Angelpele/Integrated_FOC_BLDC_Actuator/Hardware/Buck Converter.xlsx

Sheet: 16 to 5
Data | Value | Considerations | Operations |  | Real Values
Input Voltage (V) | 16 |  | R(RT/CLK) (KΩ) | 200.01 |  | #VALUE! |  |  | Pin RT_CLK pull down
Output Voltage (V) | 5 |  | Lo min Inductance (H) | 1.305792972e-05 | 1.2e-05 | #VALUE! |  |  |  | Max current rating 100% + Kind of max output
Switching freq (kHz) | 585 | 100 - 2500, the higher more heat | R1 (KΩ) | 52.50 | 52.3 | #VALUE! |  |  | Value for Vsense and obtain correct Vout
Kind | 0.3 | % over max current for ind, decrease for lower ripple | R2 (KΩ) | 10.00 |  | Modify R2 to obtain a proper value for R1
Vref (Slow start) (V) | 0.8 |  | Css (nF) | 15.62
Iss (Slow start current) (uA) | 2 |  | δ (Duty Cycle) | 0.37
tss (Slow start time) (ms) | 5 |  | Max ripple current (mA) | 489.67 |  | #VALUE!
Efficiency | 85% |  | Max voltage ripple (mV) | 50.00 |  | 50 mV for Vout 5V |  | 160mV for 16V
Max Output Current (mA) | 1500 |  | Peak current (mA) | 1744.84 |  | Isat > Ipeak
Resr (mΩ) | 58 |  | Cout (uF) | 20.92617 | 22 | #VALUE! |  |  | Choose largest between both
fc (khz) | 50 | loop BW | Cout (uF) | 23.31002 | 23 | #VALUE! |  |  |  |  | Using ripple current, variation of Iout to 50% of max range
gm(ps) (A/V) | 6 | For this chip
gm(EA) (uA/V) | 97 | For this chip | Reverse voltage max diode | 60 V | B360 | Must be greater than Vin |  |  | Current greater than max out currrent
 |  |  | Gmod(fc) | 0.74 |  | #VALUE!
Rds (on) (Ω) | 0.0024 | For 16V from mosfet | Ro (Ω) = Rload | 3.33
Ids max of mosfet | 40.00 | Limit to 40A | fp (Hz) | 2170.29 |  | #VALUE! |  |  | Power stage pole
Vds (on) | 0.096 | For OC_ADJ pin | fc | 58.50 |  | Second pole | Sw freq / 10
 |  |  | fLC (kHz) or fz1 | 9.80
 |  |  | R3 (kΩ) = Rc | 86.84 | 0402 | #VALUE!
 |  |  | C1 (pF) = Cf (Parallel) | 14.69 |  | #VALUE!
 |  |  | C2 (pF) = Cc (Series) | 844.47 | 1nF | #VALUE!
 |  |  | Cout (RMS current) (mA) | 141.36
 |  |  | Variation Vout | 0.0025

Sheet: 36 to 16
Data | Value | Considerations | Operations |  | Real Values
Input Voltage (V) | 36 |  | R(RT/CLK) (KΩ) | 200.01 |  | #VALUE! | Pin RT_CLK pull down
Output Voltage (V) | 16 |  | Lo min Inductance (H) | 1.857127783e-05 | 2e-05 | #VALUE! |  | Max current rating 100% + Kind of max output
Switching freq (kHz) | 585 | 100 - 2500, the higher more heat | R1 (KΩ) | 190.00 | 52.3
Kind | 0.3 | % over max current for ind | R2 (KΩ) | 10.00
Vref (Slow start) (V) | 0.8 |  | Css (nF) | 15.62
Iss (Slow start current) (uA) | 2 |  | δ (Duty Cycle) | 0.52
tss (Slow start time) (ms) | 5 |  | Max ripple current (mA) | 893.80 |  | (Vin – Vout) × D / (L × f_sw)
Efficiency | 85% |  | Max voltage ripple (mV) | 51.84
Max Output Current (mA) | 1500 |  | Peak current (mA) | 1946.90 |  | Isat > Ipeak
Resr (mΩ) | 58 |  | Cout (uF) | 1.58548 | 49 | 0.09892241379
fc (khz) | 50 | loop BW | Ro (Ω) | 10.67
 |  |  | fp (kHz) | 304.51 |  | Power stage pole
 |  |  | fp2 (kHz) | 292.50 |  | Second pole
 |  |  | fLC (kHz) or fz1 | 5.08
 |  |  | R3 (kΩ) | 15.00
Rds (on) (Ω) | 0.0024 | For 16V from mosfet | C1 (nF) | 2.09
Ids max of mosfet | 40.00 | Limit to 40A | C2 (pF) | 36.27
Vds (on) | 0.096 | For OC_ADJ pin | Cout (RMS current) (mA) | 258.02
 |  |  | Variation Vout | 0.0025

Sheet: Sheet1
Data | Value | Considerations | Operations |  | Real Values
Input Voltage (V) | 16 |  | R(RT/CLK) (KΩ) | 200.01
Output Voltage (V) | 5 |  | R1 (KΩ) | 52.50 | 52.3
Switching freq (kHz) | 585 | 100 - 2500 | R2 (KΩ) | 10.00
Vref (Slow start) (V) | 0.8 |  | Css (nF) | 15.62
Iss (Slow start current) (uA) | 2 |  | δ (Duty Cycle) | 0.37
tss (Slow start time) (ms) | 5 |  | Lo min Inductance (H) | 1.305792972e-05 | 1.2e-05
Efficiency | 85% |  | Max ripple current (mA) | 576.09 |  | (Vin – Vout) × D / (L × f_sw)
Output Current (mA) | 1500 |  | Max voltage ripple (mV) | 33.41
Resr (mΩ) | 58 |  | Peak current (mA) | 1788.04 |  | Isat > Ipeak
fc (khz) | 50 | loop BW | Cout (uF) | 0.49121 | 49 | 0.1534796238
 |  |  | Ro (Ω) | 3.33
 |  |  | fp (kHz) | 974.42 |  | Power stage pole
 |  |  | fp2 (kHz) | 292.50 |  | Second pole
 |  |  | fLC (kHz) or fz1 | 6.56
 |  |  | R3 (kΩ) | 15.00
Rds (on) (Ω) | 0.0024 | For 16V from mosfet | C1 (nF) | 1.62
Ids max of mosfet | 40.00 | Limit to 40A | C2 (pF) | 36.27
Vds (on) | 0.096 | For OC_ADJ pin | Cout (RMS current) (mA) | 166.30
 |  |  | Variation Vout | 0.0025
