Angelpele/Integrated_FOC_BLDC_Actuator/Mechanical/Cycloidal Drive Calculations.xlsx

Data | Value
Np (fixed pins / rollers) | 15 |  | Raducation Ratio | -0.07142857143 | :1
Nd (Lobes of disc) | 14 |  | Reduction Ratio | 14 | :1
No (Out pins) | 7
Input Volt Max V | 40 | Output RPM | 13600 | KV x V |  | Output RPM | 971.4285714
Input Volt V | 16.4 | Output RPM | 5576 |  |  | Output RPM | 398.2857143
Motor KV | 340 | Kt | 0.0281 |  |  | * No effect num discs
 | * 340KV
Input Current Max A | 40 | Torque Nm | 1.12 | Kt x i |  | Torque Nm | 28.31
Input Current A | 20 | Torque Nm | 0.56 |  |  | Torque Nm | 14.16
Efficiency | 0.9
Num discs (Phase Type) | 2
