Angelpele/Integrated_FOC_BLDC_Actuator/Hardware/ESP32_Motor_Controller/ESP32_Motor_Controller_V2.csv

Id | Footprint | Quantity | Designation | Total | Personal Stock | BUY / HIVE
2 | 0201 | 1 | PESDNC2 | 8 | 0 | 8
3 | 0402 | 1 | 3.3k | 8 | 0 | 8 | Number of boards | 8
4 | 0402 | 1 | 0.015uF | 8 | 0 | 8 | Number of hover boards | 2
5 | 0402 | 14 | 0.1 uF | 112 | 0 | 112
6 | 0402 | 1 | 200k | 8 | 0 | 8
7 | 0402 | 3 | 0R | 24 | 0 | 24
8 | 0402 | 2 | 1k | 16 | 0 | 16
9 | 0402 | 9 | 10k | 72 | 0 | 72
10 | 0402 | 2 | 2.2nF | 16 | 0 | 16
11 | 0402 | 4 | 100k | 32 | 0 | 32
12 | 0402 | 1 | 1.6nF | 8 | 0 | 8
13 | 0402 | 1 | 36pF | 8 | 0 | 8
14 | 0402 | 2 | 560pF | 16 | 0 | 16
15 | 0402 | 1 | 15k | 8 | 0 | 8
16 | 0402 | 2 | 56 | 16 | 0 | 16
17 | 0402 | 2 | 1nF | 16 | 0 | 16
18 | 0402 | 1 | 4k7 | 8 | 0 | 8
19 | 0402 | 1 | 0.022uF | 8 | 0 | 8
20 | 0603 | 4 | LED | 32 | 0 | 32
21 | 0603 | 2 | 10k | 16 | 0 | 16
22 | 0603 | 1 | NTC 10k | 8 | 0 | 8
23 | 0603 | 2 | 100R | 16 | 0 | 16
24 | 0603 | 4 | 1uF | 32 | 0 | 32
25 | 0603 | 6 | 22R | 12 | 0 | 12
26 | 0603 | 6 | 10R | 36 | 0 | 36
27 | 0603 | 1 | 2.2uF | 8 | 0 | 8
28 | 0603 | 2 | 56 | 16 | 0 | 16
29 | 0603 | 1 | 47uF | 8 | 0 | 8
30 | 0603 | 1 | 150 | 8 | 0 | 8
31 | 0603 | 4 | 0.1uF | 32 | 0 | 32
32 | 0603 | 1 | 120R | 8 | 0 | 8
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
