Angelpele/Integrated_FOC_BLDC_Actuator/Firmware/PID_tunning/Torque loop Iq and Id - LPF 0.05, Kp 0.7 Ki 20 Kd 0.png

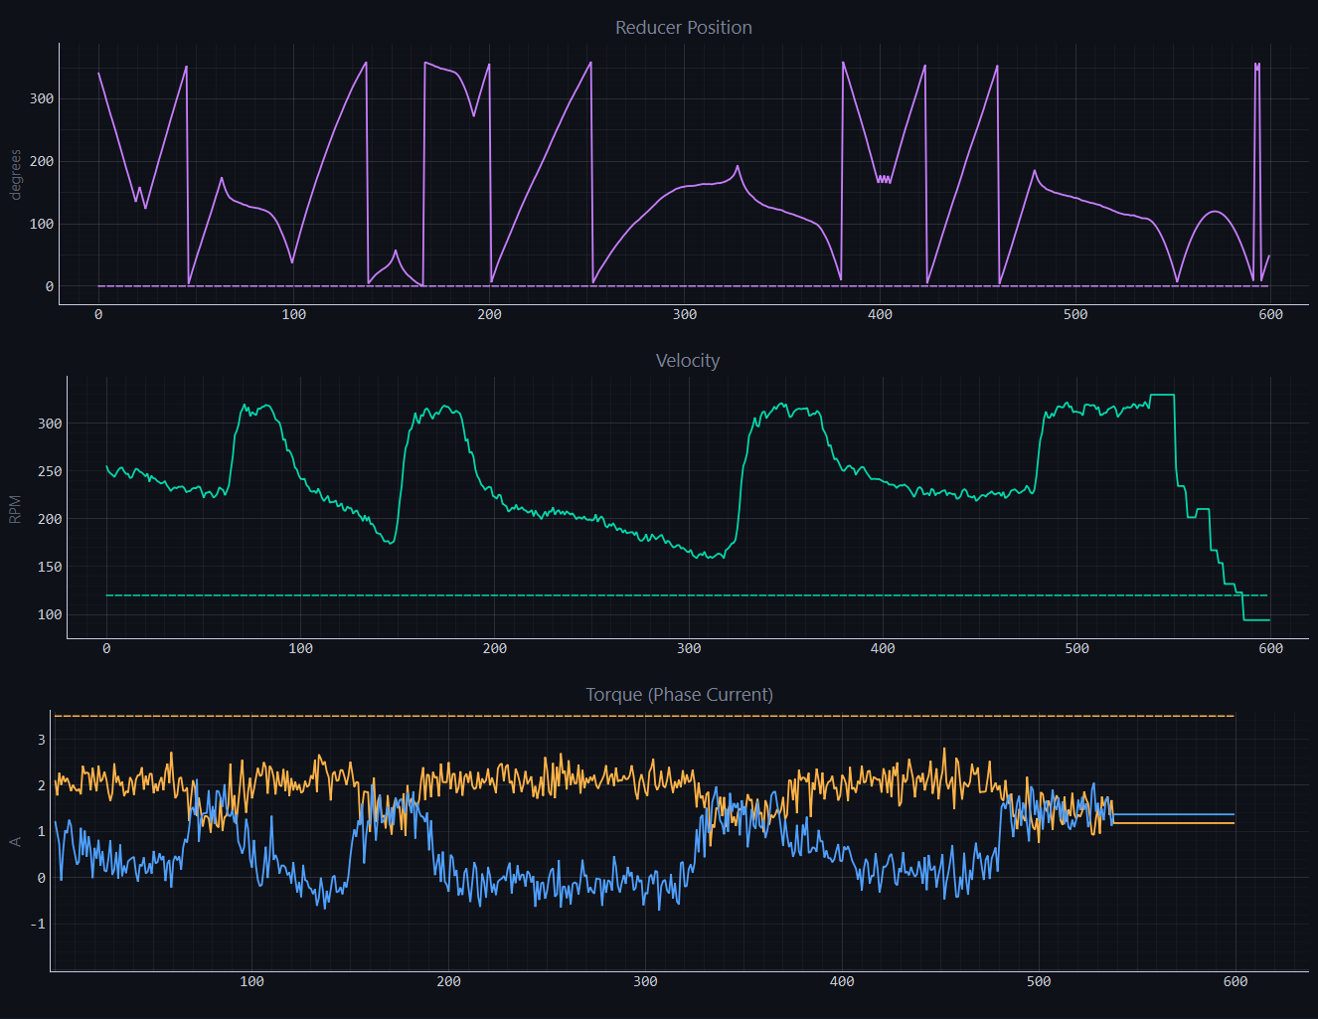
Firmware/PID_tunning/Torque loop Iq and Id - LPF 0.05, Kp 0.7 Ki 20 Kd 0.png
