Angelpele/Integrated_FOC_BLDC_Actuator/Hardware/Typical Application DRV8302 Sch.png

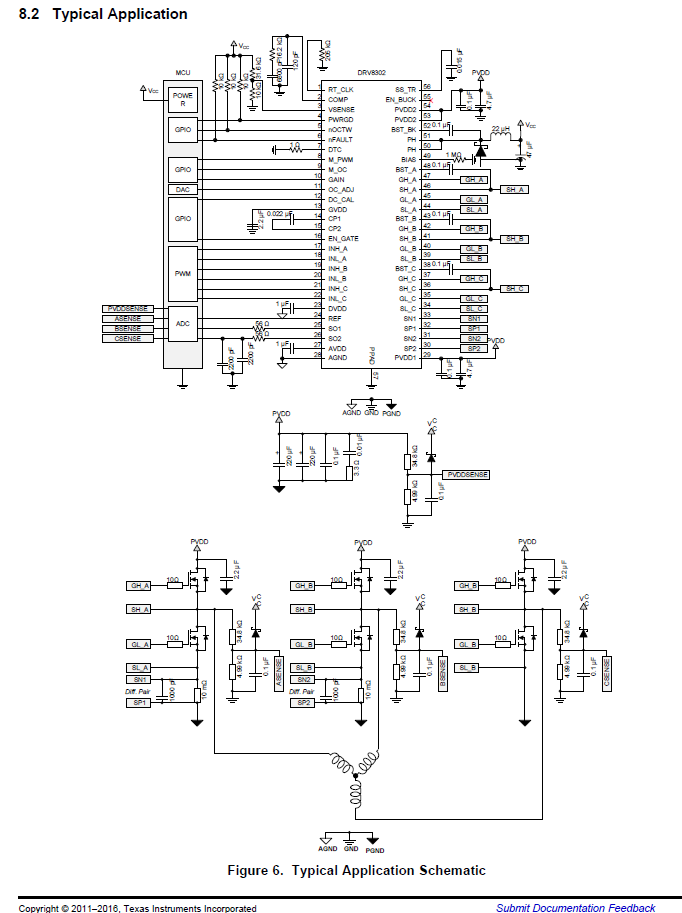
Hardware/Typical Application DRV8302 Sch.png
