Angelpele/Integrated_FOC_BLDC_Actuator/Mechanical/Render_V1.jpg

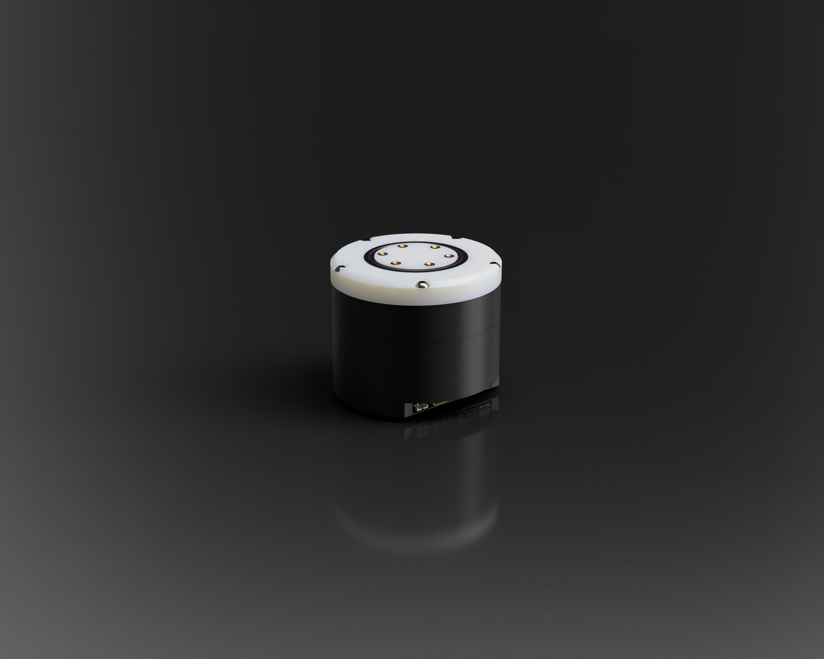
Mechanical/Render_V1.jpg
