Angelpele/Integrated_FOC_BLDC_Actuator/Media/5V_osc_init.jpg

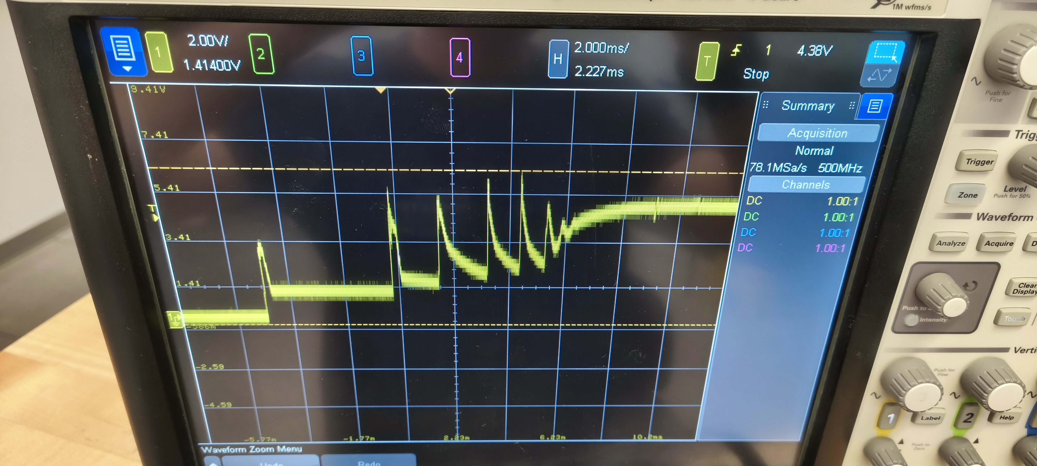
Media/5V_osc_init.jpg
