Angelpele/Integrated_FOC_BLDC_Actuator/Media/1000045218.jpg

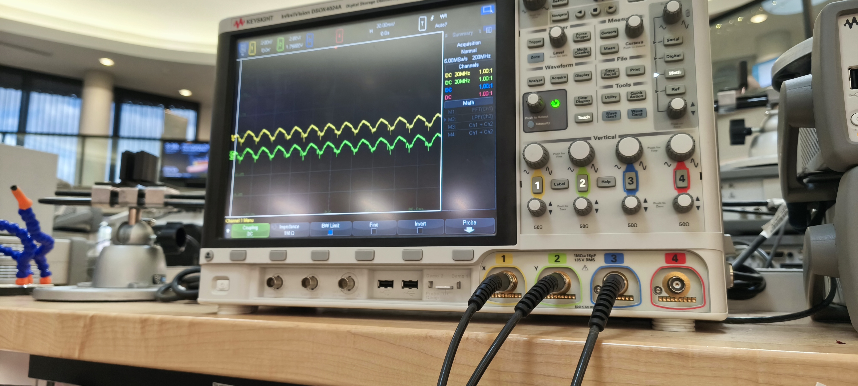
Media/1000045218.jpg
