Angelpele/Integrated_FOC_BLDC_Actuator/Media/1789563761964.jpg

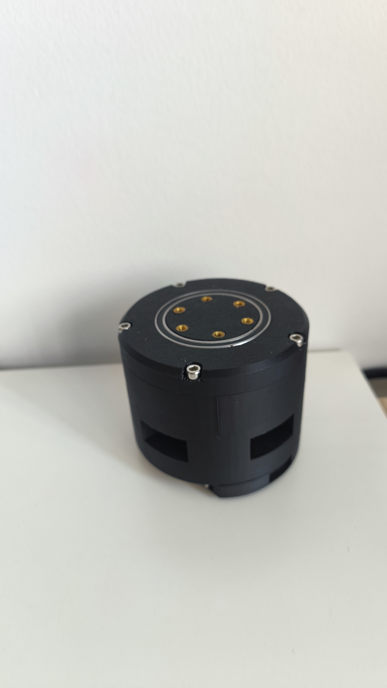
Media/1789563761964.jpg
