Angelpele/Integrated_FOC_BLDC_Actuator/Media/1789563762804.jpg

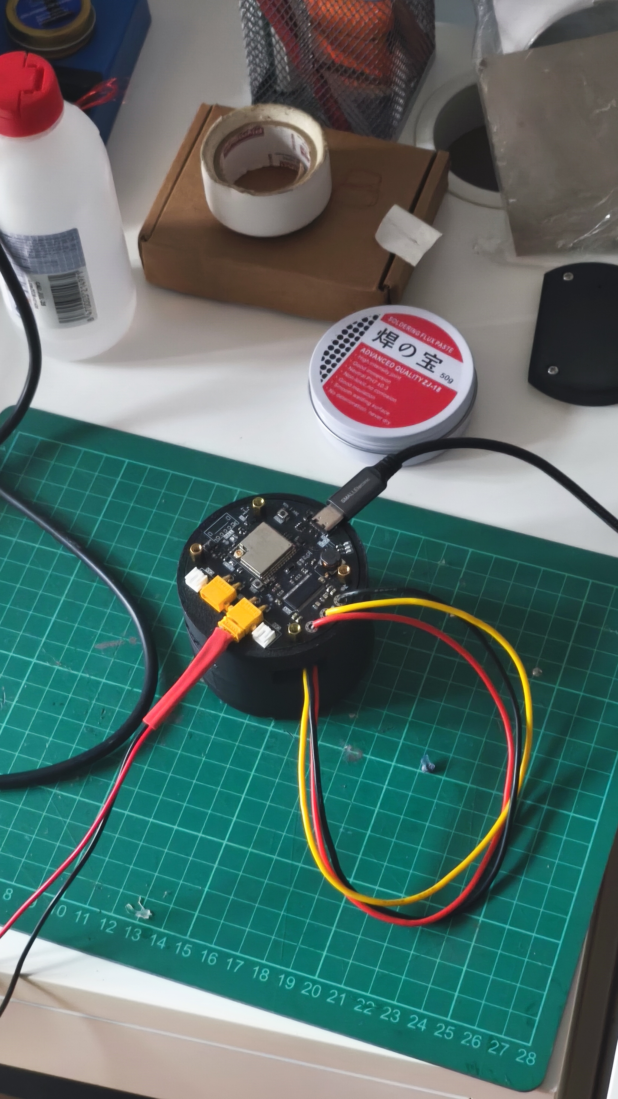
Media/1789563762804.jpg
