Angelpele/Integrated_FOC_BLDC_Actuator/Media/1789563763036.jpg

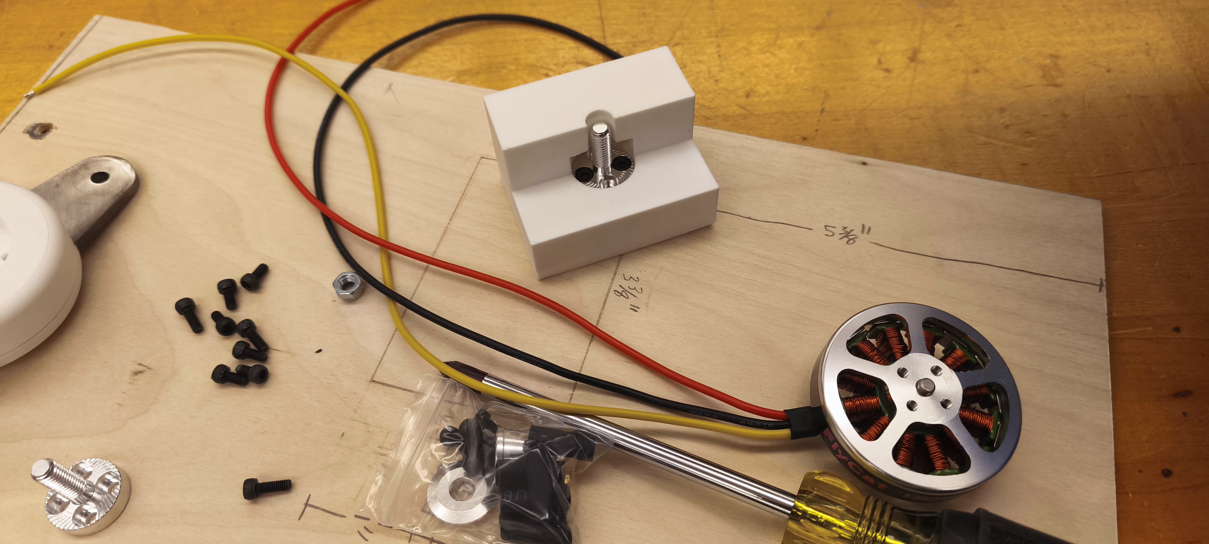
Media/1789563763036.jpg
