Angelpele/Integrated_FOC_BLDC_Actuator/Media/1789563763164.jpg

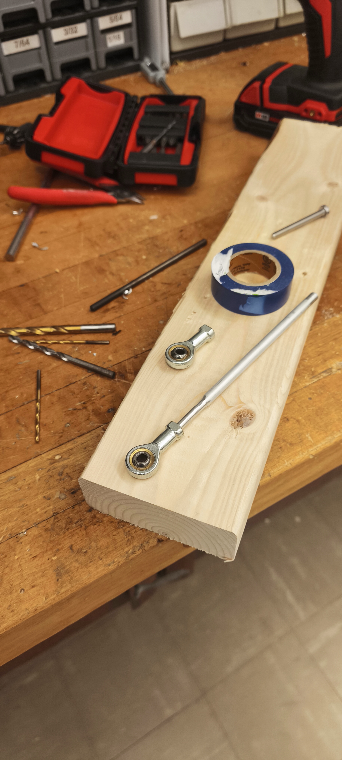
Media/1789563763164.jpg
