Angelpele/Integrated_FOC_BLDC_Actuator/Media/1789563763843.jpg

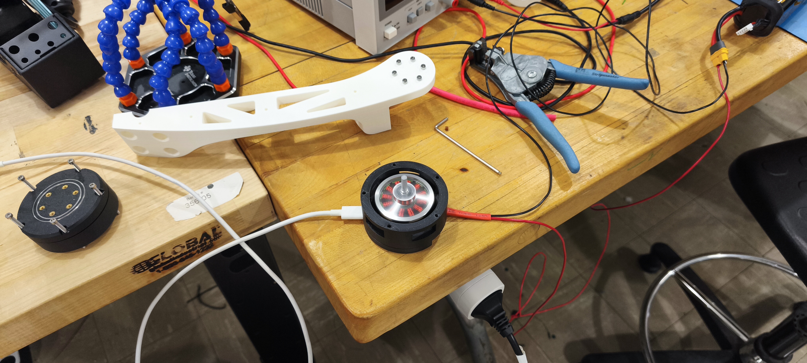
Media/1789563763843.jpg
