Angelpele/Integrated_FOC_BLDC_Actuator/Media/1789563958976.jpg

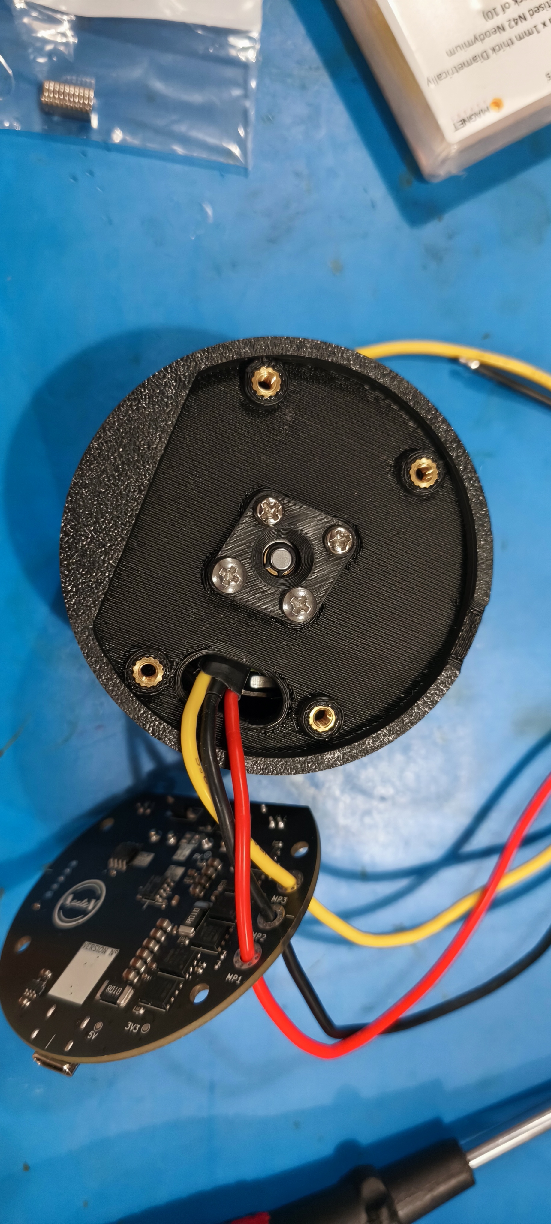
Media/1789563958976.jpg
