Angelpele/Integrated_FOC_BLDC_Actuator/Media/1789563959108.jpg

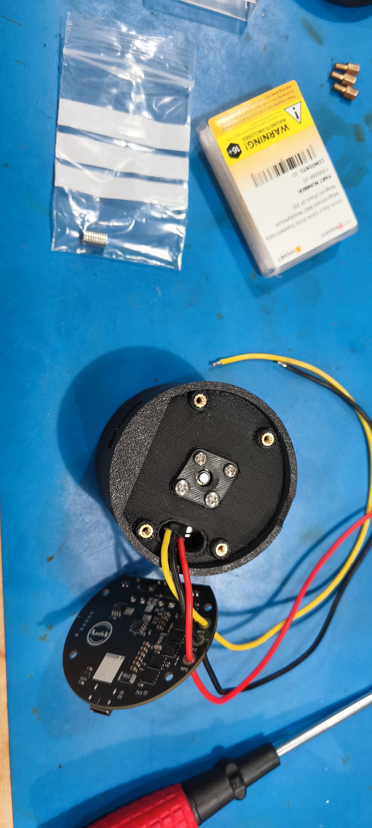
Media/1789563959108.jpg
