Angelpele/Integrated_FOC_BLDC_Actuator/Media/Back View V3.png

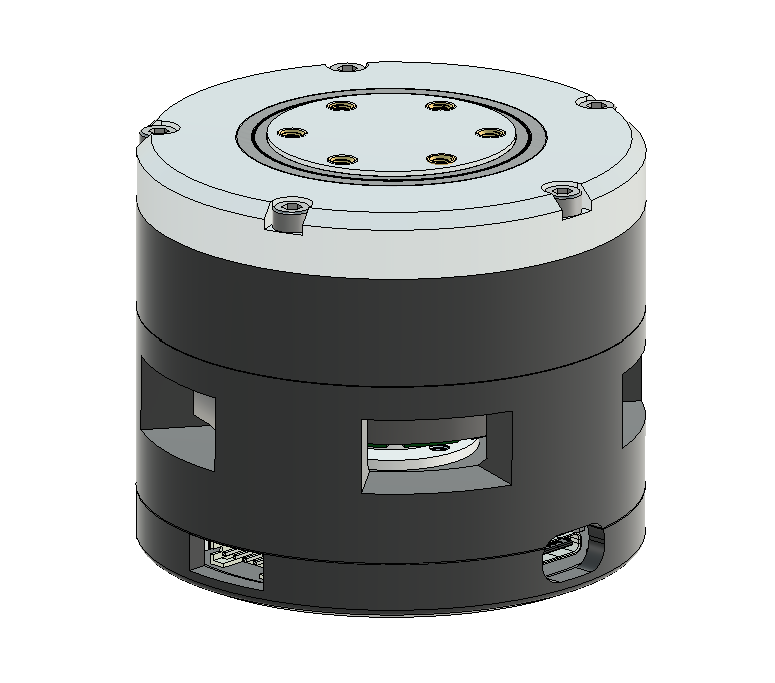
Media/Back View V3.png
