Angelpele/Integrated_FOC_BLDC_Actuator/Media/Bottom_Front View V3.png

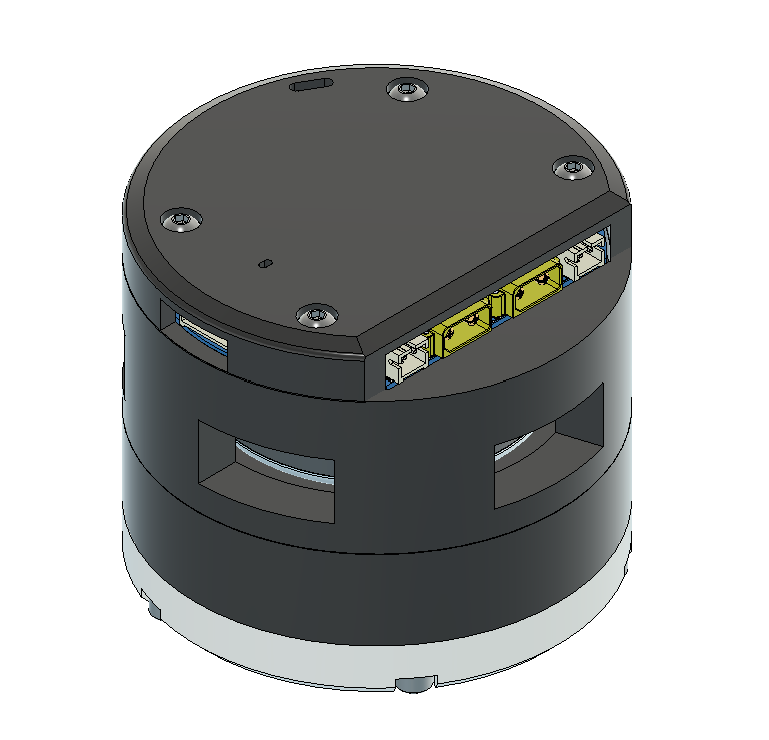
Media/Bottom_Front View V3.png
