Angelpele/Integrated_FOC_BLDC_Actuator/Media/Bottom_Layout_V2.png

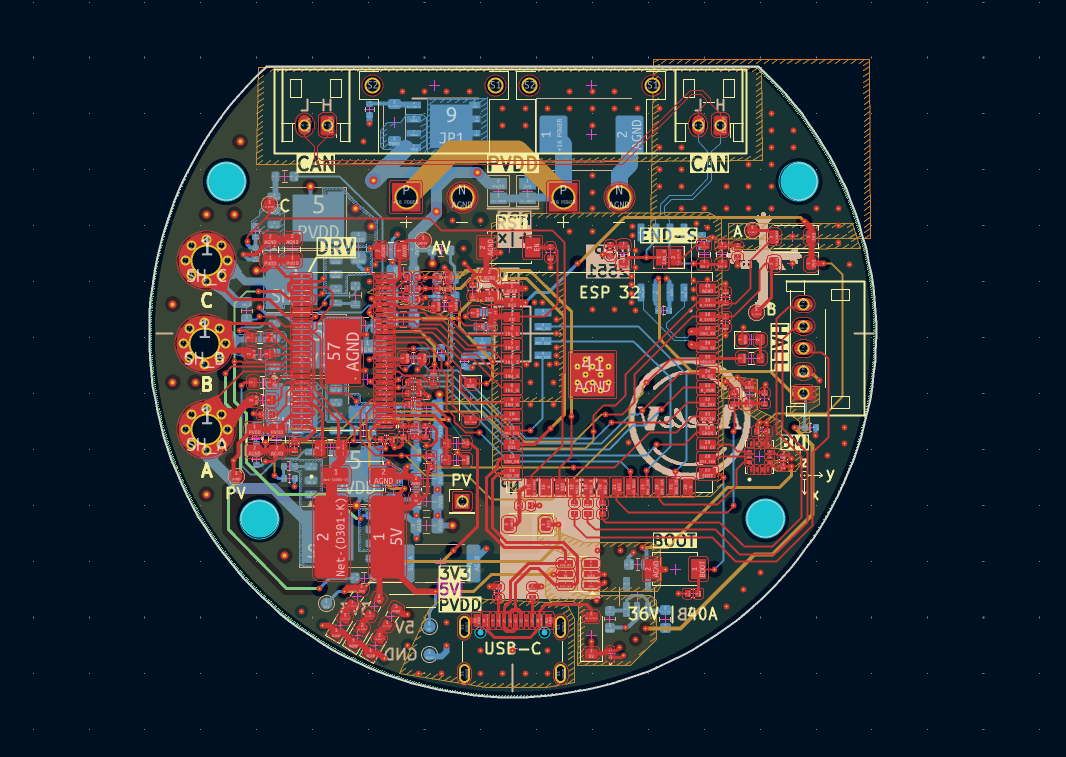
Media/Bottom_Layout_V2.png
