Angelpele/Integrated_FOC_BLDC_Actuator/Media/Capacitor_box.jpg

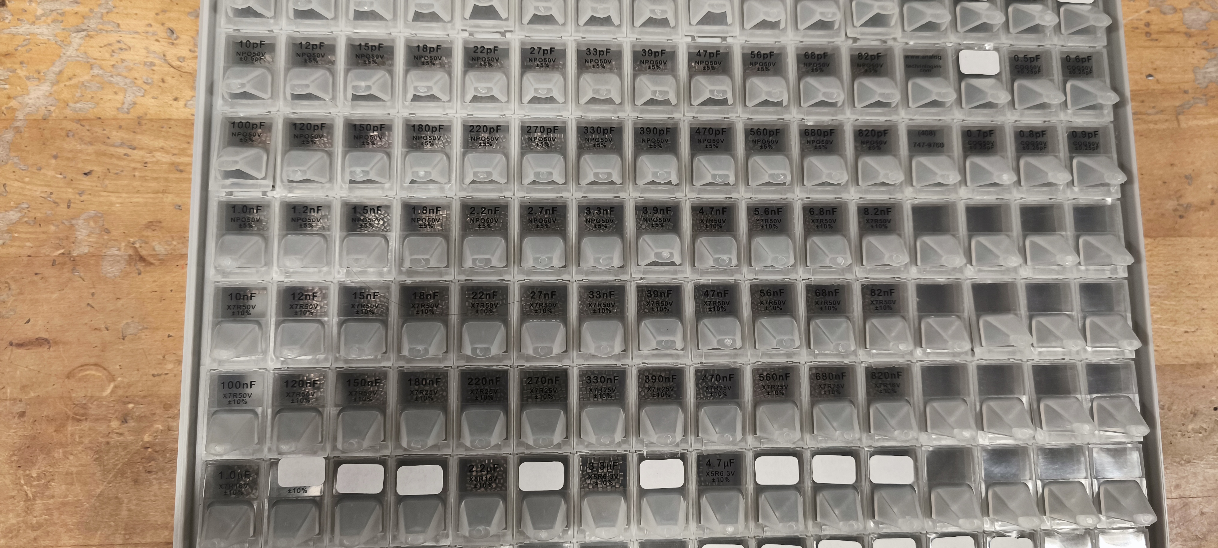
Media/Capacitor_box.jpg
