Angelpele/Integrated_FOC_BLDC_Actuator/Media/Connected_PCB.jpg

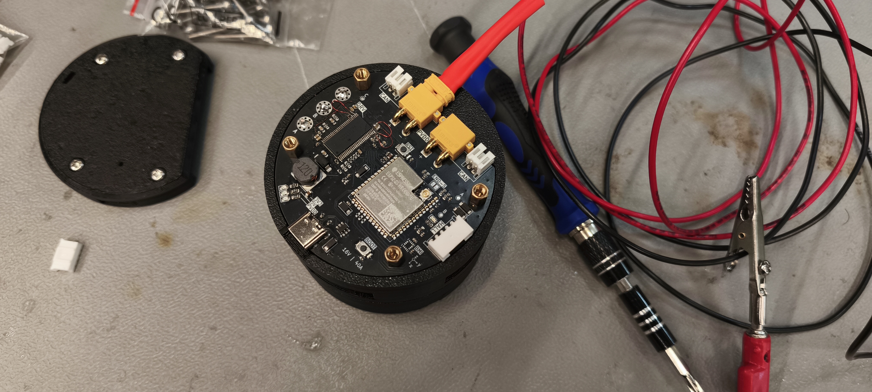
Media/Connected_PCB.jpg
