Angelpele/Integrated_FOC_BLDC_Actuator/Media/Cycloidal Disk.png

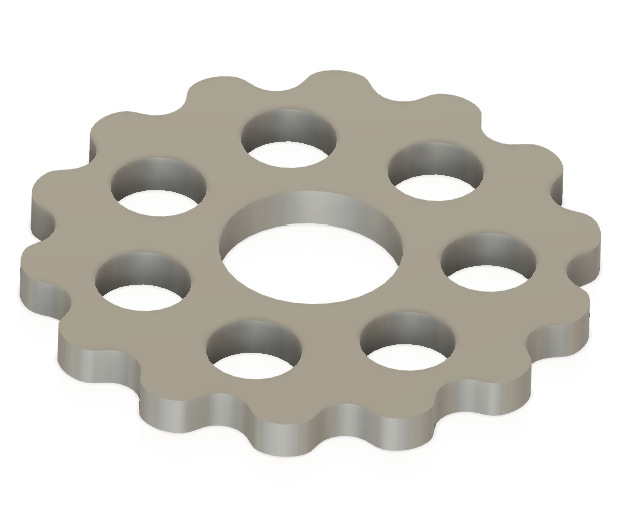
Media/Cycloidal Disk.png
