Angelpele/Integrated_FOC_BLDC_Actuator/Media/Cycloidal Drive Internal.png

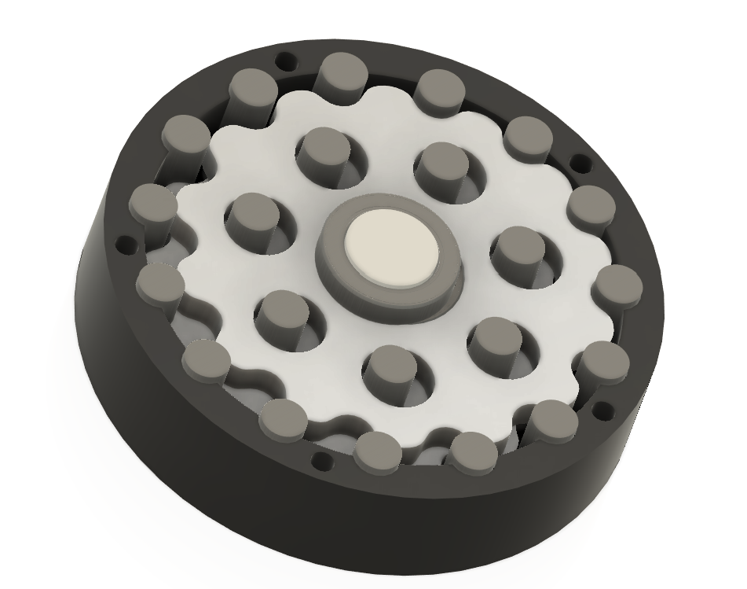
Media/Cycloidal Drive Internal.png
