Angelpele/Integrated_FOC_BLDC_Actuator/Media/Cycloidal Drive Section View V3.png

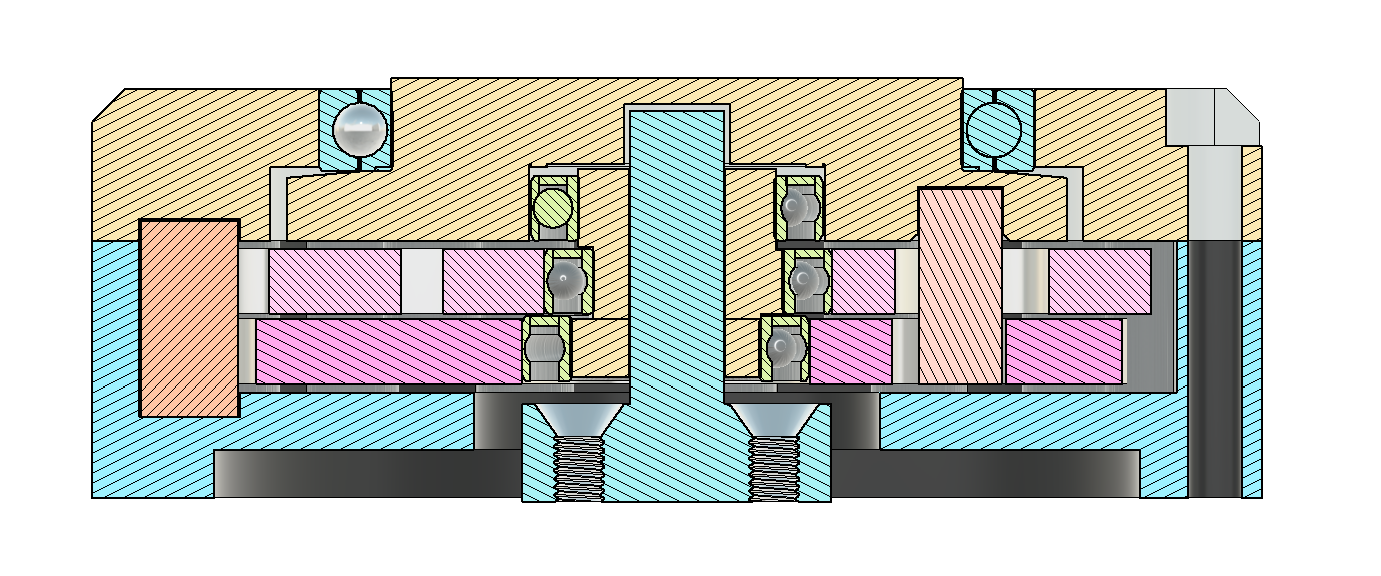
Media/Cycloidal Drive Section View V3.png
