Angelpele/Integrated_FOC_BLDC_Actuator/Media/Cycloidal Drive Section View.png

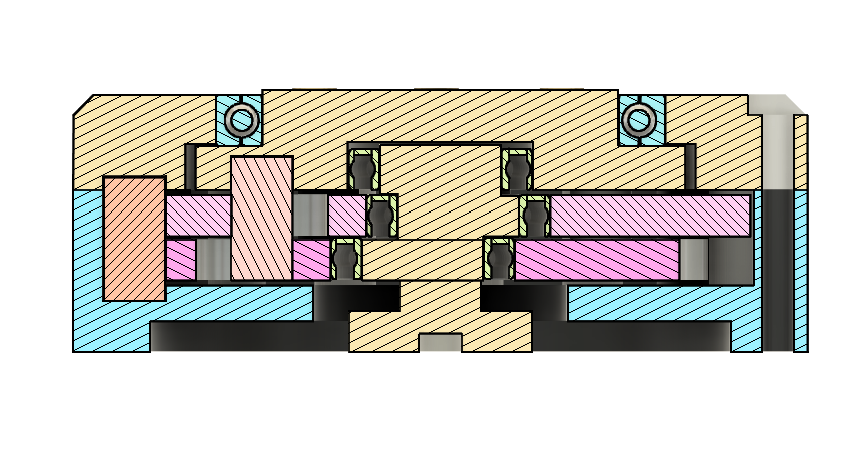
Media/Cycloidal Drive Section View.png
