Angelpele/Integrated_FOC_BLDC_Actuator/Media/D_fillet_creator.jpg

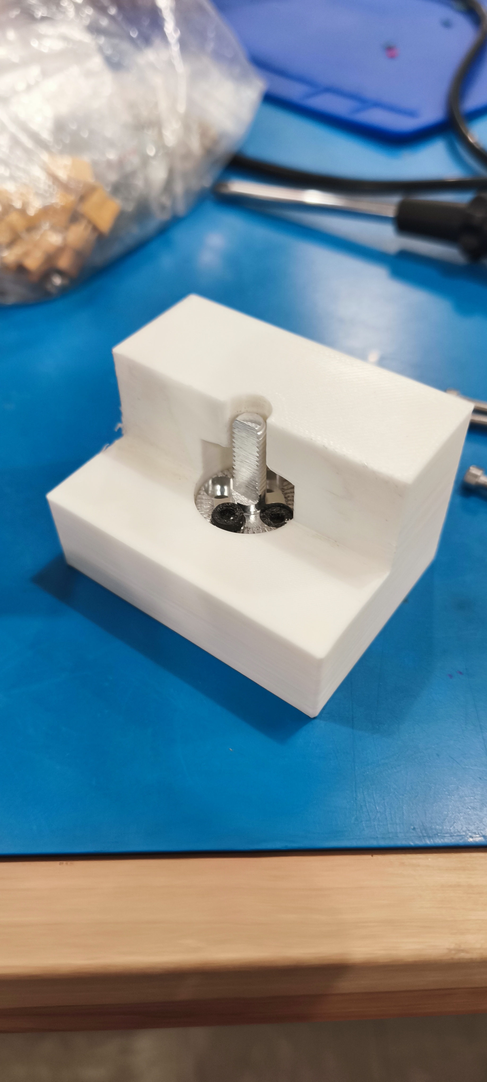
Media/D_fillet_creator.jpg
