Angelpele/Integrated_FOC_BLDC_Actuator/Media/foc_diagram.drawio.png

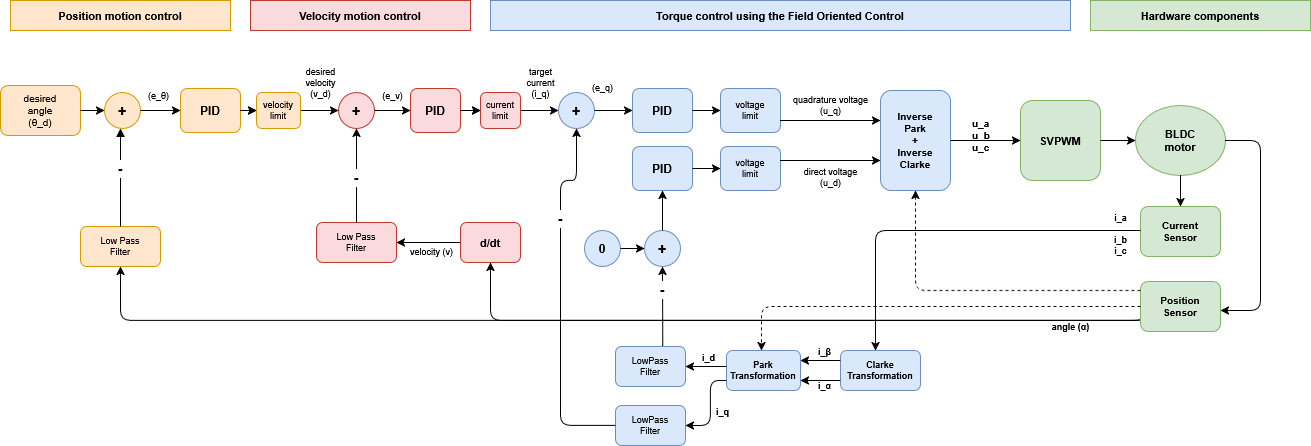
Media/foc_diagram.drawio.png
