Angelpele/Integrated_FOC_BLDC_Actuator/Media/Full_Hive.jpg

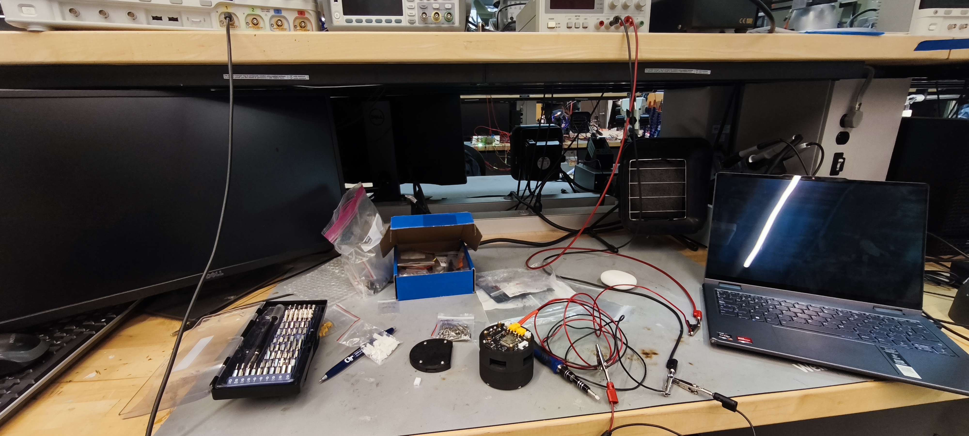
Media/Full_Hive.jpg
