Angelpele/Integrated_FOC_BLDC_Actuator/Media/Hive_Workbench.jpg

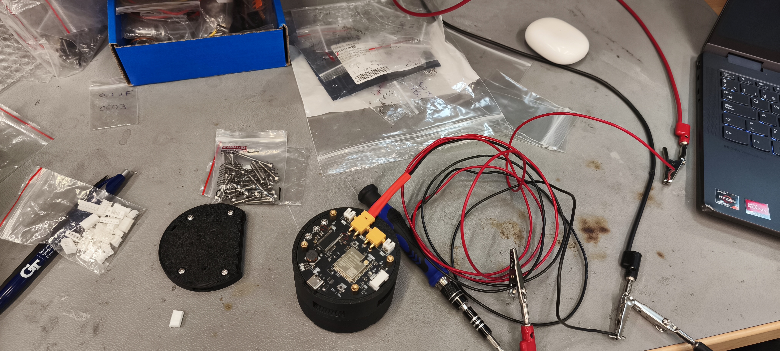
Media/Hive_Workbench.jpg
