Angelpele/Integrated_FOC_BLDC_Actuator/Media/IMG_20251228_104709.jpg

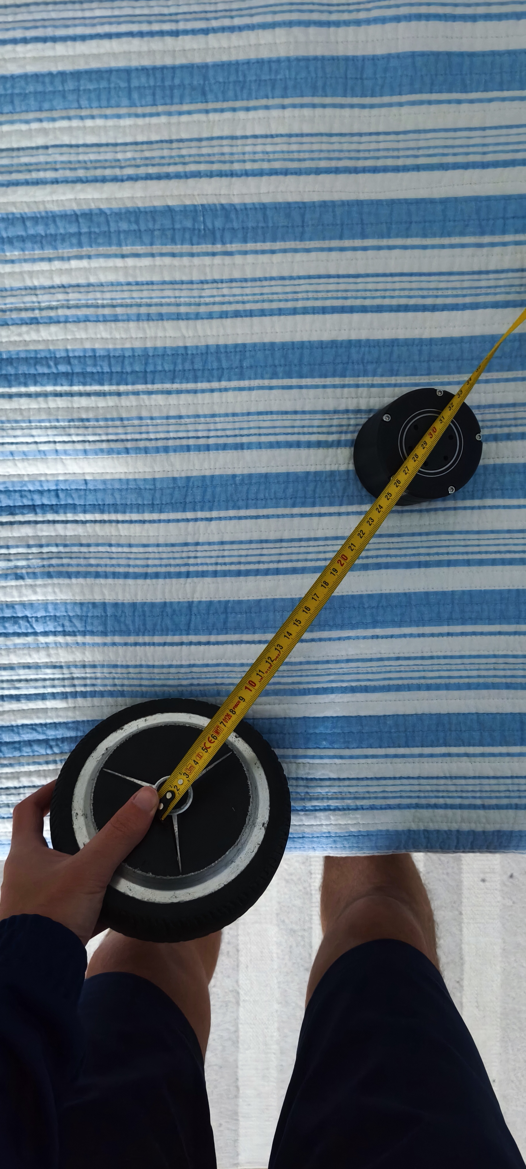
Media/IMG_20251228_104709.jpg
