Angelpele/Integrated_FOC_BLDC_Actuator/Media/Mass_Motor.jpg

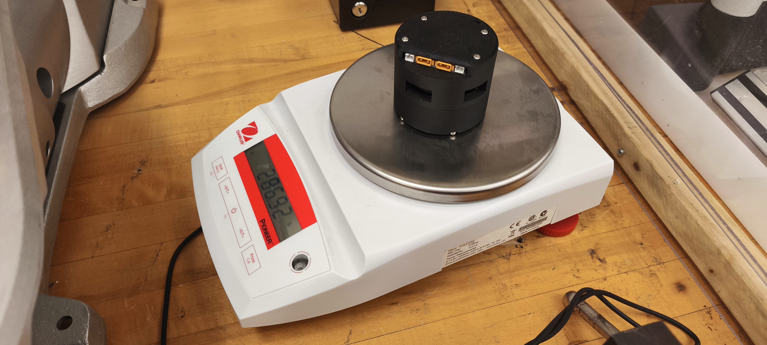
Media/Mass_Motor.jpg
