Angelpele/Integrated_FOC_BLDC_Actuator/Media/MVIMG_20260221_115035.jpg

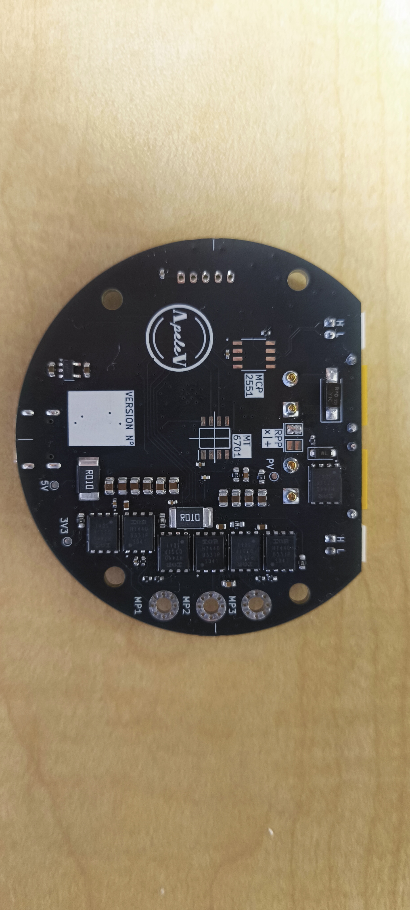
Media/MVIMG_20260221_115035.jpg
