Angelpele/Integrated_FOC_BLDC_Actuator/Media/MVIMG_20260221_172225.jpg

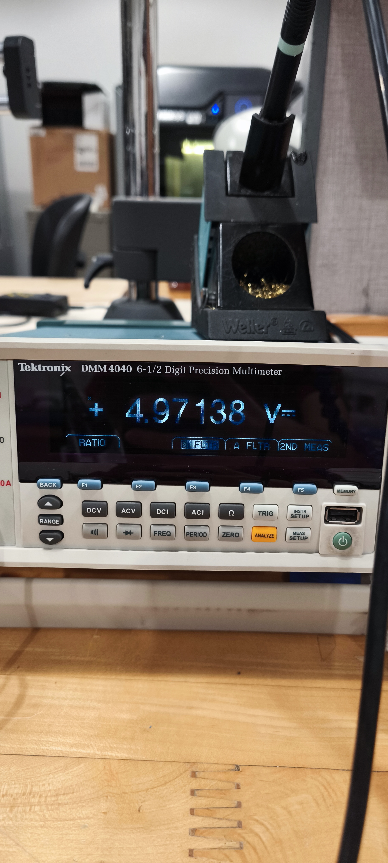
Media/MVIMG_20260221_172225.jpg
