Angelpele/Integrated_FOC_BLDC_Actuator/Media/MVIMG_20260305_144043.jpg

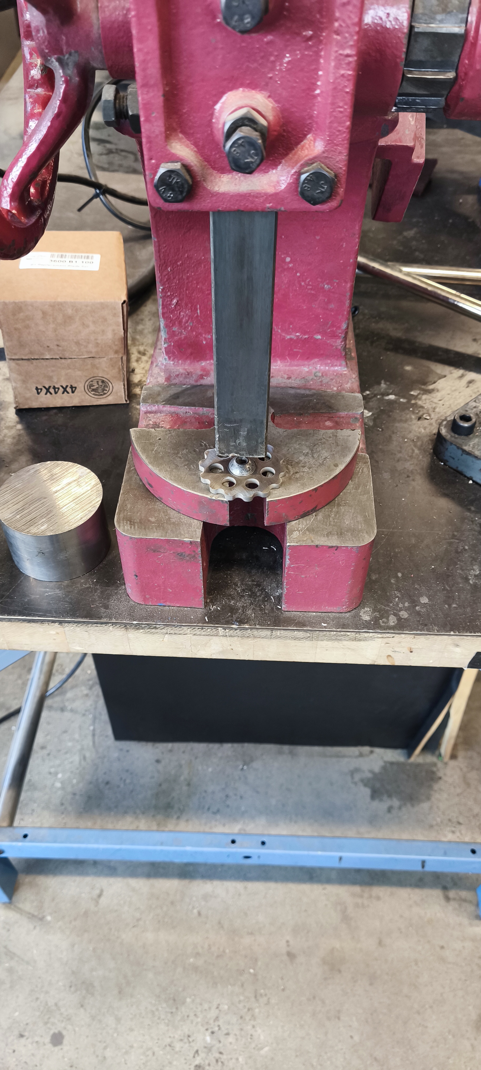
Media/MVIMG_20260305_144043.jpg
