Angelpele/Integrated_FOC_BLDC_Actuator/Media/MVIMG_20260306_131833.jpg

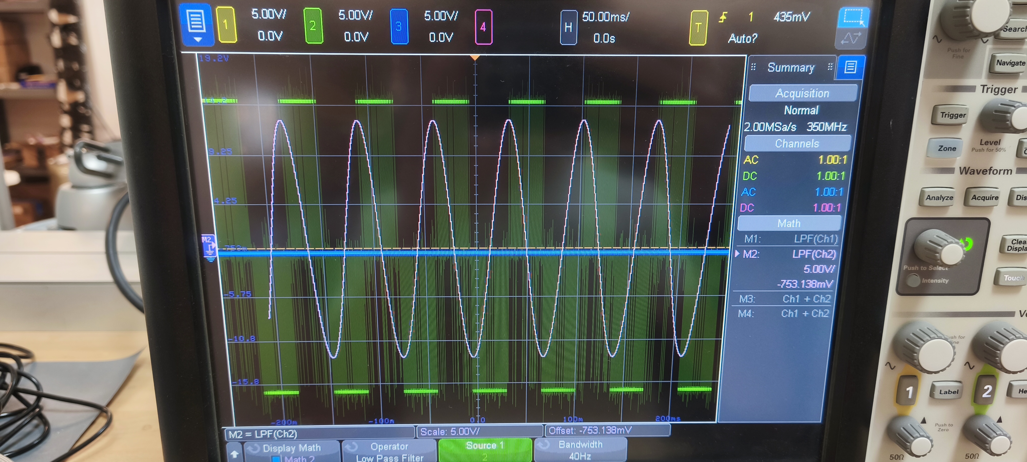
Media/MVIMG_20260306_131833.jpg
