Angelpele/Integrated_FOC_BLDC_Actuator/Media/Output_LDO_3V.jpg

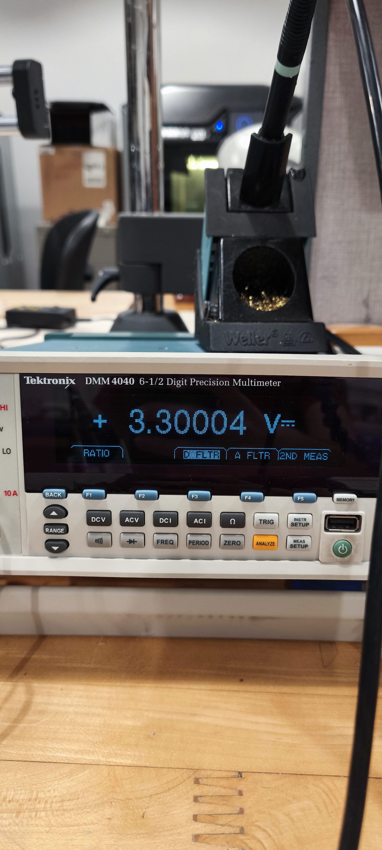
Media/Output_LDO_3V.jpg
