Angelpele/Integrated_FOC_BLDC_Actuator/Media/PCB_down V2.png

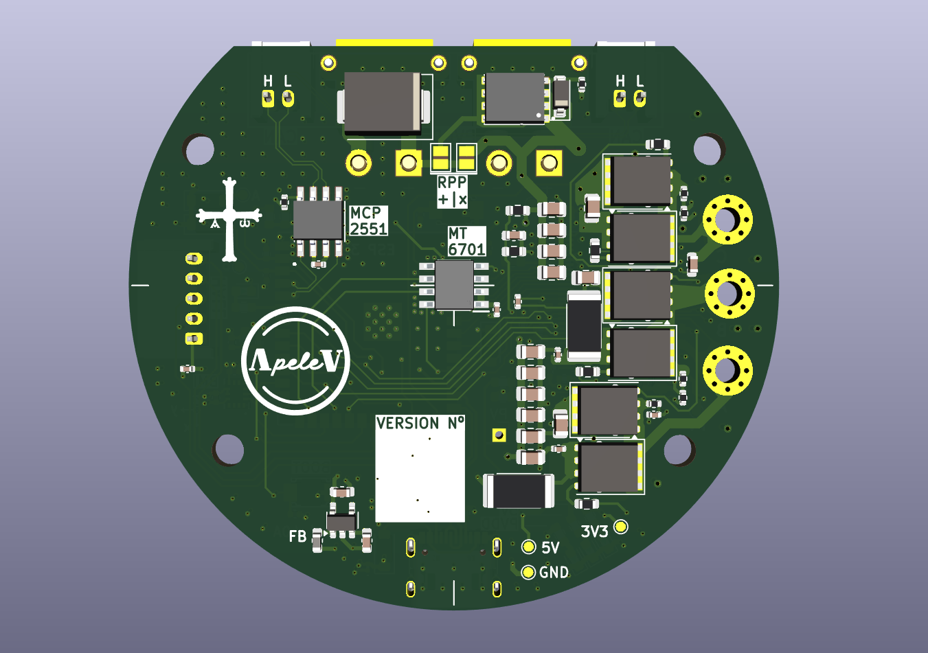
Media/PCB_down V2.png
