Angelpele/Integrated_FOC_BLDC_Actuator/Media/PCB_down.png

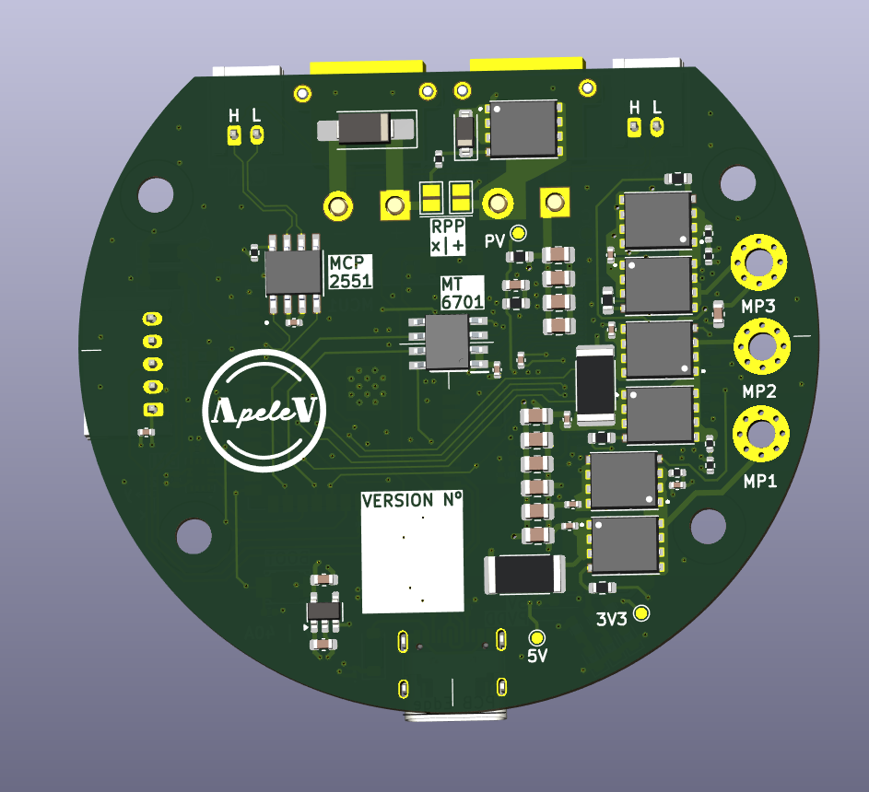
Media/PCB_down.png
