Angelpele/Integrated_FOC_BLDC_Actuator/Media/PCB_top V2.png

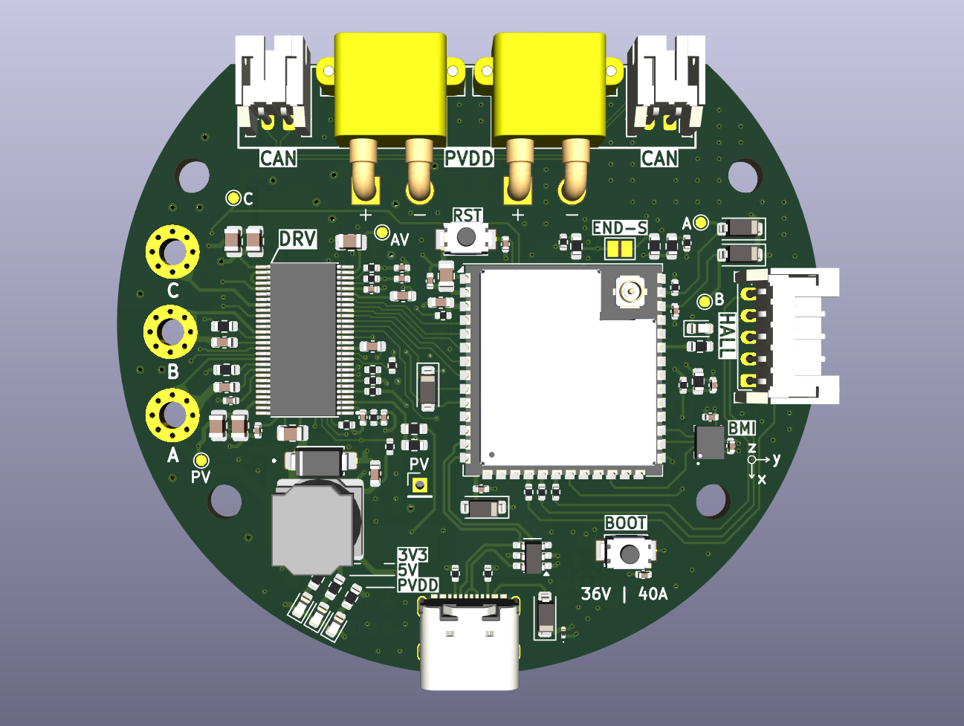
Media/PCB_top V2.png
