Angelpele/Integrated_FOC_BLDC_Actuator/Media/PWM_Output.jpg

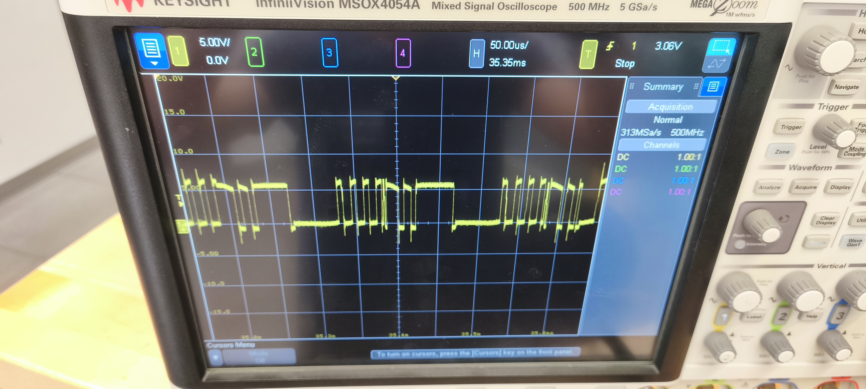
Media/PWM_Output.jpg
