Angelpele/Integrated_FOC_BLDC_Actuator/Media/Screenshot 2025-11-05 171022.png

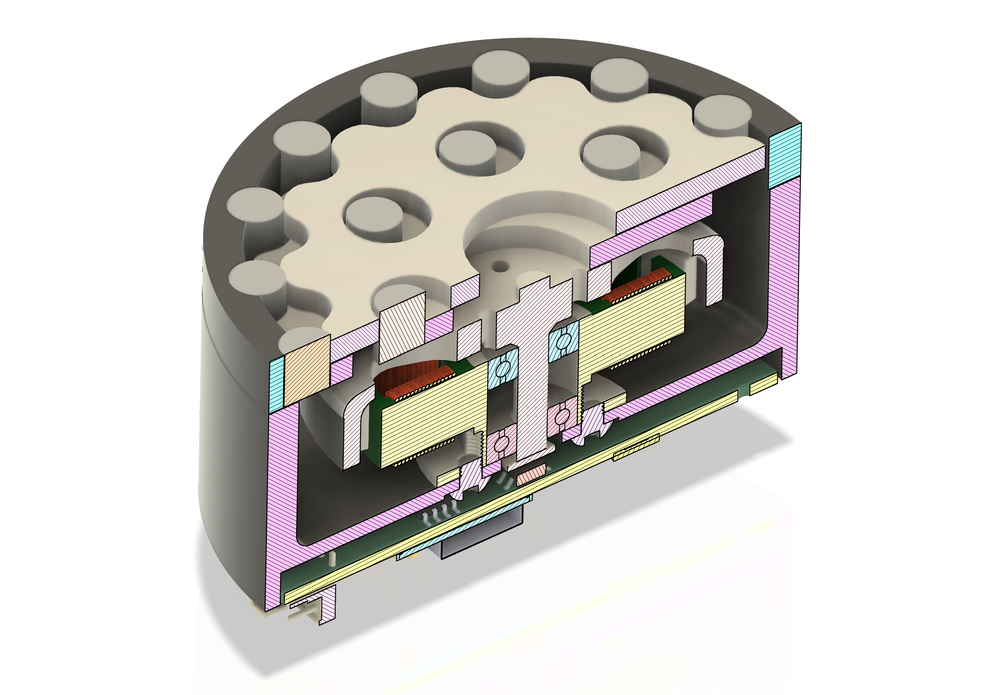
Media/Screenshot 2025-11-05 171022.png
