Angelpele/Integrated_FOC_BLDC_Actuator/Media/Screenshot 2025-11-05 200740.png

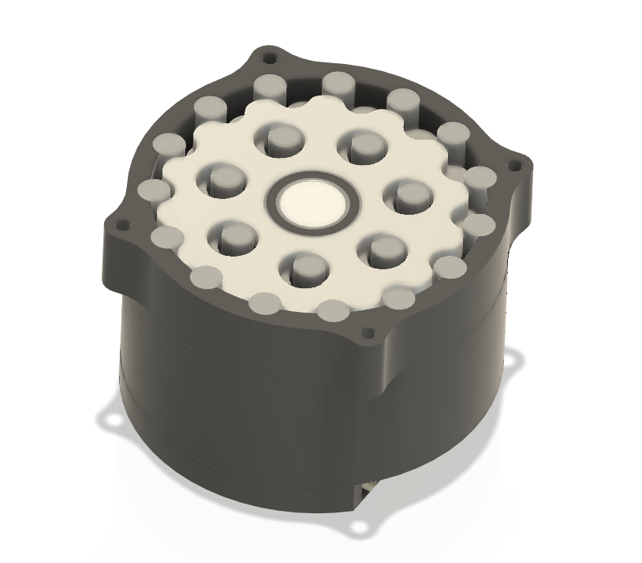
Media/Screenshot 2025-11-05 200740.png
