Angelpele/Integrated_FOC_BLDC_Actuator/Media/Senior_design_lab.jpg

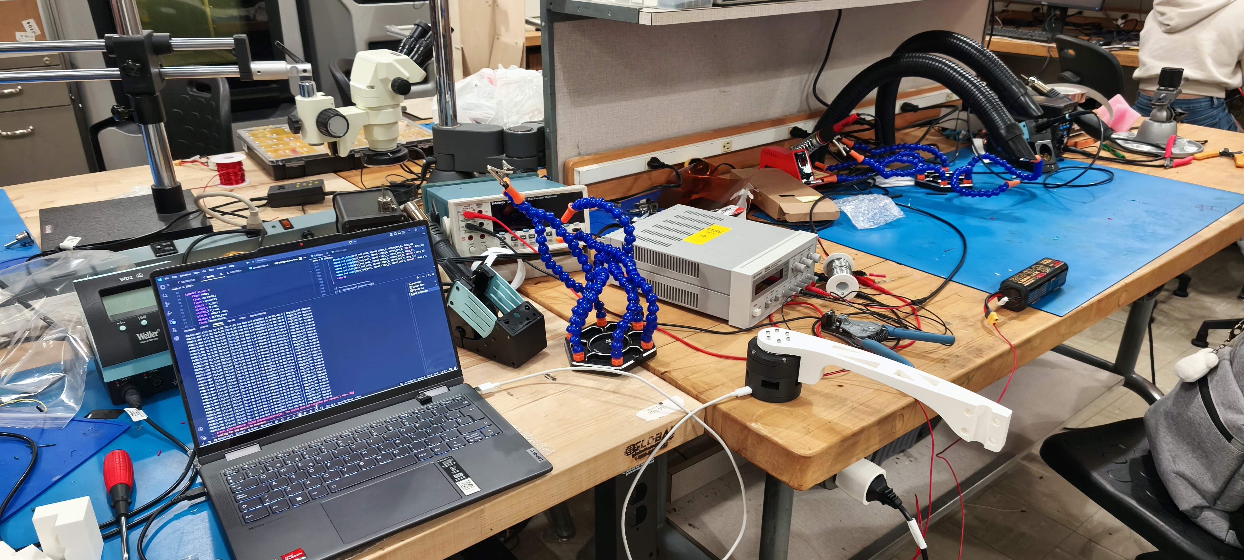
Media/Senior_design_lab.jpg
