Angelpele/Integrated_FOC_BLDC_Actuator/Media/Top PCB.jpg

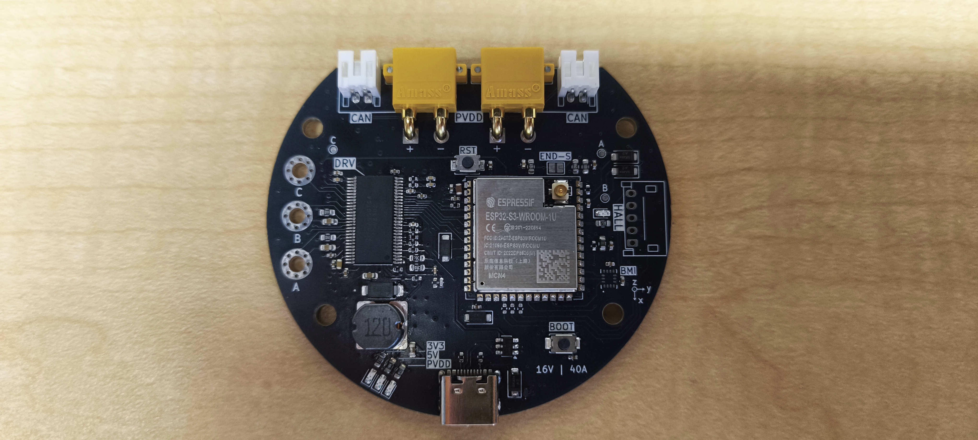
Media/Top PCB.jpg
