Angelpele/Integrated_FOC_BLDC_Actuator/Media/Waterjet Cycloidal.jpg

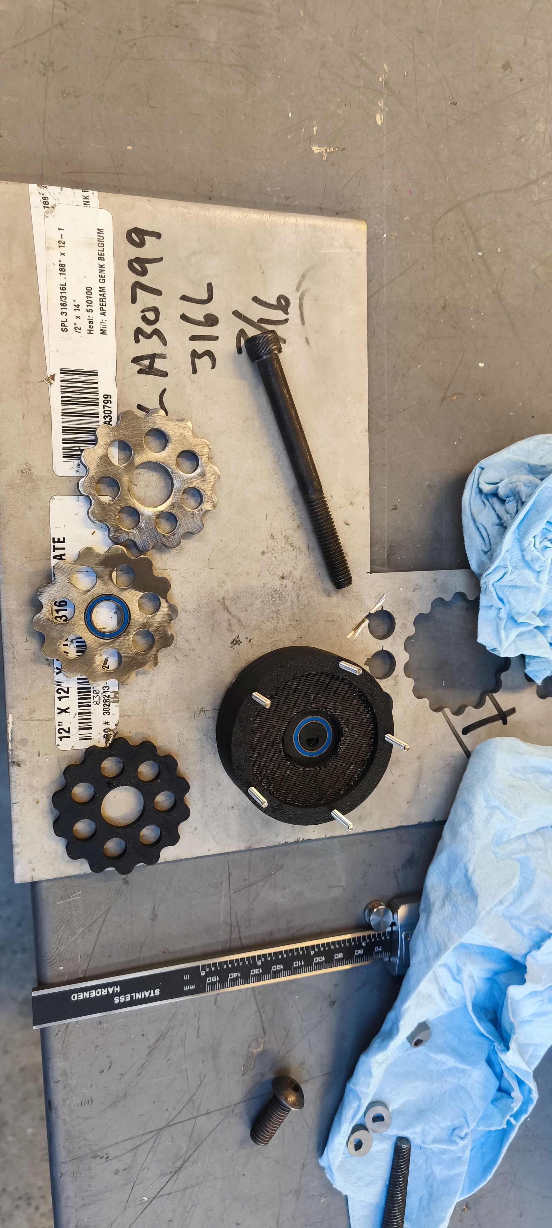
Media/Waterjet Cycloidal.jpg
