Angelpele/Integrated_FOC_BLDC_Actuator/Media/WhatsApp Image 2026-02-19 at 11.42.42 PM.jpeg

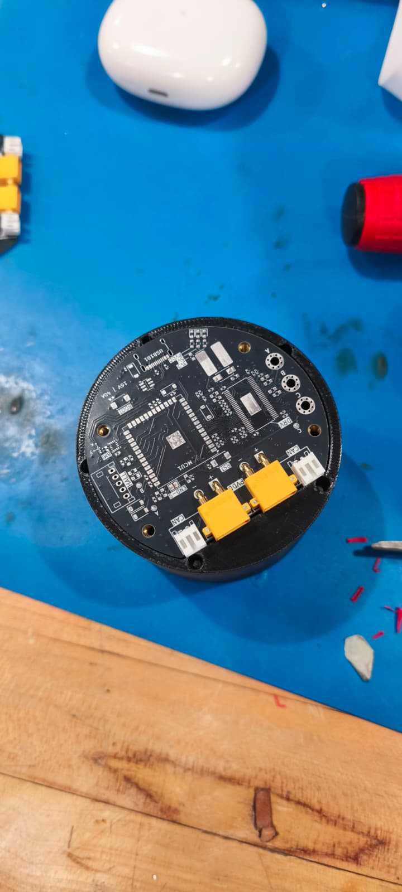
Media/WhatsApp Image 2026-02-19 at 11.42.42 PM.jpeg
