Angelpele/Integrated_FOC_BLDC_Actuator/Software/Cruz_de_Asturias.svg.png

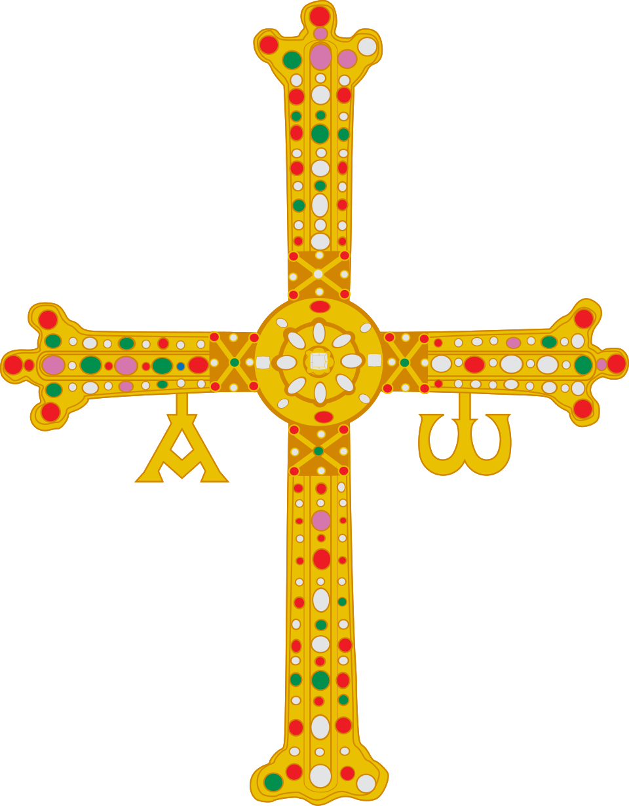
Software/Cruz_de_Asturias.svg.png
