Angelpele/Integrated_FOC_BLDC_Actuator/Software/Flag_of_Asturias.svg.png

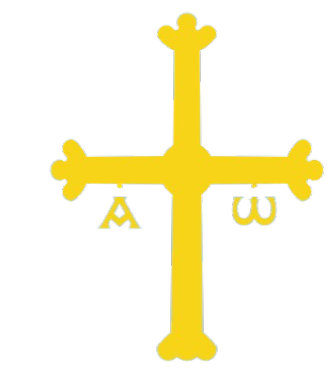
Software/Flag_of_Asturias.svg.png
