Angelpele/Integrated_FOC_BLDC_Actuator/Buying List + BOM V2.xlsx

Sheet: Components
Component | Supplier | Unit Price | Quantity / Board | Total Quantity 6 + 2 | Left to Purchase | Shipping Costs | Purchased | Arrived | Total | Link
N42 Neodymium Diametrically Magnetised Disc Magnet - 1/4 in. dia x 1/32 in. thick (Pack of 10) | First 4 Magnets | $3.85 | 1 | 1 | 0 | $7.00 | Yes | Yes | $10.85 | https://www.first4magnets.com/us/product/n42-neodymium-diametrically-magnetised-disc-magnet-1-4-in-dia-x-1-32-in-thick-20413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
QWinOut High Performance 5010 360KV Disk Brushless Motor with Bullet Cap Mount for DIY FPV Drone Hexacopter Quadcopter MultiCopter | AliExpress | $15.46 | 1 | 2 | 0 | $0.00 | Yes | Yes | $30.91
QWinOut High Performance 5010 750KV Disk Brushless Motor with Bullet Cap Mount for DIY FPV Drone Hexacopter Quadcopter MultiCopter | QWinOut | $17.05 | 1 | 2 | 0 | $0.00 | Yes | Yes | $34.10 | https://qwinout.com/products/qwinout-high-performance-5010-750kv-disk-brushless-motor-with-bullet-cap-mount-for-diy-fpv-drone-hexacopter-quadcopter-multicopte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
Male Female Threaded Hex Standoff 6 mm long, M3 x 0.5 mm | HIVE | $0.00 | 4 | 32 | 0 | $0.00 | Yes | Yes | $0.00 | (Take more for more motors)
6x12mm Solid Pins 30 Units | AliExpress | $3.71 | 3 | 4 | 1 | $1.00 | Yes | Yes | $15.84 | https://es.aliexpress.com/item/1005009576693979.html?curPageLogUid=N1LNBeR6Cvw2
Pedido LCSC Components | LCSC | $61.53 | 1 | 1 | 0 |  | Yes | Yes | $61.53
Pedido PCBs | JLCPCB | $13.23 | 1 | 1 | 0 |  | Yes | Yes | $13.23
PCB V2 + Stencil | JLCPCB | $28.00 | 1 | 1 | 1 | $16.00 | Yes | Yes | $44.00
Rodamiento 35x44x5mm - 2 units | AliExpress | $2.68 | 2 | 3 | 1 | $0.00 | Yes | Yes | $8.04 | https://es.aliexpress.com/item/1005009747825955.html?curPageLogUid=bQdaNbMqlH2g
Rodamiento BEC-7 12x18x4mm 6701RS - 10 units | AliExpress | $2.11 | 2 | 2 | 0 | $0.00 | Yes | Yes | $4.22 | https://es.aliexpress.com/item/1005006952693027.html?curPageLogUid=Fww5FcILrGbL
Printed Cycloidal PLA | HIVE |  | 1 | 6 | 2 |  | Yes | Yes | $0.00
Cycloidal Disc 1 | Invention - SS | $0.00 | 1 | 6 | 6 | $0.00 | Yes | Yes | $0.00
Cycloidal Disc 2 | Invention - SS | $0.00 | 1 | 6 | 6 | $0.00 | Yes | Yes | $0.00
BHSBHCS ASME B18.3.4M - M3 x 0.5 x 3 Steel Grade 2 Plain | Senior Lab | $0.00 | 4 | 24 | 0 | $0.00 | Yes | Yes | $0.00
BHSBHCS ASME B18.3.4M - M3 x 0.5 x 4 Steel Grade 2 Plain | Senior Lab | $0.00 | 4 | 24 | 0 | $0.00 | Yes | Yes | $0.00
Hexagon Socket Head- M3 x 0.5 x 45 Steel Grade 2 Plain (48 mm rosca) | Invention | $0.00 | 5 | 30 | 0 | $0.00 | Yes | Yes | $0.00
M8 HoverBoard Screw | Home | $0.00 | 1 | 8 | 0 |  | Yes | Yes | $0.00
Link Motor Screw M3 20mm | Senior Lab | $0.00 | 6 | 36 | 0 |  | Yes | Yes | $0.00
Threaded inserts M3 6 mm Output | Senior Lab | $0.00 | 4 | 24 | 0 |  | Yes | Yes | $0.00
Threaded inserts M3 4 mm Output | Senior Lab | $0.00 | 6 | 36 | 0 |  | Yes | Yes | $0.00
5mm PIN | Invention - Screws | $0.00 | 1 | 2 | 0 |  | Yes | Yes | $0.00
10mm PIN | Invention - Screws | $0.00 | 1 | 2 | 0 |  | Yes | Yes | $0.00
M5 Rounded head link | Invention - Screws | $0.00 | 1 | 2 | 0 |  | Yes | Yes | $0.00
M5 Thread Rod Joint End | AliExpress | $3.97 | 1 | 2 | 0 |  | Yes | Yes | $7.94
 |  |  |  |  | 0 |  | Yes | Yes | $0.00
Main Asturion PCB + Smaller Stencil | JLCPCB | $11.15 | 1 | 1 | 0 | $24.01 | Yes | No | $35.16
2nd Component Order | LCSC | $154.83 | 1 | 1 | 0 |  | Yes | No | $154.83
Soldering Air Station | Amazon | $57.50 | 1 | 1 | 0 |  | Yes | Yes | $57.50
 |  |  |  |  |  |  |  |  | $0.00
Hexagon = Cylindrical head + allen socket |  |  |  |  |  |  |  |  | $0.00
ASME = Rounded head + allen socket |  |  |  |  |  |  |  |  | $0.00
 |  |  |  |  |  |  |  |  | $0.00
 |  |  |  |  |  |  |  |  | $478.15

Sheet: Electrical BOM
Id | Footprint | Quantity Motor | Quantity Asturion | Designation | Voltage comp | Voltage requirements | Total | Personal Stock | BUY / HIVE
2 | 2512 | 2 | 0 | 0.01R |  |  | 14 | 10 | 4 | LCSC | TRUE |  |  |  |  | 1
3 | 0201 | 1 | 1 | PESDNC2 |  |  | 8 | 100 | 0 |  | TRUE | Number of controllers | 7 | Number Asturion | 1 | 0
4 | 0402 | 4 | 0 | 0R |  |  | 28 |  | 28 |  | TRUE |  |  |  |  | 1
5 | 0402 | 2 | 0 | 3.3k |  |  | 14 |  | 14 |  | TRUE | Number of hover boards | 2 |  |  | 1
6 | 0402 | 0 | 1 | 15pF |  |  | 1 | 0 | 1 |  | TRUE |  |  |  |  | 1
7 | 0402 | 1 | 1 | 0.015uF |  |  | 8 |  | 8 |  | TRUE |  |  |  |  | 1
8 | 0402 | 14 | 4 | 0.1 uF | 10V | Max 5V | 102 | 500 | 0 |  | TRUE |  |  |  |  | 0
9 | 0402 | 1 | 1 | 200k |  |  | 8 |  | 8 |  | TRUE |  |  |  |  | 1
10 | 0402 | 9 | 3 | 10k |  |  | 66 |  | 66 |  | TRUE |  |  |  |  | 1
11 | 0402 | 2 | 0 | 2.2nF |  |  | 14 | 100 | 0 |  | TRUE |  |  |  |  | 0
12 | 0402 | 0 | 20 | 100 |  |  | 20 |  | 20 |  | TRUE |  |  |  |  | 1
13 | 0402 | 4 | 0 | 100k |  |  | 28 |  | 28 |  | TRUE |  |  |  |  | 1
14 | 0402 | 2 | 4 | 5.1k |  |  | 18 |  | 18 |  | TRUE |  |  |  |  | 1
15 | 0402 | 2 | 2 | 560pF |  |  | 16 |  | 16 |  | TRUE |  |  |  |  | 1
16 | 0402 | 1 | 1 | 86.6k |  |  | 8 |  | 8 |  | TRUE |  |  |  |  | 1
17 | 0402 | 2 | 0 | 56 |  |  | 14 |  | 14 |  | TRUE |  |  |  |  | 1
18 | 0402 | 3 | 1 | 1nF | 50V |  | 22 |  | 22 |  | TRUE |  |  |  |  | 1
19 | 0402 | 1 | 1 | 4k7 |  |  | 8 | 20 | 0 |  | TRUE |  |  |  |  | 0
20 | 0402 | 1 | 0 | 0.022uF | 16V |  | 7 |  | 7 |  | TRUE |  |  |  |  | 1
21 | 0603 | 4 | 3 | LED |  |  | 31 | 100 | 0 |  | TRUE |  |  |  |  | 0
22 | 0603 | 2 | 2 | 10k |  |  | 16 | 200 | 0 |  | TRUE |  |  |  |  | 0
23 | 0603 | 1 | 1 | NTC 10k |  |  | 8 | 20 | 0 |  | TRUE |  |  |  |  | 0
24 | 0603 | 0 | 2 | 27pF |  |  | 2 |  | 2 |  | TRUE |  |  |  |  | 1
25 | 0603 | 1 | 0 | 15pF |  |  | 7 |  | 7 |  | TRUE |  |  |  |  | 1
26 | 0603 | 0 | 2 | 6.8nF |  |  | 2 | 0 | 2 |  | TRUE |  |  |  |  | 1
27 | 0603 | 2 | 2 | 100R |  |  | 16 |  | 16 |  | TRUE |  |  |  |  | 1
28 | 0603 | 4 | 3 | 1uF | 6.3V | Max 5V | 31 |  | 31 |  | TRUE |  |  |  |  | 1
29 | 0603 | 0 | 1 | 3.3k |  |  | 1 |  | 1 |  | TRUE |  |  |  |  | 1
30 | 0603 | 6 | 0 | 10R |  |  | 42 |  | 42 |  | TRUE |  |  |  |  | 1
31 | 0603 | 1 | 0 | 2.2uF | 16V - 30 from Senior |  | 7 | 0 | 7 | LCSC | TRUE |  |  |  |  | 1
32 | 0603 | 2 | 0 | 56 |  |  | 14 |  | 14 |  | TRUE |  |  |  |  | 1
33 | 0603 | 0 | 2 | 21.5k |  |  | 2 |  | 2 |  | TRUE |  |  |  |  | 1
34 | 0603 | 1 | 1 | 52.3k |  |  | 8 | 50 | 0 |  | TRUE |  |  |  |  | 0
35 | 0603 | 1 | 1 | 150R |  |  | 8 |  | 8 |  | TRUE |  |  |  |  | 1
36 | 0603 | 4 | 8 | 0.1uF | 16V | Required GH | 36 | 100 | 0 | Can be changed by 0805 50V | TRUE |  |  |  |  | 0
37 | 0603 | 1 | 1 | 121R |  |  | 8 |  | 8 |  | TRUE |  |  |  |  | 1
38 | 0603 | 1 | 1 | 1100 |  |  | 8 |  | 8 |  | TRUE |  |  |  |  | 1
39 | 0603 | 1 | 6 | 100k |  |  | 13 |  | 13 |  | TRUE |  |  |  |  | 1
40 | 0805 | 2 | 6 | 22uF | 25V | 3V3 | 20 | 40 | 0 | LCSC | TRUE |  |  |  |  | 0
41 | 0805 | 3 | 0 | 0.1 uF | 50V |  | 21 | 200 | 0 |  | TRUE |  |  |  |  | 0
42 | 0805 | 0 | 1 | 330nF |  |  | 1 | 0 | 1 |  | TRUE |  |  |  |  | 1
43 | 0805 | 0 | 1 | 1M0 |  |  | 1 | 0 | 1 |  | TRUE |  |  |  |  | 1
44 | 0805 | 0 | 1 | 100k |  |  | 1 | 0 | 1 |  | TRUE |  |  |  |  | 1
45 | 0805 | 0 | 5 | 10k |  |  | 5 | 100 | 0 |  | TRUE |  |  |  |  | 0
46 | 0805 | 0 | 1 | 470 |  |  | 1 | 0 | 1 |  | TRUE |  |  |  |  | 1
47 | 0805 | 0 | 1 | 1k |  |  | 1 | 50 | 0 |  | TRUE |  |  |  |  | 0
48 | 0805 | 11 | 10 | 4.7uF |  |  | 87 | 0 | 87 | LCSC | TRUE |  |  |  |  | 1
49 | 0805 | 2 | 2 | 10uF |  |  | 16 | 0 | 16 |  | TRUE |  |  |  |  | 1
50 | 0805 | 5 | 0 | 2.2uF |  |  | 35 | 0 | 35 | LCSC | TRUE |  |  |  |  | 1
51 | B360A | 1 | 3 | B360 |  |  | 10 | 0 | 10 | Prior B330 | TRUE |  |  |  |  | 1
52 | D_SMC | 1 | 1 | SMCJ45CA |  |  | 10 | 0 | 10 | LCSC | TRUE |  |  |  |  | 1
53 | D_SMC | 1 | 0 | SMAJ30CA |  |  | 7 | 10 | 0 |  | TRUE |  |  |  |  | 0
54 | D_SOD-123 | 1 | 1 | BZT52C18 |  |  | 8 | 50 | 0 |  | TRUE |  |  |  |  | 0
55 | DRV8302 | 1 | 0 | DRV8302DCAR |  |  | 7 | 1 | 6 |  | TRUE |  |  |  |  | 1
56 | ESP32-S3-WROOM-1U | 1 | 1 | ESP32-S3-WROOM-1 |  |  | 8 | 3 | 5 |  | TRUE |  |  |  |  | 1
57 | Ferrite Bead | 1 | 1 | 0603 - 600R, 100Mhz |  |  | 8 | 0 | 8 |  | TRUE |  |  |  |  | 1
58 | JST_PH_S2B-PH Male | 2 | 0 | Male Connector |  |  | 14 | 14 | 0 |  | TRUE |  |  |  |  | 0
59 | JST_PH_S2B-PH-K_1x02_P2.00mm_Horizontal | 1 | 1 | CAN1 |  |  | 8 | 50 | 0 |  | TRUE |  |  |  |  | 0
60 | JST_PH_S2B-PH-K_1x02_P2.00mm_Horizontal | 1 | 1 | CAN2 |  |  | 8 | 50 | 0 |  | TRUE |  |  |  |  | 0
61 | JST_PH_S5B-PH-K_1x05_P2.00mm_Horizontal | 1 | 0 | Hall Encoder Male |  |  | 7 | 4 | 3 |  | TRUE |  |  |  |  | 0
62 | JST_PH_S5B-PH-K_1x05_P2.00mm_Horizontal | 1 | 0 | Hall Encoder |  |  | 7 | 4 | 3 |  | TRUE |  |  |  |  | 0
63 | MOSFET | 6 | 0 | FH4008GS (IRFH7440) |  |  | 42 | 18 | 24 |  | TRUE |  |  |  |  | 1
64 | MOSFET RPP | 1 | 1 | XRS80P06F |  |  | 8 | 0 | 8 |  | TRUE |  |  |  |  | 1
65 | SM7850 | 1 | 3 | 12uH |  |  | 10 | 5 | 5 |  | TRUE |  |  |  |  | 1
66 | SOD-123 | 5 | 5 | 1N4002 |  |  | 40 | 100 | 0 |  | TRUE |  |  |  |  | 0
67 | SOIC127P599X175-8N | 1 | 1 | MCP2551-I_SN |  |  | 8 | 3 | 5 |  | TRUE |  |  |  |  | 1
68 | SOIC127P600X175-8N | 1 | 0 | MT6701CT-AKD |  |  | 7 | 3 | 4 |  | TRUE |  |  |  |  | 1
69 | SOT-23-5 | 1 | 1 | TLV75733PDBV |  |  | 8 | 10 | 0 |  | TRUE |  |  |  |  | 0
70 | SOT-23-6 | 1 | 1 | SRV05-4 |  |  | 8 | 20 | 0 |  | TRUE |  |  |  |  | 0
71 | SW | 2 | 2 | TS-1088AR02016 |  |  | 20 | 5 | 15 | LCSC | TRUE |  |  |  |  | 1
72 | USB_C_Receptacle_Palconn_UTC16-G | 1 | 1 | USB_C 3.1 |  |  | 8 | 10 | 0 |  | TRUE |  |  |  |  | 0
73 | XDCR_BMI270 | 0 | 1 | BMI270 |  |  | 1 | 3 | 0 |  | TRUE |  |  |  |  | 0
74 | XT30 | 2 | 0 | Female 90 |  |  | 14 | 6 | 8 |  | TRUE |  |  |  |  | 1
75 | XT30 | 0 | 5 | Female |  |  | 5 | 1 | 4 |  | TRUE |  |  |  |  | 1
76 | XT30 | 2 | 4 | Male |  |  | 18 | 18 | 0 |  | TRUE |  |  |  |  | 0
77 | XT60 | 0 | 2 | Male |  |  | 2 | 1 | 1 |  | TRUE |  |  |  |  | 1
78 | XT60 | 0 | 2 | Female |  |  | 2 | 1 | 1 |  | TRUE |  |  |  |  | 1
79 | Bulk Capacitors | 2 | 2 | 220uF |  | 50V | 16 | 4 | 12 |  | TRUE |  |  |  |  | 0
80 | Buzzer | 0 | 1 |  |  |  | 1 | 5 | 0 |  | TRUE |  |  |  |  | 0
81 | LED 3 mm | 0 | 20 |  |  |  | 20 | 100 | 0 |  | TRUE |  |  |  |  | 0
82 | Power Converter | 0 | 1 | TPS54160 |  |  | 1 | 0 | 1 |  | TRUE |  |  |  |  | 1
83 | Power Converter | 0 | 2 | TPS54560 |  |  | 2 | 0 | 2 |  | TRUE |  |  |  |  | 1
84 | Shift Register | 0 | 3 | 74HC595 |  |  | 3 | 0 | 3 |  | TRUE |  |  |  |  | 1
85 | BJT Transistor | 0 | 2 | SS30101-Q |  |  | 2 | 0 | 2 |  | TRUE |  |  |  |  | 1
86 | MOSFET Latch | 0 | 1 | IRF9540N |  |  | 1 | 0 | 1 |  | TRUE |  |  |  |  | 1
87 | BJT Transistor | 0 | 1 | 2N3904 |  |  | 1 | 0 | 1 |  | TRUE |  |  |  |  | 1
88 | Transceiver | 0 | 1 | NRF24L01 |  |  | 1 | 0 | 1 |  | TRUE |  |  |  |  | 0
89 |  |  |  |  |  |  | 0 | 0 | 0
90 |  |  |  |  |  |  | 0 | 0 | 0
91 |  |  |  |  |  |  | 0 | 0 | 0
92 |  |  |  |  |  |  | 0 | 0 | 0
93 |  |  |  |  |  |  | 0 | 0 | 0
94 |  |  |  |  |  |  | 0 | 0 | 0
95 |  |  |  |  |  |  | 0 | 0 | 0
96 |  |  |  |  |  |  | 0 | 0 | 0
97 |  |  |  |  |  |  | 0 | 0 | 0 |  |  |  |  |  |  | 57
98 |  |  |  |  |  |  | 0 | 0 | 0
99 |  |  |  |  |  |  | 0 | 0 | 0
100 |  |  |  |  |  |  | 0 | 0 | 0
101 |  |  |  |  |  |  | 0 | 0 | 0
102 |  |  |  |  |  |  | 0 | 0 | 0
103 |  |  |  |  |  |  | 0 | 0 | 0
104 |  |  |  |  |  |  | 0 | 0 | 0
105 |  |  |  |  |  |  | 0 | 0 | 0
106 |  |  |  |  |  |  | 0 | 0 | 0
