Angelpele/Integrated_FOC_BLDC_Actuator/Hardware/BOM Preliminar.xlsx

ID | Name | Designator | Footprint | Quantity | Manufacturer Part | Manufacturer | Supplier | Supplier Qty | Price | Pins | 3DModel | JLCPCB Part Class | Contributor | Resistance | link
 | Resistor | 150V 5% | 0805 |  |  |  |  | 100 |  | 2 |  |  |  | 10k
 | Capacitor | 50V 10% | 0805 |  |  |  |  | 200 |  | 2 |  |  |  | 0.1uF
 | Capacitor | 25V 20% | 0805 |  |  |  |  | 40 |  | 2 |  |  |  | 22 uF
 | LED | Emerald | 1206 |  |  |  |  | 100 |  | 2 |  |  |  | 25mA 80mW
C720477 | Button | Without bracket 50mA 4mm 100000 Times 12V 160gf 3mm 2mm Round Button Standing paste SPST SMD Tactile Switches ROHS | 4mm | 2 | TS-1088-AR02016 | Yuandi |  |  |  | 2 |  |  |  |  | https://www.lcsc.com/product-detail/Tactile-Switches_XUNPU-TS-1088-AR02016_C720477.html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
C2765186 | Type C | 3A USB 3.1 1 Horizontal attachment 16P Female -25℃~+85℃ Type-C SMD USB Connectors ROHS |  | 1 | TYPE-C 16PIN 2MD(073) | Shou Han |  |  |  | 16 |  |  |  |  | https://www.lcsc.com/product-detail/USB-Connectors_SHOU-HAN-TYPE-C-16PIN-2MD-073_C2765186.html
C2913197 | ESP32 | Espressif Systems ESP32-S3-WROOM-1U-N4 | SMD,18x19.2mm | 1 | ESP32-S3-WROOM-1U-N4 | Espressif Systems |  |  |  |  |  |  |  |  | https://www.lcsc.com/product-detail/WiFi-Modules_Espressif-Systems-ESP32-S3-WROOM-1U-N4_C2980296.html
C42386172 | Wifi Antenna | WIFI antenna ROHS |  | 1 | LXC1BL20020241113053 | LXC |  |  |  |  |  |  |  |  | https://www.lcsc.com/product-detail/WIFI-antenna_LXC-LXC1BL20020241113053_C42386172.html
C2907114 | Resistor | Type C conector | 0603 | 2 | FRC0603J512 TS | FOJAN |  |  |  | 2 |  |  |  | 5,1k
C3016224 | Resistor | Led | 0603 | 1 | SCR0603F56R | VO |  |  |  | 2 |  |  |  | 56 ohm
C2687126 | TVS | 20V 6V SOT-23-6 ESD and Surge Protection (TVS/ESD) ROHS |  | 1 | SRV05-4.TCT | UMW(Youtai Semiconductor Co., Ltd.) |  |  |  | 6
C5199209 | TVS | 6A 10V 6V Bidirectional 5V DFN1006-2L ESD and Surge Protection (TVS/ESD) ROHS |  | 1 | PESDNC2FD5VB-ES | ElecSuper |  |  |  | 2 |  |  |  |  | https://www.lcsc.com/product-detail/ESD-and-Surge-Protection-TVS-ESD_ElecSuper-PESDNC2FD5VB-ES_C5199209.html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
C37323940 | Connector | XT60 Connector Plug 35A Male |  | 1 | XT60-M.G.Y | Changzhou Amass Elec |  |  |  | 2 |  |  |  |  | https://lcsc.com/product-detail/plug_Changzhou-Amass-Elec-XT60-M-G-Y_C37323940.html?s_z=n_xt60%2520connector
C98734 | Connector | XT60 Connector Plug 30A Female |  | 1 | XT60-F |  |  |  |  | 2
C5343587 | TVS | 30V 400W 48.4V 33.3V 8.3A Bidirectional SMA ESD and Surge Protection |  | 1 | SMAJ30CA | KUU |  |  |  | 2 |  |  |  |  | https://lcsc.com/product-detail/image/SMAJ30CA_C5343587.html
C67862 | NMOS | 40V 159A 104W 1.8mΩ@10V,50A 2.2V 1 N-Channel PQFN(5x6) MOSFETs ROHS |  | 7 | IRFH7440TRPBF | Infineon Technologies |  |  |  | 8 |  |  |  |  | https://lcsc.com/product-detail/MOSFETs_Infineon-Technologies-IRFH7440TRPBF_C67862.html?s_z=n_irfh7440
 | Surge Protection | 60V Bidirectional | SMD |  | PESDMC2FD |  |  |  |  |  |  |  |  | 2,5A 18V
C42458998 | Zener | Independent 500mW 17.1V~18.9V 18V SOD-123 Zener Diodes ROHS | SOD-123 | 1 | BZT52C18 | ChipNobo |  |  |  |  |  |  |  | 18V Zener | https://lcsc.com/product-detail/Zener-Diodes_ChipNobo-BZT52C18_C42458998.html?s_z=n_zener
C2836813 | Sensor | Accelerometer Gyroscope LGA-14(2.5x3) Accelerometers ROHS | LGA-14(2.5x3) | 1 | BMI270 | Bosch Sensortec |  |  |  |  |  |  |  |  | https://lcsc.com/product-detail/Accelerometers_Bosch-Sensortec-BMI270_C2836813.html?s_z=n_bmi
C97643 | Buck Converter | Buck Adjustable 1A 4.75V~40V SOT-23-6 DC-DC Converters ROHS | SOT-23-6 | 1 | ME3116AM6G | MICRONE(Nanjing Micro One Elec) |  |  |  | 6 |  |  |  |  | https://lcsc.com/product-detail/DC-DC-Converters_MICRONE-Nanjing-Micro-One-Elec-ME3116AM6G_C97643.html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
 | Resistor | 150V 5% | 0805 |  |  |  |  | 200 |  | 2 |  |  |  | 3k
C2933280 | Resistor | 125mW Thick Film Resistor 150V ±100ppm/℃ ±1% 1MΩ 0805 Chip Resistor - Surface Mount ROHS | 0805 | 1 | FOJAN FRC0805F1004TS | FOJAN |  |  |  | 2 |  |  |  | 1M | https://lcsc.com/product-detail/Chip-Resistor-Surface-Mount_FOJAN-FRC0805F1004TS_C2933280.html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
C7432781 | Capacitor | 50V 10uF X5R ±10% 1206 Multilayer Ceramic Capacitors MLCC - SMD/SMT ROHS | 1206 | 1 | HGC1206R5106K500NSPJ | Chinocera |  |  |  |  |  |  |  | 10uF | https://lcsc.com/product-detail/Multilayer-Ceramic-Capacitors-MLCC-SMD-SMT_Chinocera-HGC1206R5106K500NSPJ_C7432781.html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
C15849 | Capacitor | 50V 1uF X5R ±10% 0603 Multilayer Ceramic Capacitors MLCC - SMD/SMT ROHS | 0603 | 1 | CL10A105KB8NNNC | Samsung Electro-Mechanics |  |  |  |  |  |  |  | 1uF | https://lcsc.com/product-detail/Multilayer-Ceramic-Capacitors-MLCC-SMD-SMT_Samsung-Electro-Mechanics-CL10A105KB8NNNC_C15849.html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
C2077247 | Resistor | RES 5.23kΩ ±1% 125mW 0805 | 0805 | 1 | VISHAY CRCW08055K23FKEA | VISHAY |  |  |  | 2 |  |  |  | 5.23k | https://www.lcsc.com/product-detail/C2077247.html
C46614474 | Capacitor | 50V 100pF C0G ±2% 0402 Multilayer Ceramic Capacitors MLCC - SMD/SMT ROHS | 0402 | 1 | HRE CGA0402C0G101G500GT | HRE |  |  |  | 2 |  |  |  | 100pF | https://www.lcsc.com/product-detail/C46614474.html?s_z=n_100pF
C41384290 | Inductor | FIXED IND 22uH 2.5A 170mΩ SMD,7x6.6mm | SMD,7x6.6mm | 1 | FSA0630-220MT | Magnetsyc |  |  |  | 2 |  |  |  | 22uH | https://www.lcsc.com/product-detail/C41384290.html?s_z=n_20%2520uH
