Angelpele/Integrated_FOC_BLDC_Actuator/Mechanical/BLDC_Motor_BOM_Fusion360.xlsx

Part Name | BLDC Motor
Working BOM | as of November 12, 2025 at 11:57:35 PM UTC
Exported by | angel.pele05@gmail.com
Time of Export | 11:57 PM Nov 12, 2025
Level | Part Number | Part Name | External Component | Description | Material Name | Quantity
1 | BLDC Motor | BLDC Motor |  |  | ABS Plastic | 1
1.2 | Main Casing | Main Casing | External |  | ABS Plastic | 1
1.3 | BHSBHCS ASME B18.3.4M - M3 x 0.5 x 3 Steel Grade 2 Plain | Broached Hexagon Socket Button Head Cap Screw ASME B18.3.4M - M3 x 0.5 x 3 Steel Grade 2 Plain | External | Broached Hexagon Socket Button Head Cap Screw ASME B18.3.4M - M3 x 0.5 x 3 | Steel Grade 2, Plain | 8
1.4 | ESP32_Motor_Controller 1 | ESP32_Motor_Controller | External | KiCad electronic assembly | Steel | 1
1.5 | 93655A093_Male-Female Threaded Hex Standoff | 93655A093_Male-Female Threaded Hex Standoff |  |  | ABS Plastic | 4
1.6 | Cycloidal Drive | Cycloidal Drive | External |  | ABS Plastic | 1
1.6.2 | Outer Casing | Outer Casing |  |  | ABS Plastic | 1
1.6.3 | Outer Pins | Outer Pins |  |  | ABS Plastic | 1
1.6.4 | Cycloidal Disc 2 | Cycloidal Disc 2 |  |  | ABS Plastic | 1
1.6.5 | Cycloidal Disc | Cycloidal Disc |  |  | ABS Plastic | 1
1.6.6 | Output Pins | Output Pins |  |  | ABS Plastic | 1
1.6.7 | Inner Shaft | Inner Shaft |  |  | ABS Plastic | 1
1.6.8 | Top Cover | Top Cover |  |  | ABS Plastic | 1
1.6.9 | 4668K143_Permanently Lubricated Stainless Steel Ball Bearing | 4668K143_Permanently Lubricated Stainless Steel Ball Bearing |  |  | ABS Plastic | 3
1.6.10 | 4668K259_Permanently Lubricated Stainless Steel Ball Bearing | 4668K259_Permanently Lubricated Stainless Steel Ball Bearing |  |  | ABS Plastic | 1
1.6.11 | 7588N53_Mold-in Inserts for Plastic | 7588N53_Mold-in Inserts for Plastic |  |  | ABS Plastic | 6
1.7 | Diametric Magnet 1/32 in, 1/4 in dia | Diametric Magnet 1/32 in, 1/4 in dia | External |  | ABS Plastic | 1
1.8 | ISO 4762 - M2 x 6 Steel 4.6 Plain | Hexagon Socket Head Cap Screw ISO 4762 - M2 x 6 Steel 4.6 Plain | External | Hexagon Socket Head Cap Screw ISO 4762 - M2 x 6 | Steel 4.6, Plain | 4
1.9 | BHSBHCS ASME B18.3.4M - M3 x 0.5 x 45 Steel Grade 2 Plain | Broached Hexagon Socket Button Head Cap Screw ASME B18.3.4M - M3 x 0.5 x 45 Steel Grade 2 Plain | External | Broached Hexagon Socket Button Head Cap Screw ASME B18.3.4M - M3 x 0.5 x 45 | Steel Grade 2, Plain | 5
1.10 | ISO 4762 - M2 x 14 Steel 4.6 Plain | Hexagon Socket Head Cap Screw ISO 4762 - M2 x 14 Steel 4.6 Plain | External | Hexagon Socket Head Cap Screw ISO 4762 - M2 x 14 | Steel 4.6, Plain | 2
