Angelpele/Integrated_FOC_BLDC_Actuator/Mechanical/Buying List.xlsx

Component | Supplier | Unit Price | Quantity | Shipping Costs | Purchased | Arrived | Total | Link
N42 Neodymium Diametrically Magnetised Disc Magnet - 1/4 in. dia x 1/32 in. thick (Pack of 10) | First 4 Magnets | $3.85 | 1 | $7.00 | Yes | Yes | $10.85 | https://www.first4magnets.com/us/product/n42-neodymium-diametrically-magnetised-disc-magnet-1-4-in-dia-x-1-32-in-thick-20413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
QWinOut High Performance 5010 750KV Disk Brushless Motor with Bullet Cap Mount for DIY FPV Drone Hexacopter Quadcopter MultiCopter | QWinOut | $17.05 | 2 | $0.00 | Yes | Yes | $34.10 | https://qwinout.com/products/qwinout-high-performance-5010-750kv-disk-brushless-motor-with-bullet-cap-mount-for-diy-fpv-drone-hexacopter-quadcopter-multicopte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
Male Female Threaded Hex Standoff 6 mm long, M3 x 0.5 mm | HIVE | $0.00 | 8 | $0.00 | Yes | Yes | $0.00 | (Take more for more motors)
6x12mm Solid Pins 30 Units | AliExpress | $3.71 | 3 | $1.00 | Yes | Yes | $12.13 | https://es.aliexpress.com/item/1005009576693979.html?curPageLogUid=N1LNBeR6Cvw2
Pedido LCSC Components | LCSC | $61.53 | 1 |  | Yes | Yes | $64.11
Pedido PCBs | JLCPCB | $13.23 | 1 |  | Yes | Yes | $13.23
Rodamiento 35x44x5mm - 2 units | AliExpress | $2.68 | 2 | $0.00 | Yes | Yes | $5.36 | https://es.aliexpress.com/item/1005009747825955.html?curPageLogUid=bQdaNbMqlH2g
Rodamiento BEC-7 12x18x4mm 6701RS - 10 units | AliExpress | $2.11 | 2 | $0.00 | Yes | Yes | $4.22 | https://es.aliexpress.com/item/1005006952693027.html?curPageLogUid=Fww5FcILrGbL
Printed Cycloidal PLA | HIVE |  | 1 |  | Yes | Yes | $0.00
Inner shaft | Invention - Aluminum | $0.00 | 4 | $0.00 | No | No | $0.00
Cycloidal Disc 1 | Invention - Aluminum | $0.00 | 4 | $0.00 | No | No | $0.00
Cycloidal Disc 2 | Invention - Aluminum | $0.00 | 4 | $0.00 | No | No | $0.00
BHSBHCS ASME B18.3.4M - M3 x 0.5 x 3 Steel Grade 2 Plain | Senior Lab | $0.00 | 16 | $0.00 | No | $8.00 | $0.00
BHSBHCS ASME B18.3.4M - M3 x 0.5 x 4 Steel Grade 2 Plain | Senior Lab | $0.00 | 16 | $0.00 | No | $4.00 | $0.00
Hexagon Socket Head Cap Screw ISO 4762 - M2 x 14 Steel 4.6 Plain | Invention | $0.00 | 8 | $0.00 | Yes | Yes | $0.00
Hexagon Socket Head- M3 x 0.5 x 45 Steel Grade 2 Plain (48 mm rosca) | Invention | $0.00 | 20 | $0.00 | Yes | Yes | $0.00
Hexagon Socket Head Cap Screw ISO 4762 - M2 x 8 Steel 4.6 Plain | Invention | $0.00 | 16 | $0.00 | No | $11.00 | $0.00
 |  |  |  |  |  |  | $0.00
Hexagon = Cylindrical head + allen socket |  |  |  |  |  |  | $0.00
ASME = Rounded head + allen socket |  |  |  |  |  |  | $0.00
 |  |  |  |  |  |  | $0.00
 |  |  |  |  |  |  | $144.00
