Angelpele/Integrated_FOC_BLDC_Actuator/Hardware/ESP32_Motor_Controller/ESP32_Motor_Controller_V3.csv

Reference | Value | Footprint | Datasheet | Qty
D301 | B360 | B3030A:B3030A | http://www.jameco.com/Jameco/Products/ProdDS/1538777.pdf | 1
U501 | BMI270 | BMI270:XDCR_BMI270 |  | 1
C202C204C205C305C322C402C406C409C501C502C503C506C507C508 | 0.1uF | Capacitor_SMD:C_0402_1005Metric | ~ | 14
C303 | 0.022uF | Capacitor_SMD:C_0402_1005Metric | ~ | 1
C304 | 0.015uF | Capacitor_SMD:C_0402_1005Metric | ~ | 1
C309C310 | 2.2nF | Capacitor_SMD:C_0402_1005Metric | ~ | 2
C318C403C404 | 1nF | Capacitor_SMD:C_0402_1005Metric | ~ | 3
C114C115C201C320 | 1uF | Capacitor_SMD:C_0603_1608Metric | ~ | 4
C302 | 2.2uF | Capacitor_SMD:C_0603_1608Metric | ~ | 1
C306C307C308C321 | 0.1uF | Capacitor_SMD:C_0603_1608Metric | ~ | 4
C317 | 15pF | Capacitor_SMD:C_0603_1608Metric | ~ | 1
C104C105C106C107C108C109C110C111C112C113C314 | 4.7uF | Capacitor_SMD:C_0805_2012Metric | ~ | 11
C203C319 | 22uF | Capacitor_SMD:C_0805_2012Metric | ~ | 2
C311C313C401C405C408 | 2.2uF | Capacitor_SMD:C_0805_2012Metric | ~ | 5
C312C315C316 | 0.1uF | Capacitor_SMD:C_0805_2012Metric | ~ | 3
J502 | CAN1 | Connector_JST:JST_PH_S2B-PH-K_1x02_P2.00mm_Horizontal | ~ | 1
J503 | CAN2 | Connector_JST:JST_PH_S2B-PH-K_1x02_P2.00mm_Horizontal | ~ | 1
J501 | Hall Encoder | Connector_JST:JST_PH_S5B-PH-K_1x05_P2.00mm_Horizontal | ~ | 1
Ext_Cap101 | Conn_01x01_Pin | Connector_PinHeader_2.00mm:PinHeader_1x01_P2.00mm_Vertical | ~ | 1
USB101 | USB_C 3.1 | Connector_USB:USB_C_Receptacle_Palconn_UTC16-G | https://www.usb.org/sites/default/files/documents/usb_type-c.zip | 1
TVS101 | PESDNC2 | Diode_SMD:D_0201_0603Metric | ~ | 1
TVS103 | SMAJ30CA | Diode_SMD:D_SMC |  | 1
D101 | BZT52C18 | Diode_SMD:D_SOD-123 | https://diotec.com/tl_files/diotec/files/pdf/datasheets/bzt52b2v4.pdf | 1
D102D302D401D402D403 | 1N4002 | Diode_SMD:D_SOD-123 | http://www.vishay.com/docs/88503/1n4001.pdf | 5
U301 | DRV8302DCAR | DRV8302:DRV8302 |  | 1
FB1 | 600R | Inductor_SMD:L_0603_1608Metric | ~ | 1
JP1 | SOLDER - RPP | Jumper:SolderJumper-2_P1.3mm_Open_Pad1.0x1.5mm | ~ | 1
JP2 | SOLDER - XRPP | Jumper:SolderJumper-2_P1.3mm_Open_Pad1.0x1.5mm | ~ | 1
JP3 | CAN | Jumper:SolderJumper-2_P1.3mm_Open_Pad1.0x1.5mm | ~ | 1
D201D204 | 3V3 | LED_SMD:LED_0603_1608Metric | ~ | 2
D202 | 5V | LED_SMD:LED_0603_1608Metric | ~ | 1
D203 | 16V | LED_SMD:LED_0603_1608Metric | ~ | 1
U502 | MCP2551-I_SN | MCP2551-I_SN:SOIC127P599X175-8N |  | 1
MP1 | Pad401 | MountingHole:MountingHole_2.5mm_Pad_Via | ~ | 1
MP2 | Pad402 | MountingHole:MountingHole_2.5mm_Pad_Via | ~ | 1
MP3 | Pad403 | MountingHole:MountingHole_2.5mm_Pad_Via | ~ | 1
MP_1MP_2MP_3MP_4 | MountingHole | MountingHole:MountingHole_3.2mm_M3 | ~ | 4
Q401Q402Q403Q404Q405Q406 | FH4008GS | Package_DFN_QFN:PQFN-8-EP_6x5mm_P1.27mm_Generic |  | 6
U2 | TLV75733PDBV | Package_TO_SOT_SMD:SOT-23-5 | https://www.ti.com/lit/ds/symlink/tlv757p.pdf | 1
TVS102 | SRV05-4 | Package_TO_SOT_SMD:SOT-23-6 | http://www.onsemi.com/pub/Collateral/SRV05-4-D.PDF | 1
C504C505 | 560pF | Resistor_SMD:R_0402_1005Metric | ~ | 2
R103R201R303R304R305R403R410R415R509 | 10k | Resistor_SMD:R_0402_1005Metric | ~ | 9
R301R302 | 56R | Resistor_SMD:R_0402_1005Metric | ~ | 2
R306 | 86.6k | Resistor_SMD:R_0402_1005Metric | ~ | 1
R307 | 200k | Resistor_SMD:R_0402_1005Metric | ~ | 1
R310R404R409R414 | 100k | Resistor_SMD:R_0402_1005Metric | ~ | 4
R311 | 3.3k | Resistor_SMD:R_0402_1005Metric | ~ | 1
R501R502R503 | 0R | Resistor_SMD:R_0402_1005Metric | ~ | 3
R505 | 4k7 | Resistor_SMD:R_0402_1005Metric | ~ | 1
R202R205 | 56R | Resistor_SMD:R_0603_1608Metric | ~ | 2
R203 | 150R | Resistor_SMD:R_0603_1608Metric | ~ | 1
R204 | 1100R | Resistor_SMD:R_0603_1608Metric | ~ | 1
R308R312 | 10k | Resistor_SMD:R_0603_1608Metric | ~ | 2
R309 | 52.3k | Resistor_SMD:R_0603_1608Metric | ~ | 1
R313 | 100k | Resistor_SMD:R_0603_1608Metric | ~ | 1
R401R402R406R407R411R412 | 10R | Resistor_SMD:R_0603_1608Metric | ~ | 6
R504 | 121R | Resistor_SMD:R_0603_1608Metric | ~ | 1
R506R507 | 100R | Resistor_SMD:R_0603_1608Metric | ~ | 2
TH1 | NTC 10k | Resistor_SMD:R_0603_1608Metric | ~ | 1
R405R408 | 0.01R | Resistor_SMD:R_2512_6332Metric | ~ | 2
MCU1 | ESP32-S3-WROOM-1 | RF_Module:ESP32-S3-WROOM-1U | https://www.espressif.com/sites/default/files/documentation/esp32-s3-wroom-1_wroom-1u_datasheet_en.pdf | 1
L301 | 12uH | SM7850 Inductor:SM7850 | ~ | 1
IC501 | MT6701CT-AKD | SOIC127P600X175-8N | https://datasheet.lcsc.com/lcsc/2205121145_Magn-Tek-MT6701CT-STD-R_C3003196.pdf | 1
TP1 | GND | TestPoint:TestPoint_Pad_D1.0mm | ~ | 1
TP2 | A_SENSE | TestPoint:TestPoint_Pad_D1.0mm | ~ | 1
TP3 | B_SENSE | TestPoint:TestPoint_Pad_D1.0mm | ~ | 1
TP4 | C_SENSE | TestPoint:TestPoint_Pad_D1.0mm | ~ | 1
TP6 | PVDD_SENSE | TestPoint:TestPoint_Pad_D1.0mm | ~ | 1
TP8 | V_SENSE | TestPoint:TestPoint_Pad_D1.0mm | ~ | 1
TP9 | 3V3 | TestPoint:TestPoint_Pad_D1.0mm | ~ | 1
TP12 | BMI_SCK | TestPoint:TestPoint_Pad_D1.0mm | ~ | 1
TP13 | 5V | TestPoint:TestPoint_Pad_D1.0mm | ~ | 1
TP14 | PVDD | TestPoint:TestPoint_Pad_D1.0mm | ~ | 1
TP15 | AVDD | TestPoint:TestPoint_Pad_D1.0mm | ~ | 1
TP16 | BMI_SDA | TestPoint:TestPoint_Pad_D1.0mm | ~ | 1
TP17 | GVDD | TestPoint:TestPoint_Pad_D1.0mm | ~ | 1
TP20 | VBUS | TestPoint:TestPoint_Pad_D1.0mm | ~ | 1
TP7 | OC_ADJ | TestPoint:TestPoint_Pad_D1mm | ~ | 1
SW1SW2 | TS-1088-AR02016 | TS-1088-AR02016:SW_TS-1088-AR02016 |  | 2
Q1 | XRS80P06F | XRS80P06F:XRS80P06F |  | 1
J101J102 | XT30PW-M | XT30PW-M:AMASS_XT30PW-M |  | 2
R101R102 | 5.1k
