Angelpele/Integrated_FOC_BLDC_Actuator/Mechanical/Def STL Plastic PLA/Main Case V5 Fit.stl

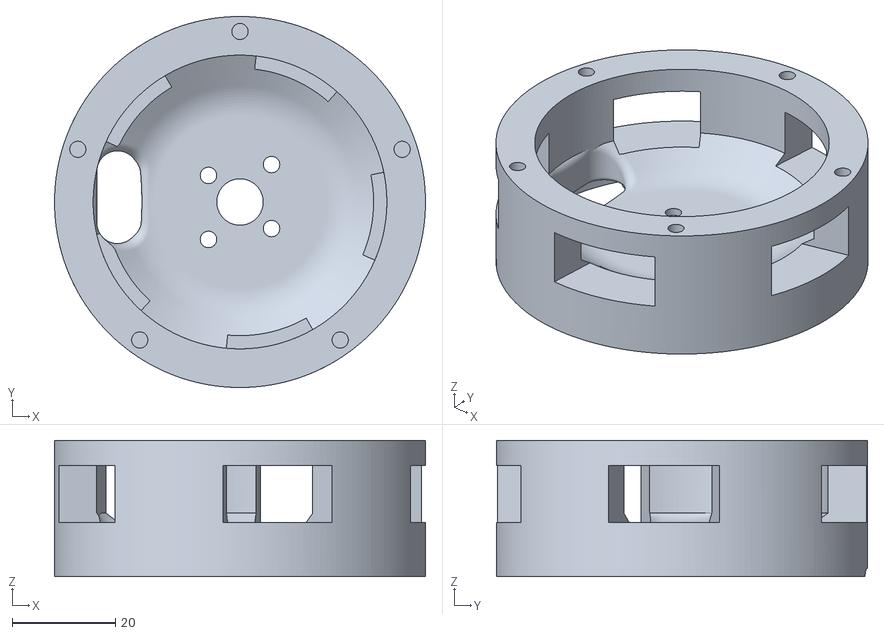
[picture p82: CAD file, 2026-04-14]
Mechanical/Def STL Plastic PLA/Main Case V5 Fit.stl
72.0 x 72.0 x 26.4
