Angelpele/Integrated_FOC_BLDC_Actuator/Mechanical/V2_Jan_2026/Main Casing V2.stl

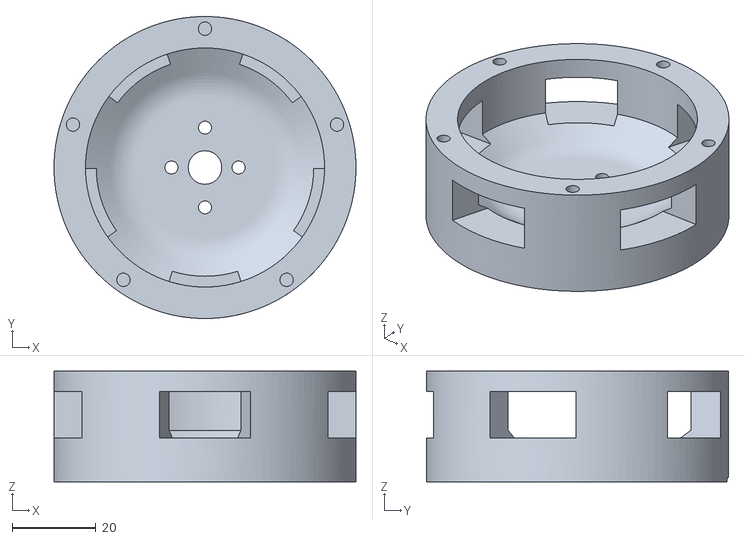
[picture p83: CAD file, 2026-03-08]
Mechanical/V2_Jan_2026/Main Casing V2.stl
72.0 x 72.0 x 26.4
