Angelpele/Integrated_FOC_BLDC_Actuator/Mechanical/STL_Components/Cycloidal Drive NoComplete V4.stl

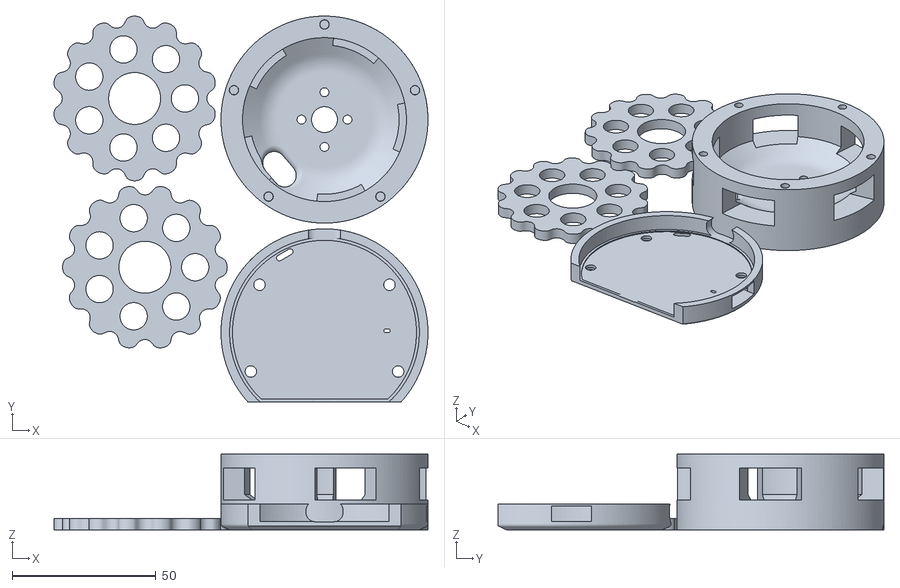
[picture p84: CAD file, 2026-03-08]
Mechanical/STL_Components/Cycloidal Drive NoComplete V4.stl
130.1 x 134.2 x 26.4
