Angelpele/Integrated_FOC_BLDC_Actuator/Mechanical/V2_Jan_2026/Cycloidal Drive Complete V2.stl

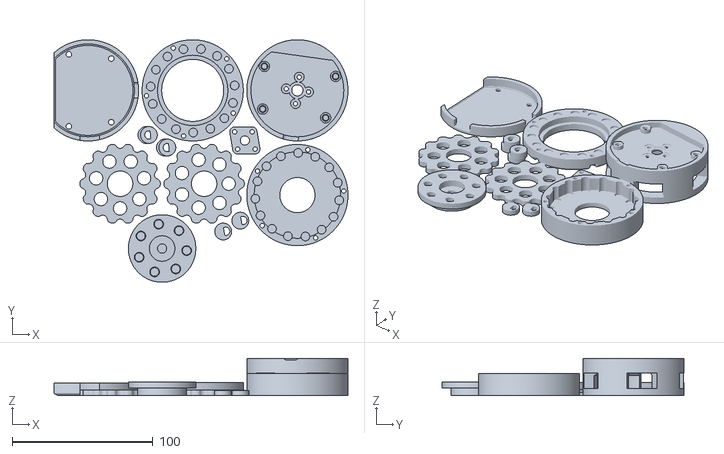
[picture p85: CAD file, 2026-03-08]
Mechanical/V2_Jan_2026/Cycloidal Drive Complete V2.stl
209.1 x 172.5 x 26.4
