Angelpele/Integrated_FOC_BLDC_Actuator/Mechanical/PCB_main.dxf

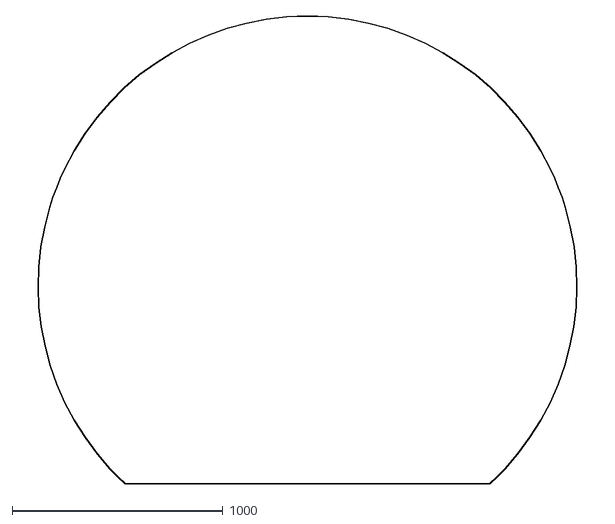
[picture p86: CAD file, 2025-11-03]
Mechanical/PCB_main.dxf
2767.3 x 2221.3
