Angelpele/Integrated_FOC_BLDC_Actuator/Hardware/ESP32_Motor_Controller/ESP32_Motor_Controller.step

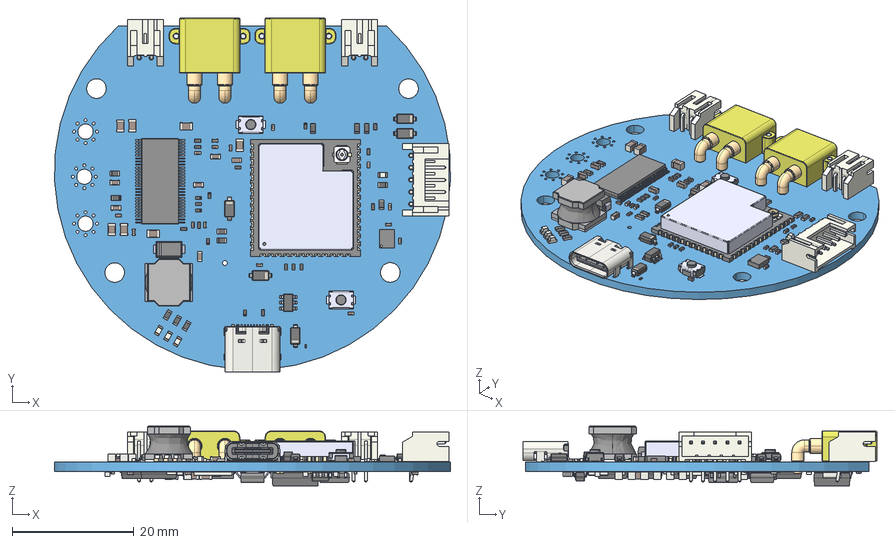
[picture p87: CAD file, 2026-04-14]
Hardware/ESP32_Motor_Controller/ESP32_Motor_Controller.step
64.9 x 58.0 x 9.80 mm
JST_PH_S2B-PH-K_1x02_P2.00mm_Horizontal x 2
R_0402_1005Metric x 26
C_0402_1005Metric x 22
C_0805_2012Metric x 20
BMI270
TS-1088-AR02016 x 2
JST_PH_S5B-PH-K_1x05_P2.00mm_Horizontal
XT30PW-M x 2
LED_0603_1608Metric x 4
R_0603_1608Metric x 18
DRV8302DCAR
C_0603_1608Metric x 10
D_SOD-123 x 6
R_0201_0603Metric
SRN6045TA-221M--3DModel-STEP-56544
SOT-23-6
B330A-13-F
USB_C_Receptacle_GCT_USB4105-xx-A_16P_TopMnt_Horizontal
ESP32-S3-WROOM-1U-N8R2--3DModel-STEP-56544
PQFN-8-EP_6x5mm_P1.27mm_Generic x 6
R_2512_6332Metric x 2
SOT-23-5
MCP2551-I_SN
XRS80P06F
L_0603_1608Metric
PinsArrayLR
D_SMC
ESP32_Motor_Controller_PCB
