Angelpele/Integrated_FOC_BLDC_Actuator/Mechanical/Stencil Holder v2.stl

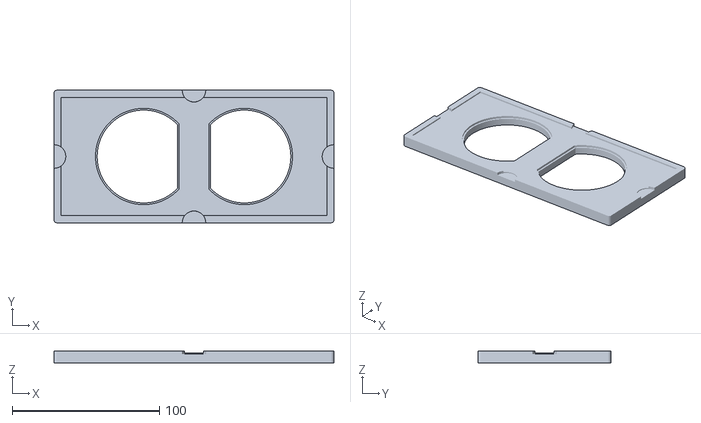
[picture p88: CAD file, 2026-09-26]
Mechanical/Stencil Holder v2.stl
190.0 x 90.0 x 8.00
