Angelpele/Integrated_FOC_BLDC_Actuator/Mechanical/STL Components/Magnet Positioner.stl

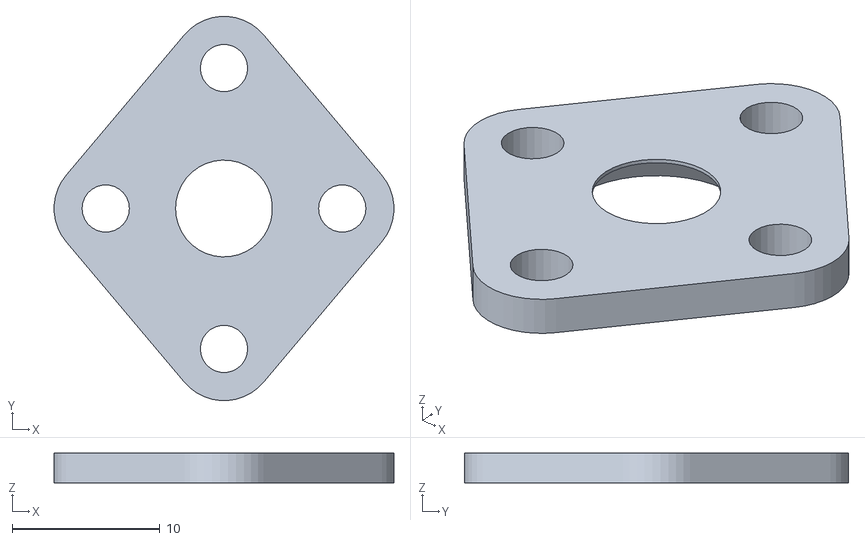
[picture p89: CAD file, 2026-02-23]
Mechanical/STL Components/Magnet Positioner.stl
23.0 x 26.0 x 2.00
