Angelpele/Integrated_FOC_BLDC_Actuator/Mechanical/V1_2025/STL Components/Cycloidal Disc 2.stl

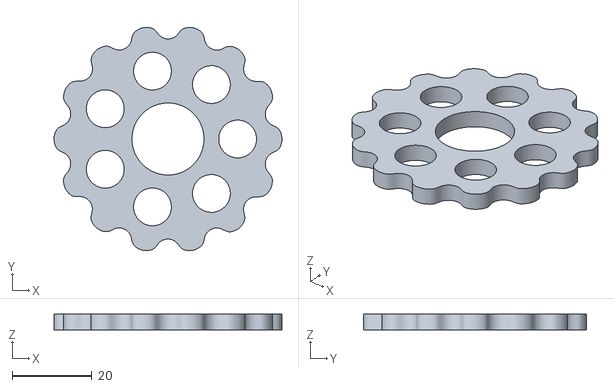
[picture p90: CAD file, 2026-03-20]
Mechanical/V1_2025/STL Components/Cycloidal Disc 2.stl
57.3 x 56.1 x 4.00
