Angelpele/Integrated_FOC_BLDC_Actuator/Mechanical/Shaft_fillet_creator.stl

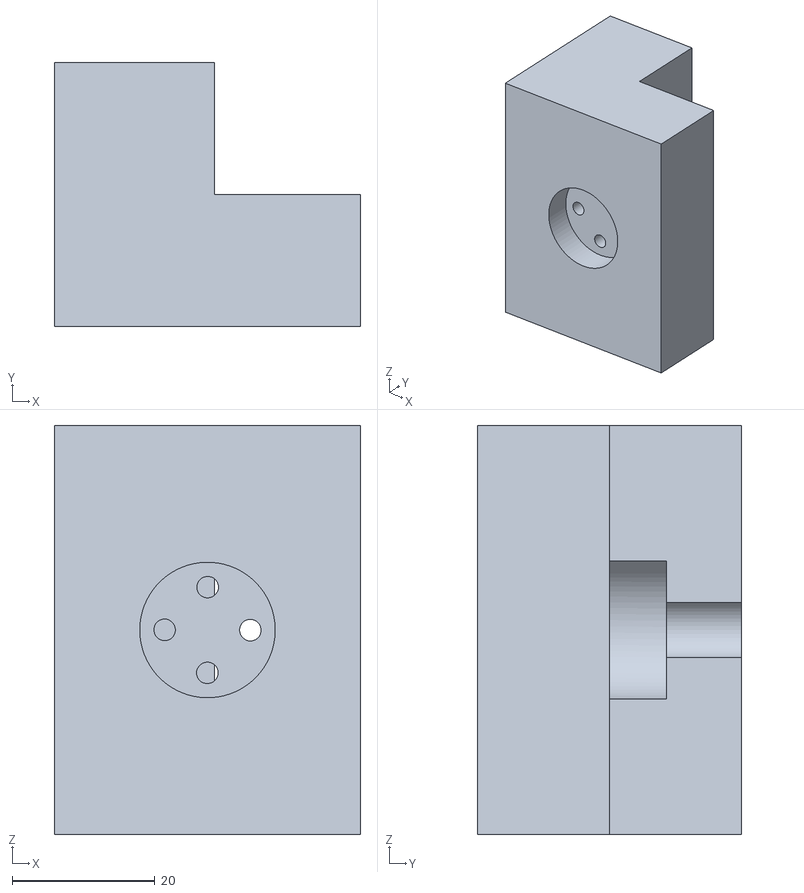
[picture p91: CAD file, 2026-04-02]
Mechanical/Shaft_fillet_creator.stl
42.9 x 37.0 x 57.3
