Angelpele/Integrated_FOC_BLDC_Actuator/Mechanical/STL Components/Outer Casing V2.stl

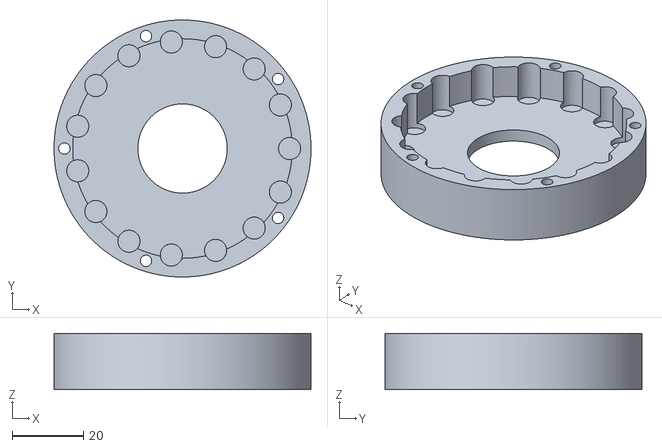
[picture p92: CAD file, 2026-02-23]
Mechanical/STL Components/Outer Casing V2.stl
72.0 x 72.0 x 15.8
