Angelpele/Integrated_FOC_BLDC_Actuator/Mechanical/STL_Components/Outer Connector V3.stl

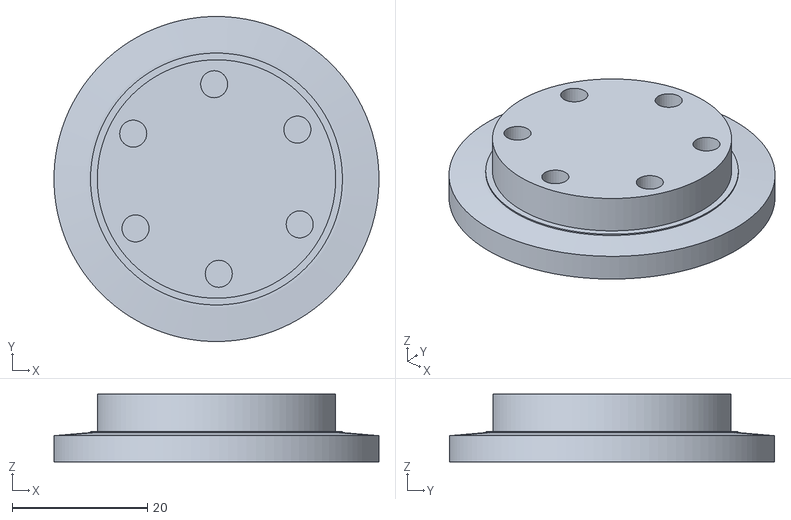
[picture p93: CAD file, 2026-03-08]
Mechanical/STL_Components/Outer Connector V3.stl
48.0 x 48.0 x 10.00
