Angelpele/Integrated_FOC_BLDC_Actuator/Mechanical/V1_2025/STL Components/Motor Connector.stl

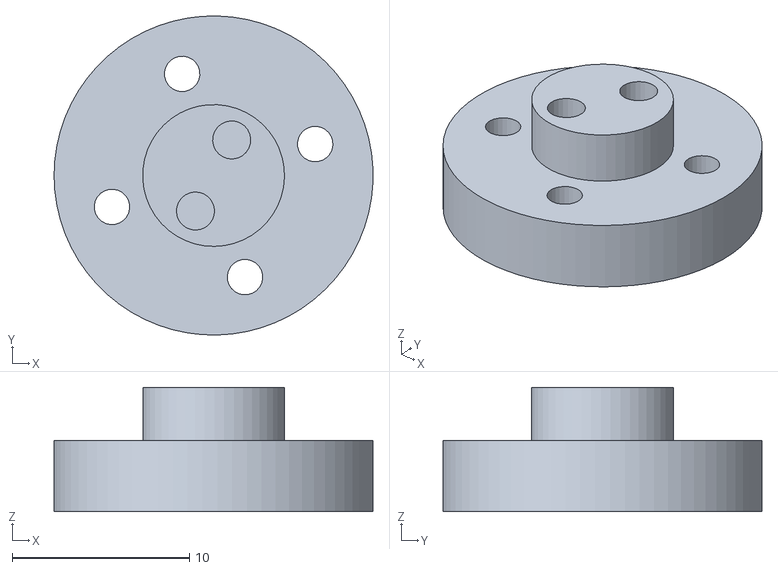
[picture p94: CAD file, 2026-02-23]
Mechanical/V1_2025/STL Components/Motor Connector.stl
18.0 x 18.0 x 7.00
