Angelpele/Integrated_FOC_BLDC_Actuator/Mechanical/V2_Jan_2026/Top Cover V2.stl

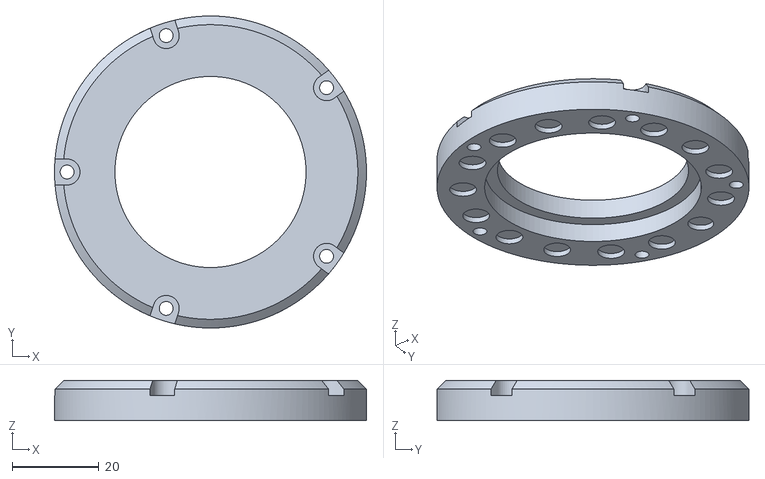
[picture p95: CAD file, 2026-03-08]
Mechanical/V2_Jan_2026/Top Cover V2.stl
72.0 x 72.0 x 9.30
