Angelpele/Integrated_FOC_BLDC_Actuator/Mechanical/V3_Feb_2026/PCB Cover V3.stl

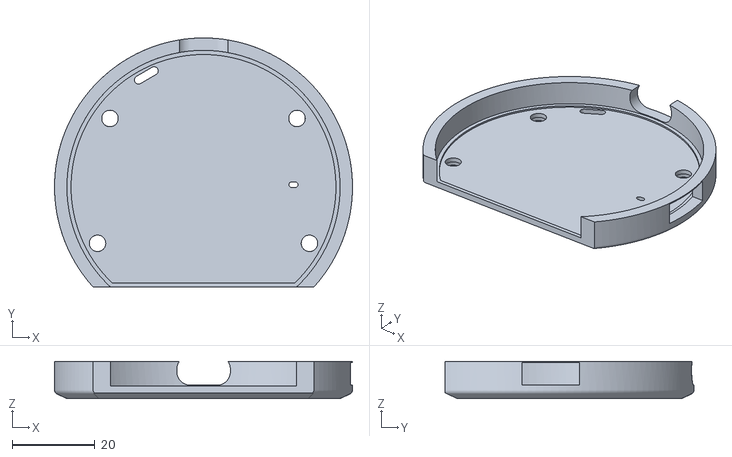
[picture p96: CAD file, 2026-03-20]
Mechanical/V3_Feb_2026/PCB Cover V3.stl
72.0 x 60.2 x 9.00
