Angelpele/Integrated_FOC_BLDC_Actuator/Mechanical/Cycloidal Disc 2 V3.dxf

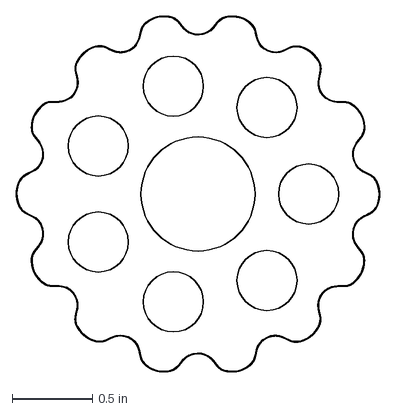
[picture p97: CAD file, 2026-03-08]
Mechanical/Cycloidal Disc 2 V3.dxf
2.26 x 2.22 in
