Angelpele/Integrated_FOC_BLDC_Actuator/Mechanical/STL Components/Outer Connector V2.stl

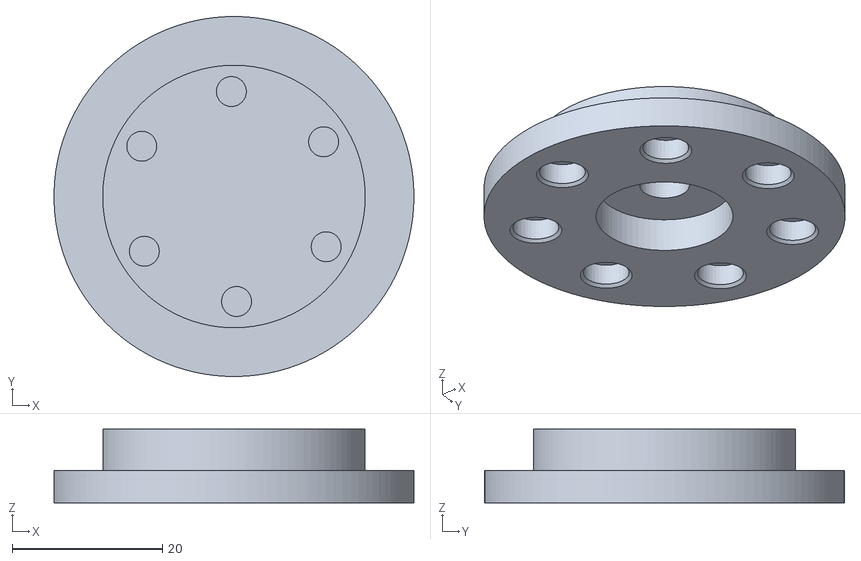
[picture p98: CAD file, 2026-02-23]
Mechanical/STL Components/Outer Connector V2.stl
48.0 x 48.0 x 9.80
