Angelpele/Integrated_FOC_BLDC_Actuator/Mechanical/V3_Feb_2026/Lower shaft V3.stl

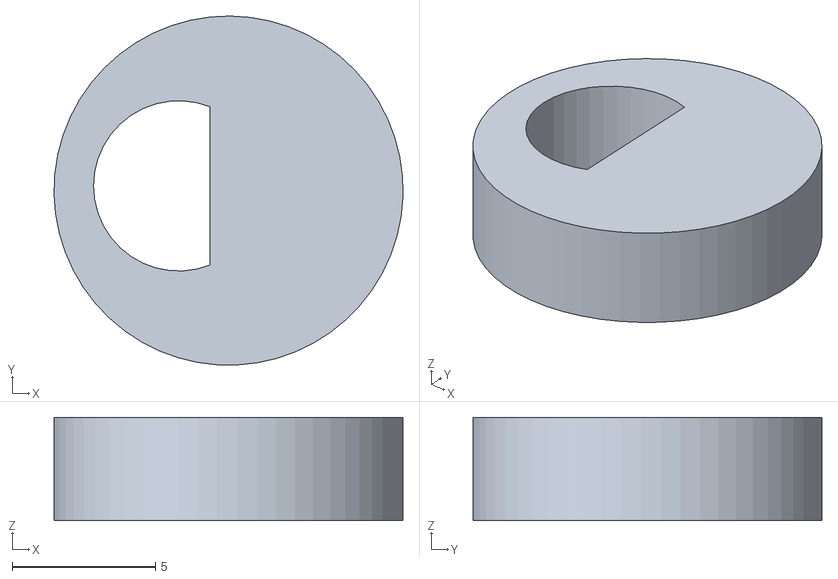
[picture p99: CAD file, 2026-03-20]
Mechanical/V3_Feb_2026/Lower shaft V3.stl
12.2 x 12.2 x 3.60
