Angelpele/Integrated_FOC_BLDC_Actuator/Mechanical/Def STL Plastic PLA/Cycloidal_Components_Def.stl

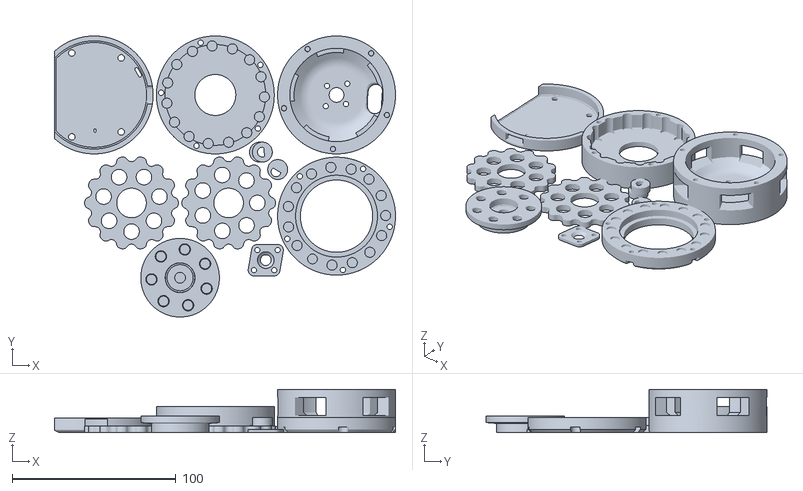
[picture p100: CAD file, 2026-03-20]
Mechanical/Def STL Plastic PLA/Cycloidal_Components_Def.stl
208.2 x 171.6 x 26.4
