Angelpele/Integrated_FOC_BLDC_Actuator/Mechanical/STL Components/Lower Shaft V2.stl

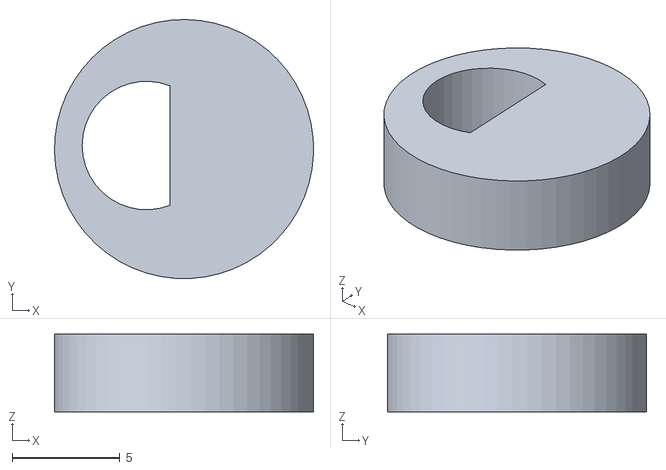
[picture p101: CAD file, 2026-02-23]
Mechanical/STL Components/Lower Shaft V2.stl
12.0 x 12.0 x 3.60
