Angelpele/Integrated_FOC_BLDC_Actuator/Mechanical/V1_2025/STL Components/Lower Shaft.stl

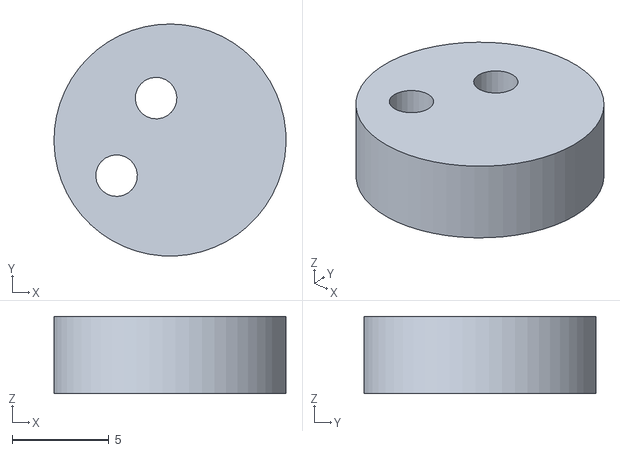
[picture p102: CAD file, 2026-02-23]
Mechanical/V1_2025/STL Components/Lower Shaft.stl
12.0 x 12.0 x 4.00
