Angelpele/Integrated_FOC_BLDC_Actuator/Mechanical/V2_Jan_2026/PCB Cover V2.stl

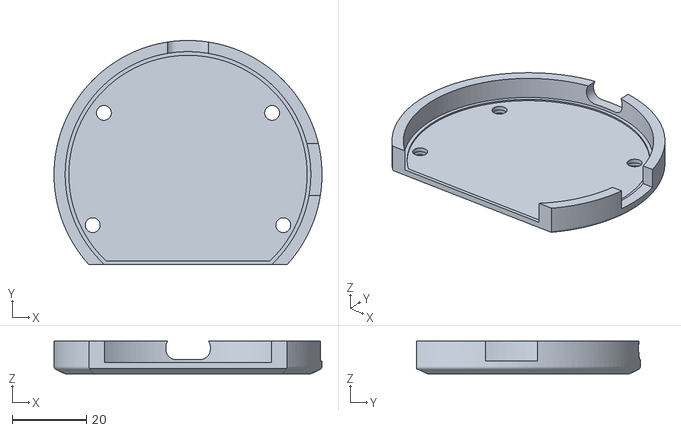
[picture p103: CAD file, 2026-03-08]
Mechanical/V2_Jan_2026/PCB Cover V2.stl
72.0 x 60.2 x 8.80
