Angelpele/Integrated_FOC_BLDC_Actuator/Mechanical/STL Components/Upper Shaft.stl

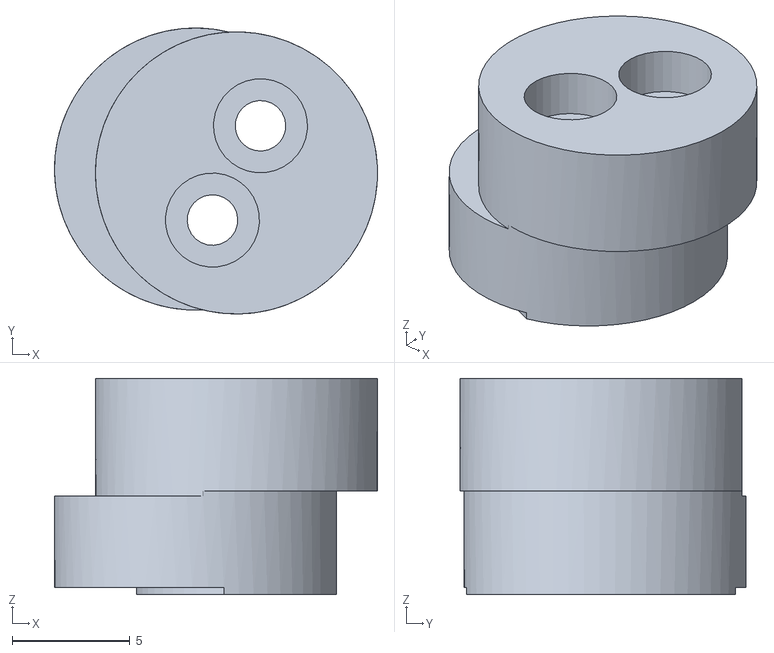
[picture p104: CAD file, 2025-12-18]
Mechanical/STL Components/Upper Shaft.stl
13.7 x 12.2 x 9.20
