Angelpele/Integrated_FOC_BLDC_Actuator/Mechanical/V2_Jan_2026/Upper Shaft V2.stl

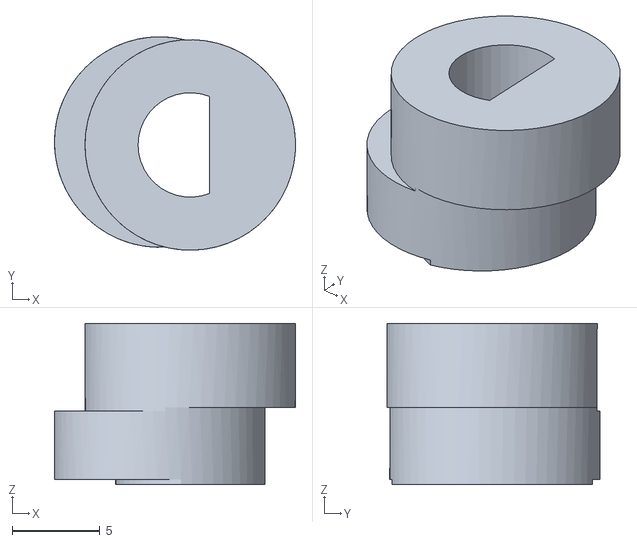
[picture p105: CAD file, 2026-03-08]
Mechanical/V2_Jan_2026/Upper Shaft V2.stl
13.7 x 12.2 x 9.20
