Angelpele/Integrated_FOC_BLDC_Actuator/Mechanical/Def STL Plastic PLA/Cycloidal_Components_Double_Case.stl

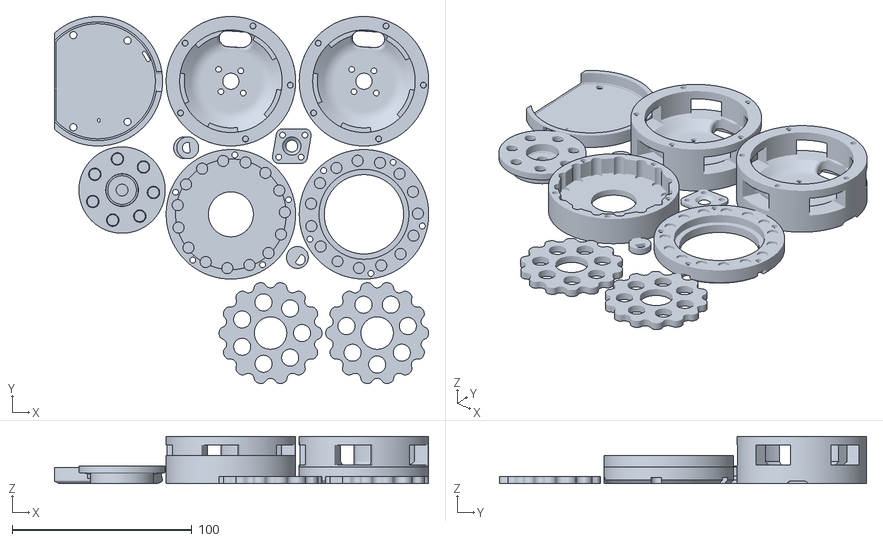
[picture p106: CAD file, 2026-03-20]
Mechanical/Def STL Plastic PLA/Cycloidal_Components_Double_Case.stl
208.2 x 204.1 x 26.4
