Angelpele/Integrated_FOC_BLDC_Actuator/Mechanical/Cycloidal Drive 1 V3.dxf

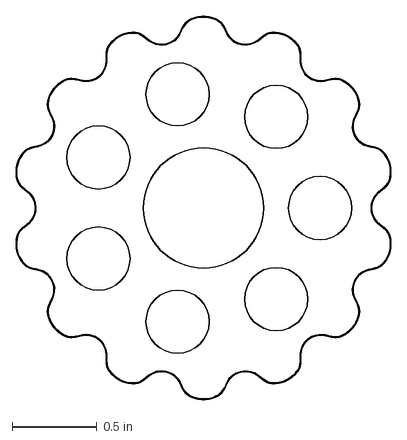
[picture p107: CAD file, 2026-03-08]
Mechanical/Cycloidal Drive 1 V3.dxf
2.22 x 2.26 in
