Angelpele/Integrated_FOC_BLDC_Actuator/Mechanical/STL Components/Inner Shaft.step

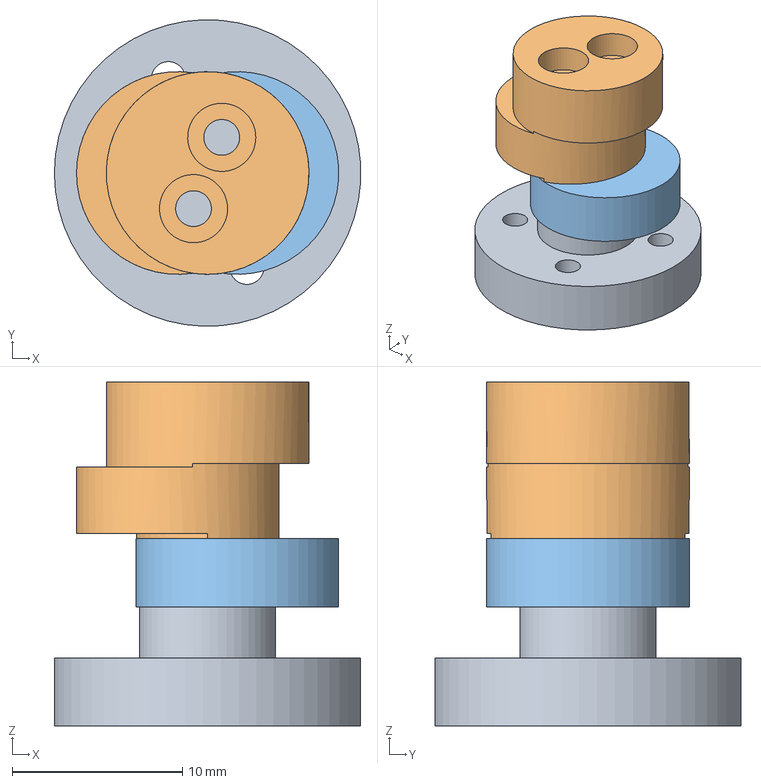
[picture p108: CAD file, 2025-11-17]
Mechanical/STL Components/Inner Shaft.step
18.0 x 18.0 x 20.2 mm
