Angelpele/Integrated_FOC_BLDC_Actuator/Mechanical/Cycloidal Drive 2.dxf

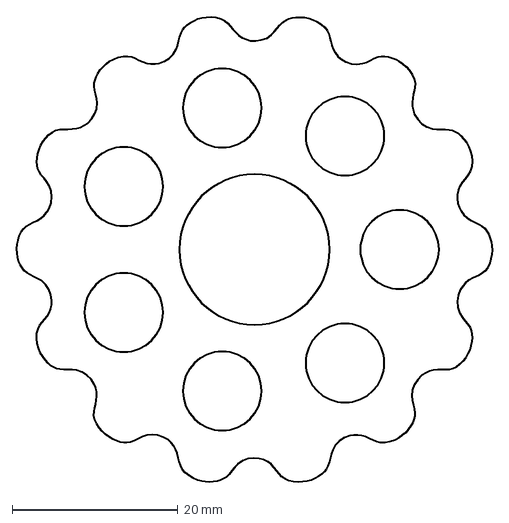
[picture p109: CAD file, 2025-11-17]
Mechanical/Cycloidal Drive 2.dxf
57.4 x 56.2 mm
