Angelpele/Integrated_FOC_BLDC_Actuator/Mechanical/STL Components/PCB Cover.stl

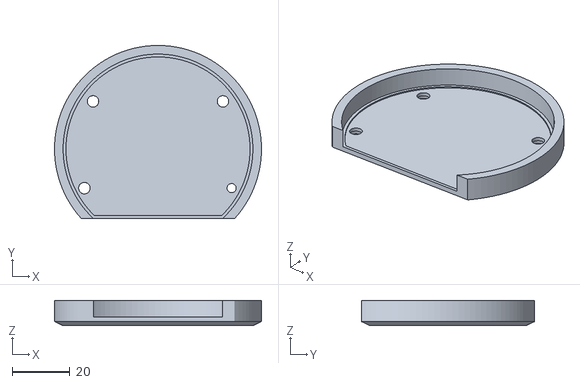
[picture p110: CAD file, 2025-11-17]
Mechanical/STL Components/PCB Cover.stl
72.0 x 60.2 x 8.80
