Angelpele/Integrated_FOC_BLDC_Actuator/(list of files, cad)

Other CAD files:
Mechanical/Def STL Plastic PLA/Main Case V5.stl
Mechanical/V1_2025/STL Components/Main Casing.stl
Mechanical/STL_Components/Main Case V4.stl
Mechanical/STL Components/Cycloidal Drive Complete.stl
Mechanical/STL_Components/Cycloidal Drive Complete V3.stl
Mechanical/STL Components/Main Casing.stl
Mechanical/V2_Jan_2026/Cycloidal Disc V2.stl
Mechanical/V3_Feb_2026/Cycloidal Disc 2 V3.stl
Mechanical/Def STL Plastic PLA/Top Cover V3.stl
Mechanical/STL_Components/PCB Cover V4.stl
Mechanical/V1_2025/STL Components/Outer Casing.stl
Mechanical/Lower_Shaft_V3.dxf
Mechanical/STL_Components/Cycloidal Disc.stl
Mechanical/Def STL Plastic PLA/Outer Casing V3.stl
Mechanical/Upper_Shaft_2_V3.dxf
Mechanical/Upper_Shaft_1_V3.dxf
Mechanical/V1_2025/STL Components/Top Cover.stl
Mechanical/Def STL Plastic PLA/Upper Shaft V3.stl
Mechanical/STL Components/Motor Connector.stl
Mechanical/STL Components/Top Cover.stl
Mechanical/5010 Brushless DC Motor 750KV v4 v10.f3d
Mechanical/BLDC Motor V2.f3z
Mechanical/BLDC Motor V3.f3z
Mechanical/Cycloidal Disc 1.f3d
Mechanical/Cycloidal Disc 2.f3d
Mechanical/Cycloidal Drive 1.dxf
Mechanical/Main Casing V2.f3z
Mechanical/STL Components/Lower Shaft.stl
Mechanical/STL Components/Outer Casing.stl
Mechanical/STL Components/Outer Connector.stl
Mechanical/STL_Components/Main Case V3.stl
Mechanical/V1_2025/BLDC Motor Exterior.f3z
Mechanical/V1_2025/BLDC Motor.f3z
Mechanical/V1_2025/Main Casing v7.f3d
