Angelpele/Integrated_FOC_BLDC_Actuator/Media/Complete Cycloidal Drive Assembly Section View.png

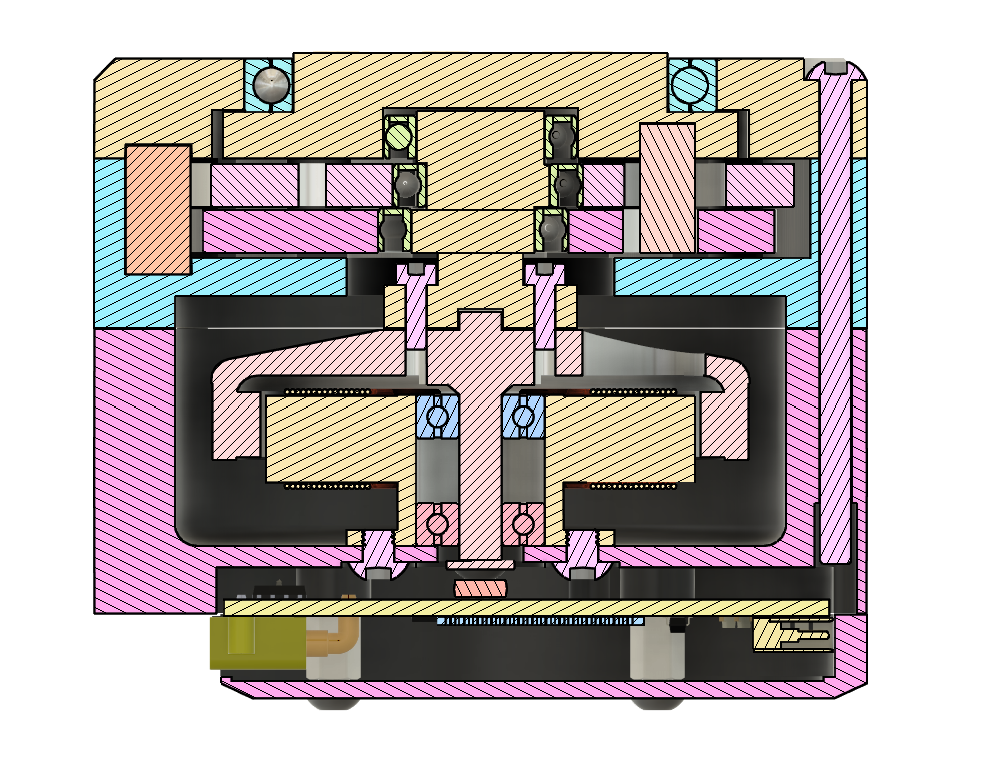
Media/Complete Cycloidal Drive Assembly Section View.png
