Angelpele/Integrated_FOC_BLDC_Actuator/Media/Final_Printed.jpg

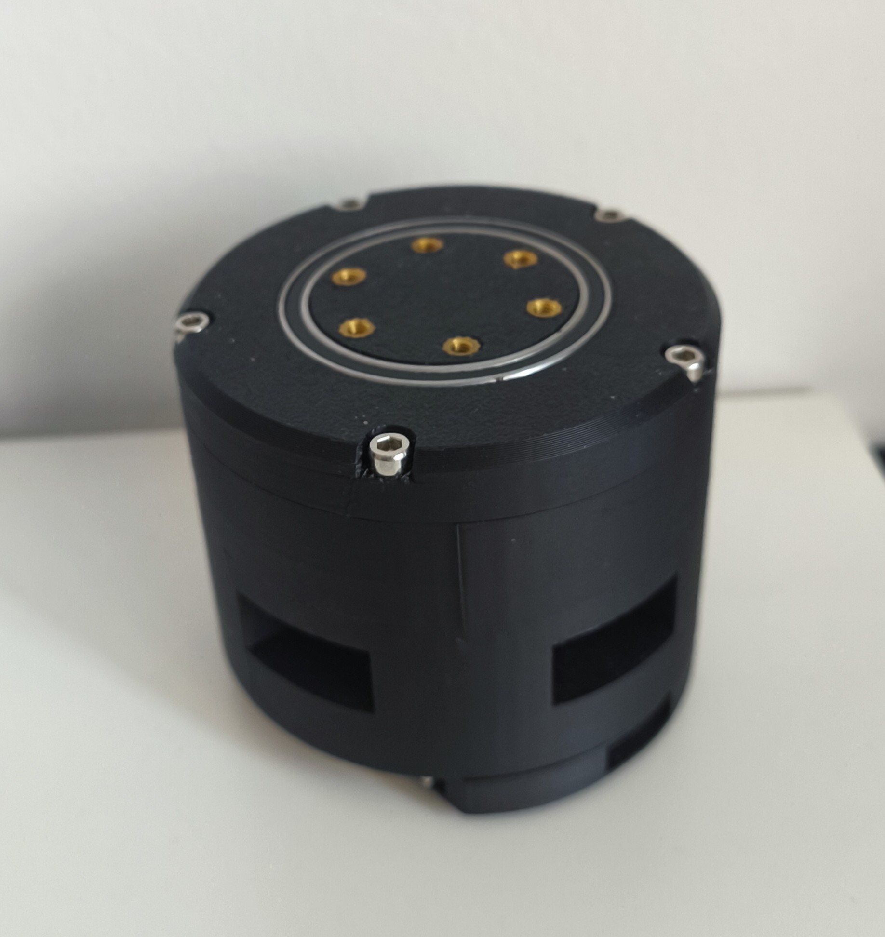
Media/Final_Printed.jpg
