Angelpele/Integrated_FOC_BLDC_Actuator/Media/PCB Top Soldered V1.jpeg

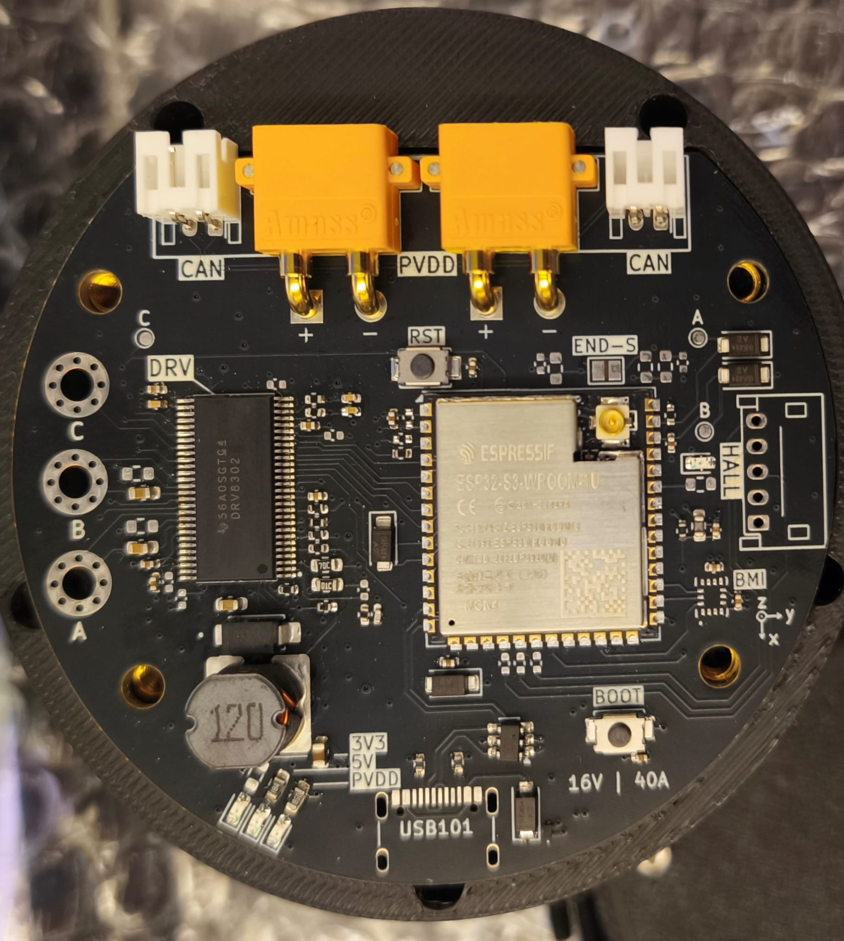
Media/PCB Top Soldered V1.jpeg
