Angelpele/Integrated_FOC_BLDC_Actuator/Media/Printed.jpg

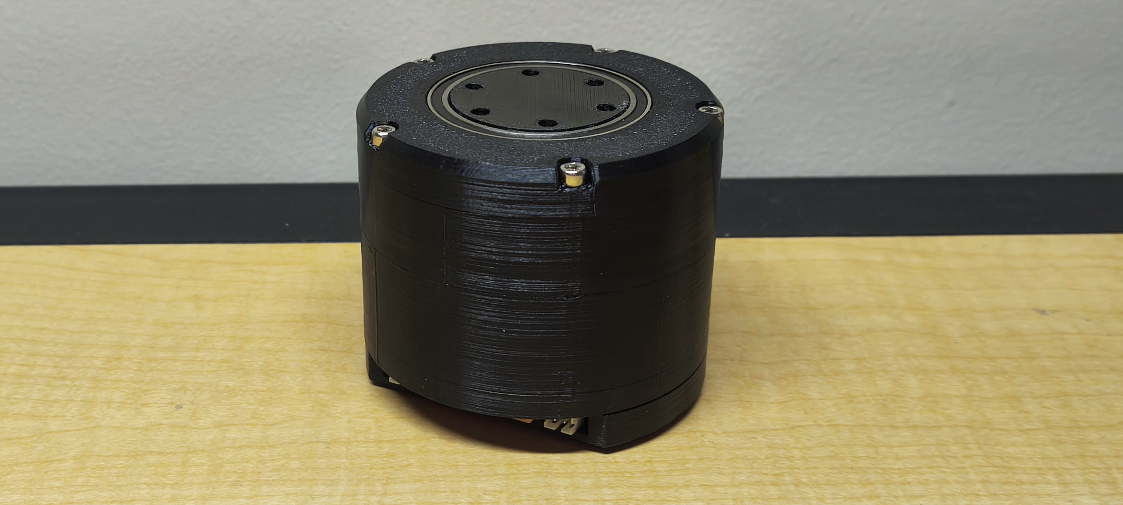
Media/Printed.jpg
