Angelpele/Integrated_FOC_BLDC_Actuator/Media/Solder paste fridge senior.jpeg

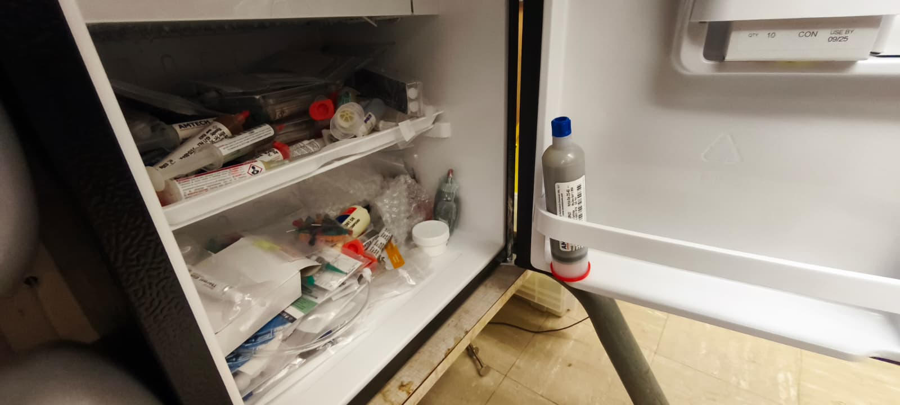
Media/Solder paste fridge senior.jpeg
