Angelpele/Integrated_FOC_BLDC_Actuator/Media/Top PCB Soldered.jpg

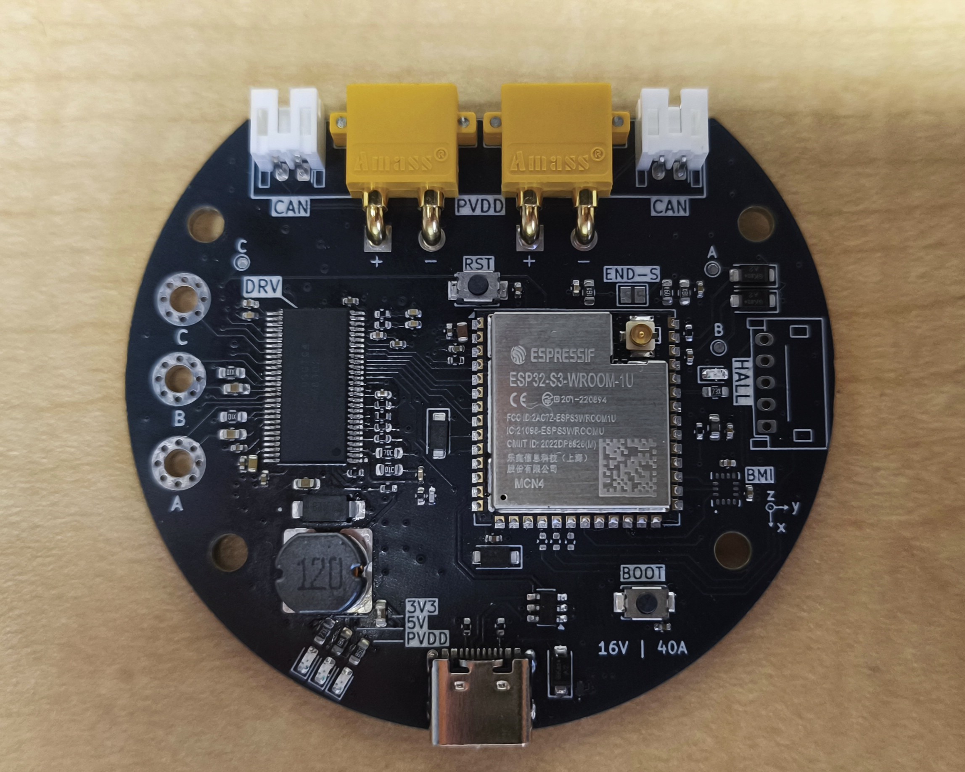
Media/Top PCB Soldered.jpg
