Angelpele/Integrated_FOC_BLDC_Actuator/(list of files, drawings)

Other design files:
Hardware/Motor_Controller+Driver (Altium)/CONTROLLER.SchDoc
Hardware/Motor_Controller+Driver (Altium)/Main_Controller.PcbDoc
Hardware/Motor_Controller+Driver (Altium)/Motor_Controller+Driver.PrjPcb
Hardware/Motor_Controller+Driver (Altium)/POWER.SchDoc
Hardware/RPP_test.ms14
Hardware/RPP_test_HIGH.ms14
