Angelpele/Integrated_FOC_BLDC_Actuator/Hardware/ESP32_Motor_Controller/ESP32_Motor_Controller.kicad_pcb

## KiCad design Hardware/ESP32_Motor_Controller/ESP32_Motor_Controller.kicad_pcb (2026-05-08)

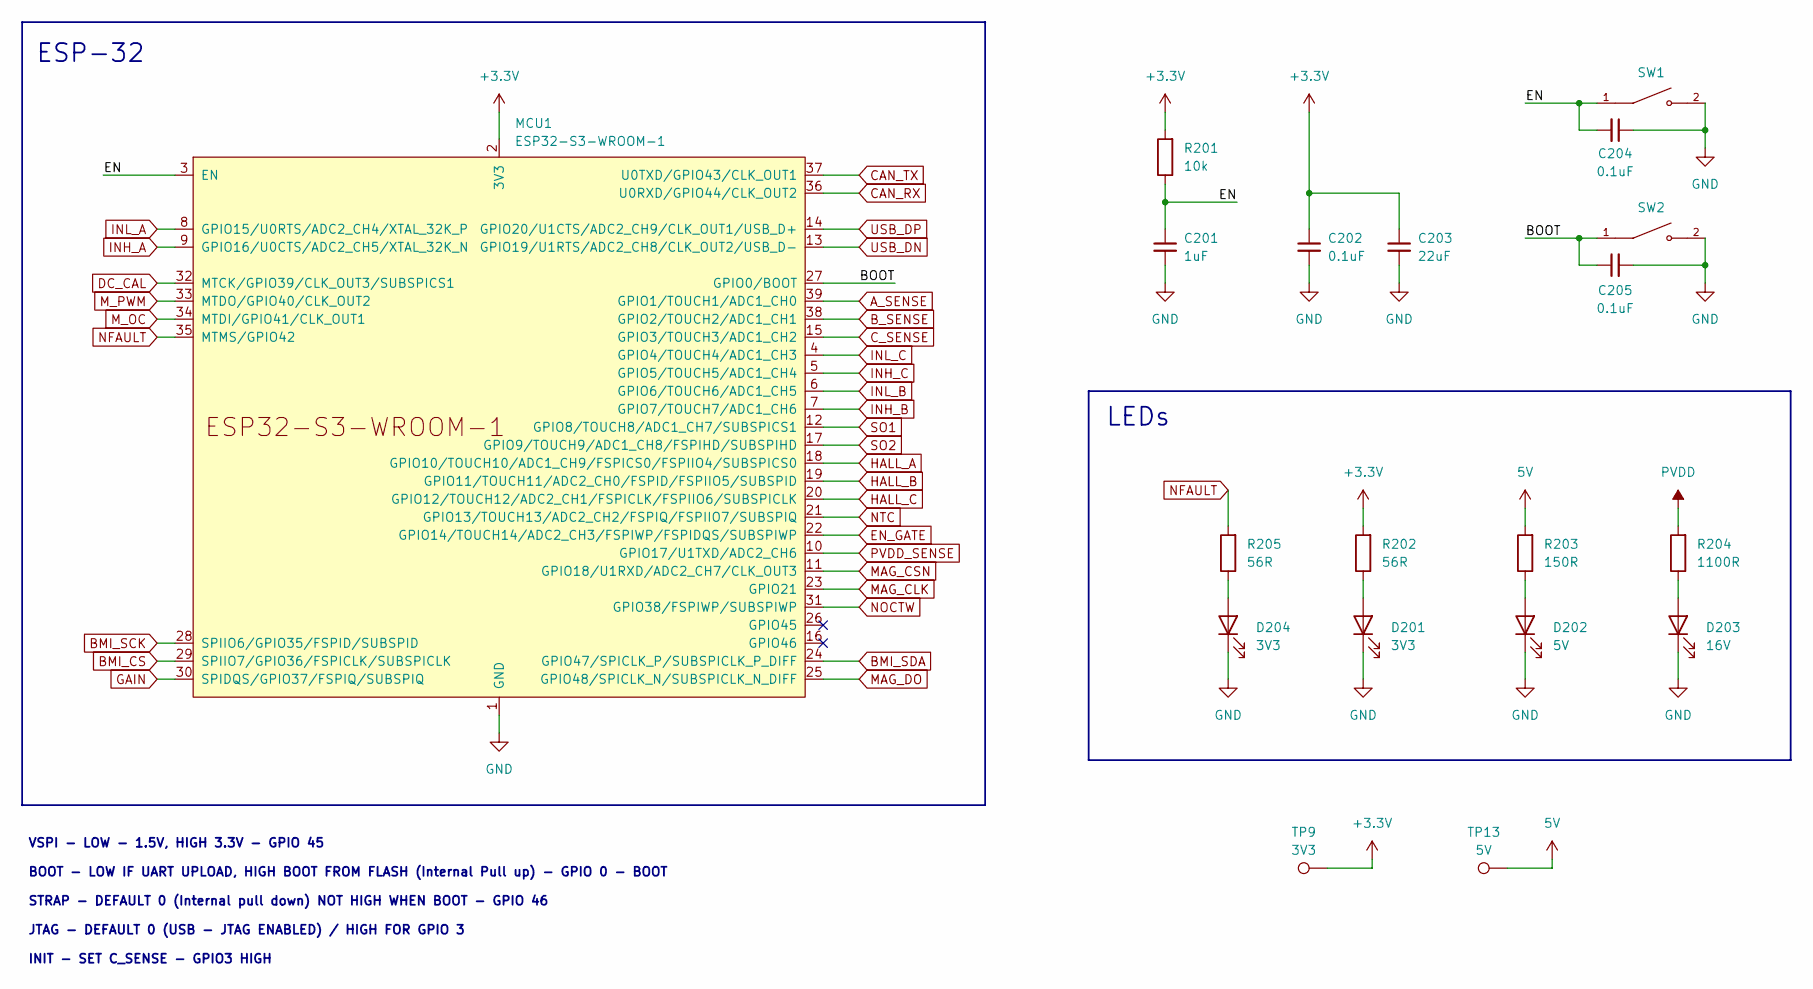
[picture p138: schematic CONTROLLER [2].kicad_sch, CONTROLLER]

Parts:
C201: 1uF; C_0603_1608Metric
C202, C204, C205: 0.1uF; C_0402_1005Metric
C203: 22uF; C_0805_2012Metric
D201, D204: 3V3; LED_0603_1608Metric
D202: 5V; LED_0603_1608Metric
D203: 16V; LED_0603_1608Metric
MCU1: ESP32-S3-WROOM-1; ESP32-S3-WROOM-1U
R201: 10k; R_0402_1005Metric
R202, R205: 56R; R_0603_1608Metric
R203: 150R; R_0603_1608Metric
R204: 1100R; R_0603_1608Metric
SW1, SW2: TS-1088-AR02016; SW_TS-1088-AR02016; PARTREV N/A
TP9: 3V3; TestPoint_Pad_D1.0mm
TP13: 5V; TestPoint_Pad_D1.0mm

Connections:
3V3: C202.1, C203.1, MCU1.2 (3V3), R201.2, R202.2, TP9.1; also elsewhere on the board
5V: R203.2, TP13.1; also elsewhere on the board
/CONTROLLER/BOOT: C205.1, MCU1.27 (GPIO0/BOOT), SW2.1; also elsewhere on the board
/CONTROLLER/EN: C201.1, C204.2, MCU1.3 (EN), R201.1, SW1.1; also elsewhere on the board
AGND: C201.2, C202.2, C203.2, C204.1, C205.2, D201.1 (K), D202.1 (K), D203.1 (K), D204.1 (K), MCU1.1 (GND), MCU1.40 (GND), MCU1.41 (GND), SW1.2, SW2.2; also elsewhere on the board
NFAULT: MCU1.35 (MTMS/GPIO42), R205.2; also elsewhere on the board
unnamed: D201.2 (A), R202.1
unnamed: D202.2 (A), R203.1
unnamed: D203.2 (A), R204.1
unnamed: D204.2 (A), R205.1
PVDD: R204.2; also elsewhere on the board

Notes on the sheet:
VSPI - LOW - 1.5V, HIGH 3.3V - GPIO 45 BOOT - LOW IF UART UPLOAD, HIGH BOOT FROM FLASH (Internal Pull up) - GPIO 0 - BOOT STRAP - DEFAULT 0 (Internal pull down) NOT HIGH WHEN BOOT - GPIO 46 JTAG - DEFAULT 0 (USB - JTAG ENABLED) / HIGH FOR GPIO 3 INIT - SET C_SENSE - GPIO3 HIGH
ESP-32
LEDs

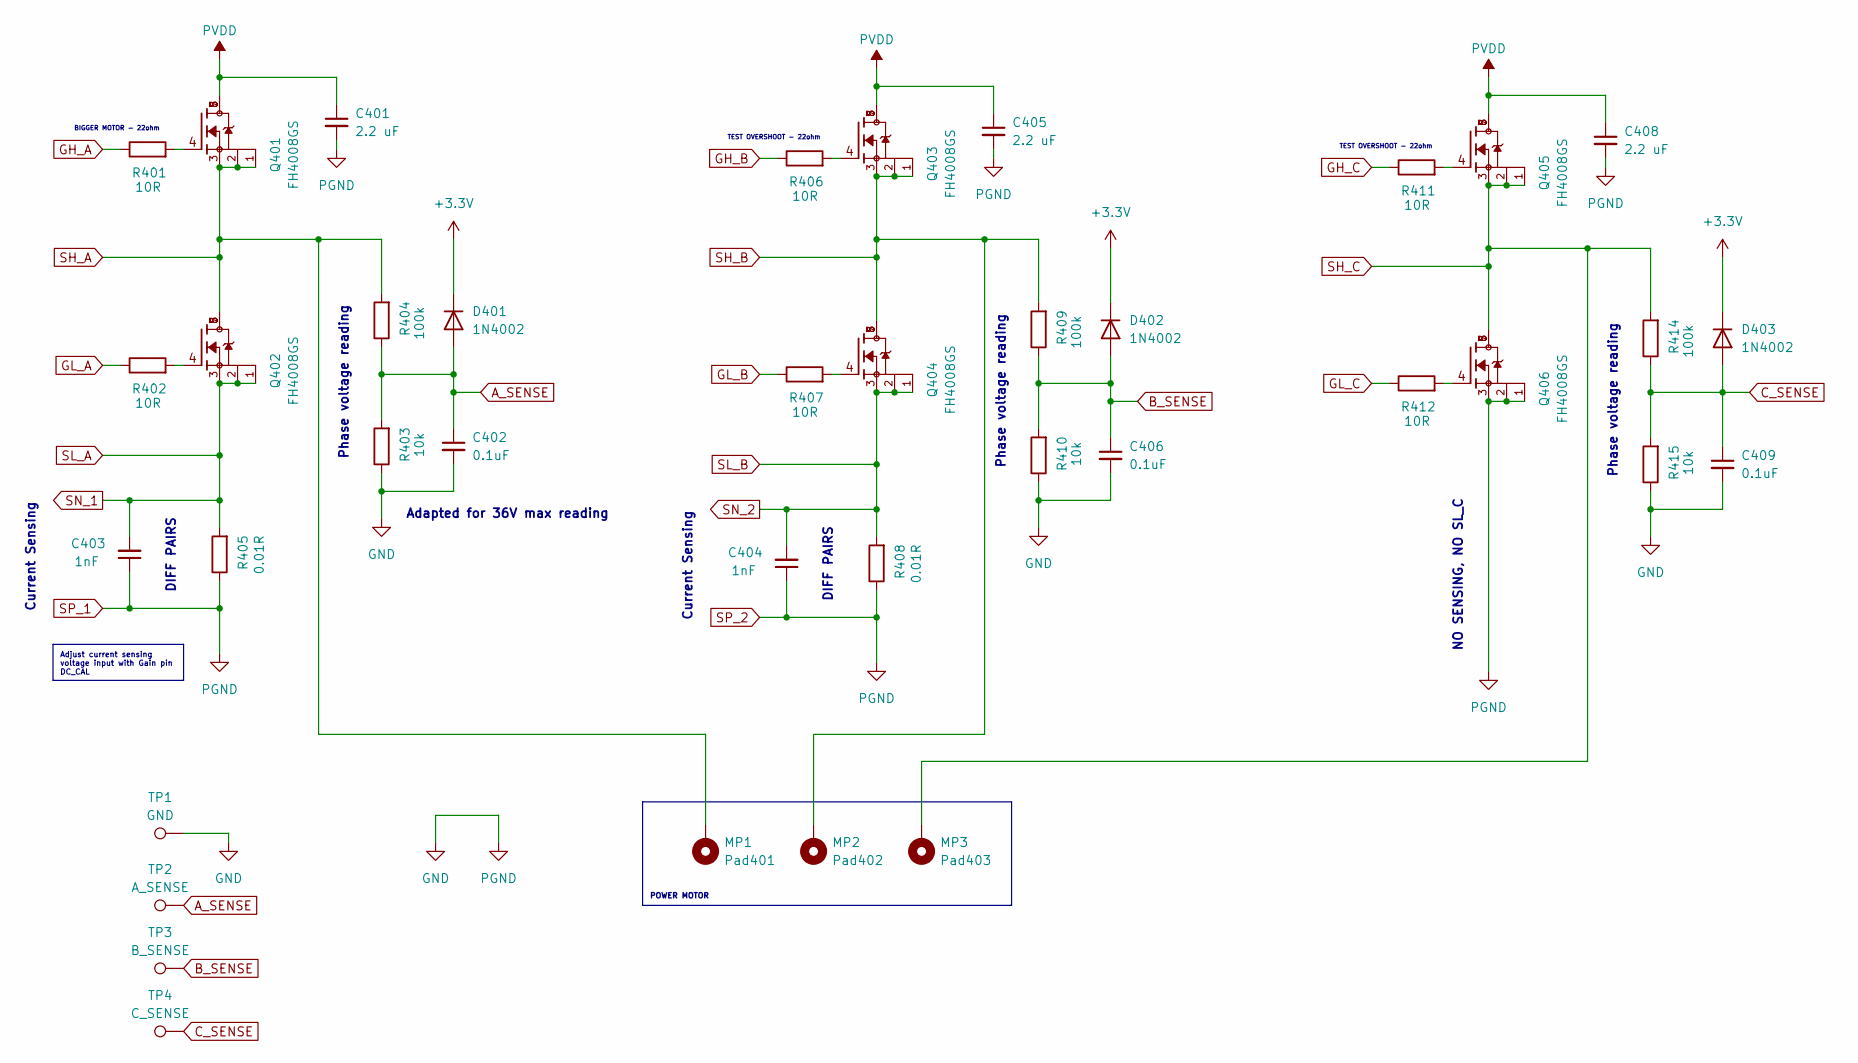
[picture p139: schematic POWER_MOSFET.kicad_sch, POWER MOSFET]

Parts:
C401, C405, C408: 2.2 uF; C_0805_2012Metric
C402, C406, C409: 0.1uF; C_0402_1005Metric
C403, C404: 1nF; C_0402_1005Metric
D401, D402, D403: 1N4002; D_SOD-123
MP1: Pad401; MountingHole_2.5mm_Pad_Via
MP2: Pad402; MountingHole_2.5mm_Pad_Via
MP3: Pad403; MountingHole_2.5mm_Pad_Via
Q401, Q402, Q403, Q404, Q405, Q406: FH4008GS; PQFN-8-EP_6x5mm_P1.27mm_Generic
R401, R402, R406, R407, R411, R412: 10R; R_0603_1608Metric
R403, R410, R415: 10k; R_0402_1005Metric
R404, R409, R414: 100k; R_0402_1005Metric
R405, R408: 0.01R; R_2512_6332Metric
TP1: GND; TestPoint_Pad_D1.0mm
TP2: A_SENSE; TestPoint_Pad_D1.0mm
TP3: B_SENSE; TestPoint_Pad_D1.0mm
TP4: C_SENSE; TestPoint_Pad_D1.0mm

Connections:
3V3: D401.1 (K), D402.1 (K), D403.1 (K); also elsewhere on the board
AGND: C401.2, C402.2, C403.1, C404.1, C405.2, C406.2, C408.2, C409.2, Q406.1, Q406.2, Q406.3, R403.1, R405.1, R408.1, R410.1, R415.1, TP1.1; also elsewhere on the board
A_SENSE: C402.1, D401.2 (A), R403.2, R404.1, TP2.1; also elsewhere on the board
B_SENSE: C406.1, D402.2 (A), R409.1, R410.2, TP3.1; also elsewhere on the board
C_SENSE: C409.1, D403.2 (A), R414.1, R415.2, TP4.1; also elsewhere on the board
GH_A: R401.1; also elsewhere on the board
GH_B: R406.1; also elsewhere on the board
GH_C: R411.1; also elsewhere on the board
GL_A: R402.1; also elsewhere on the board
GL_B: R407.1; also elsewhere on the board
GL_C: R412.1; also elsewhere on the board
unnamed: Q401.4, R401.2
unnamed: Q402.4, R402.2
unnamed: Q403.4, R406.2
unnamed: Q404.4, R407.2
unnamed: Q405.4, R411.2
unnamed: Q406.4, R412.2
PVDD: C401.1, C405.1, C408.1, Q401.5, Q401.6, Q401.7, Q401.8, Q403.5, Q403.6, Q403.7, Q403.8, Q405.5, Q405.6, Q405.7, Q405.8; also elsewhere on the board
SH_A: MP1.1, Q401.1, Q401.2, Q401.3, Q402.5, Q402.6, Q402.7, Q402.8, R404.2; also elsewhere on the board
SH_B: MP2.1, Q403.1, Q403.2, Q403.3, Q404.5, Q404.6, Q404.7, Q404.8, R409.2; also elsewhere on the board
SH_C: MP3.1, Q405.1, Q405.2, Q405.3, Q406.5, Q406.6, Q406.7, Q406.8, R414.2; also elsewhere on the board
SL_A: C403.2, Q402.1, Q402.2, Q402.3, R405.2; also elsewhere on the board
SL_B: C404.2, Q404.1, Q404.2, Q404.3, R408.2; also elsewhere on the board

Notes on the sheet:
NO SENSING, NO SL_C
Current Sensing
TEST OVERSHOOT - 22ohm
BIGGER MOTOR - 22ohm
Adapted for 36V max reading
Phase voltage reading
DIFF PAIRS
POWER MOTOR
Adjust current sensing voltage input with Gain pin DC_CAL

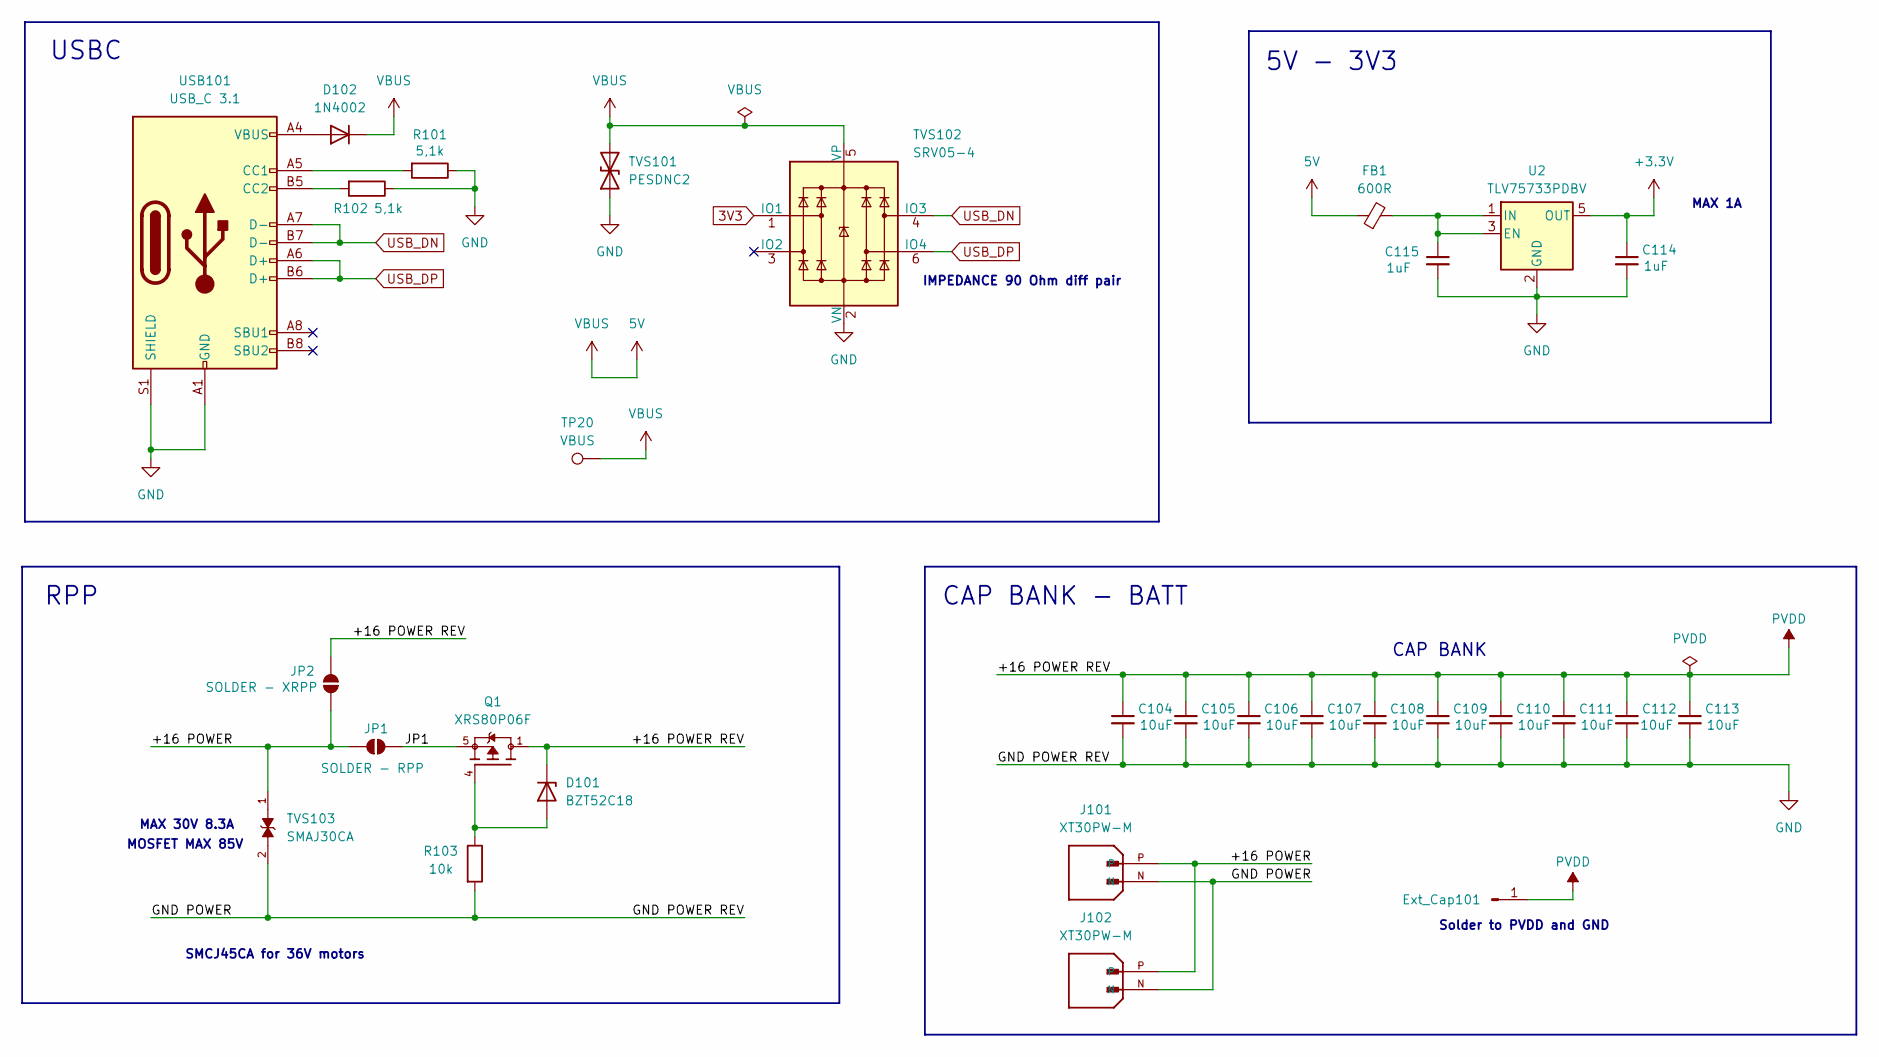
[picture p140: schematic POWER [1].kicad_sch, POWER]

Parts:
C104, C105, C106, C107, C108, C109, C110, C111, C112, C113: 10uF; C_0805_2012Metric
C114, C115: 1uF; C_0603_1608Metric
D101: BZT52C18; D_SOD-123
D102: 1N4002; D_SOD-123
Ext_Cap101: Conn_01x01_Pin; PinHeader_1x01_P2.00mm_Vertical
FB1: 600R; L_0603_1608Metric
J101, J102: XT30PW-M; AMASS_XT30PW-M; PARTREV 1.2
JP1: SOLDER - RPP; SolderJumper-2_P1.3mm_Open_Pad1.0x1.5mm
JP2: SOLDER - XRPP; SolderJumper-2_P1.3mm_Open_Pad1.0x1.5mm
Q1: XRS80P06F; MOUSER_PART_NUMBER 781-SI7149DP-GE3
R101, R102: 5,1k; R_0402_1005Metric
R103: 10k; R_0402_1005Metric
TP20: VBUS; TestPoint_Pad_D1.0mm
TVS101: PESDNC2; D_0201_0603Metric
TVS102: SRV05-4; SOT-23-6
TVS103: SMAJ30CA; D_SMC; PARTREV S2102; DigiKey_Part_Number 1801-SMAJ30CATR-ND
U2: TLV75733PDBV; SOT-23-5
USB101: USB_C 3.1; USB_C_Receptacle_Palconn_UTC16-G

Connections:
3V3: C114.1, TVS102.1 (IO1), U2.5 (OUT); also elsewhere on the board
5V: D102.1 (K), FB1.1, TP20.1, TVS101.2 (A2), TVS102.5 (VP); also elsewhere on the board
/POWER/+16 POWER: J101.P, J102.P, JP1.2 (B), JP2.1 (A), TVS103.1
/POWER/JP1: JP1.1 (A), Q1.5, Q1.6, Q1.7, Q1.8, Q1.9
AGND: C104.2, C105.2, C106.2, C107.2, C108.2, C109.2, C110.2, C111.2, C112.2, C113.2, C114.2, C115.2, J101.N, J102.N, R101.1, R102.1, R103.2, TVS101.1 (A1), TVS102.2 (VN), TVS103.2, U2.2 (GND), USB101.A1 (GND), USB101.A12 (GND), USB101.B1 (GND), USB101.B12 (GND), USB101.S1 (SHIELD); also elsewhere on the board
unnamed: D101.2 (A), Q1.4, R103.1
unnamed 50: D102.2 (A), USB101.A4 (VBUS), USB101.A9 (VBUS), USB101.B4 (VBUS), USB101.B9 (VBUS); also elsewhere on the board
unnamed 66: C115.1, FB1.2, U2.1 (IN), U2.3 (EN); also elsewhere on the board
unnamed 83: R101.2, USB101.A5 (CC1); also elsewhere on the board
unnamed 84: R102.2, USB101.B5 (CC2); also elsewhere on the board
PVDD: C104.1, C105.1, C106.1, C107.1, C108.1, C109.1, C110.1, C111.1, C112.1, C113.1, D101.1 (K), Ext_Cap101.1, JP2.2 (B), Q1.1, Q1.2, Q1.3; also elsewhere on the board
USB_DN: TVS102.4 (IO3), USB101.A7 (D-), USB101.B7 (D-); also elsewhere on the board
USB_DP: TVS102.6 (IO4), USB101.A6 (D+), USB101.B6 (D+); also elsewhere on the board

Notes on the sheet:
RPP
MAX 30V 8.3A
Solder to PVDD and GND
5V - 3V3
USBC
MAX 1A
SMCJ45CA for 36V motors
IMPEDANCE 90 Ohm diff pair
MOSFET MAX 85V
CAP BANK - BATT
CAP BANK

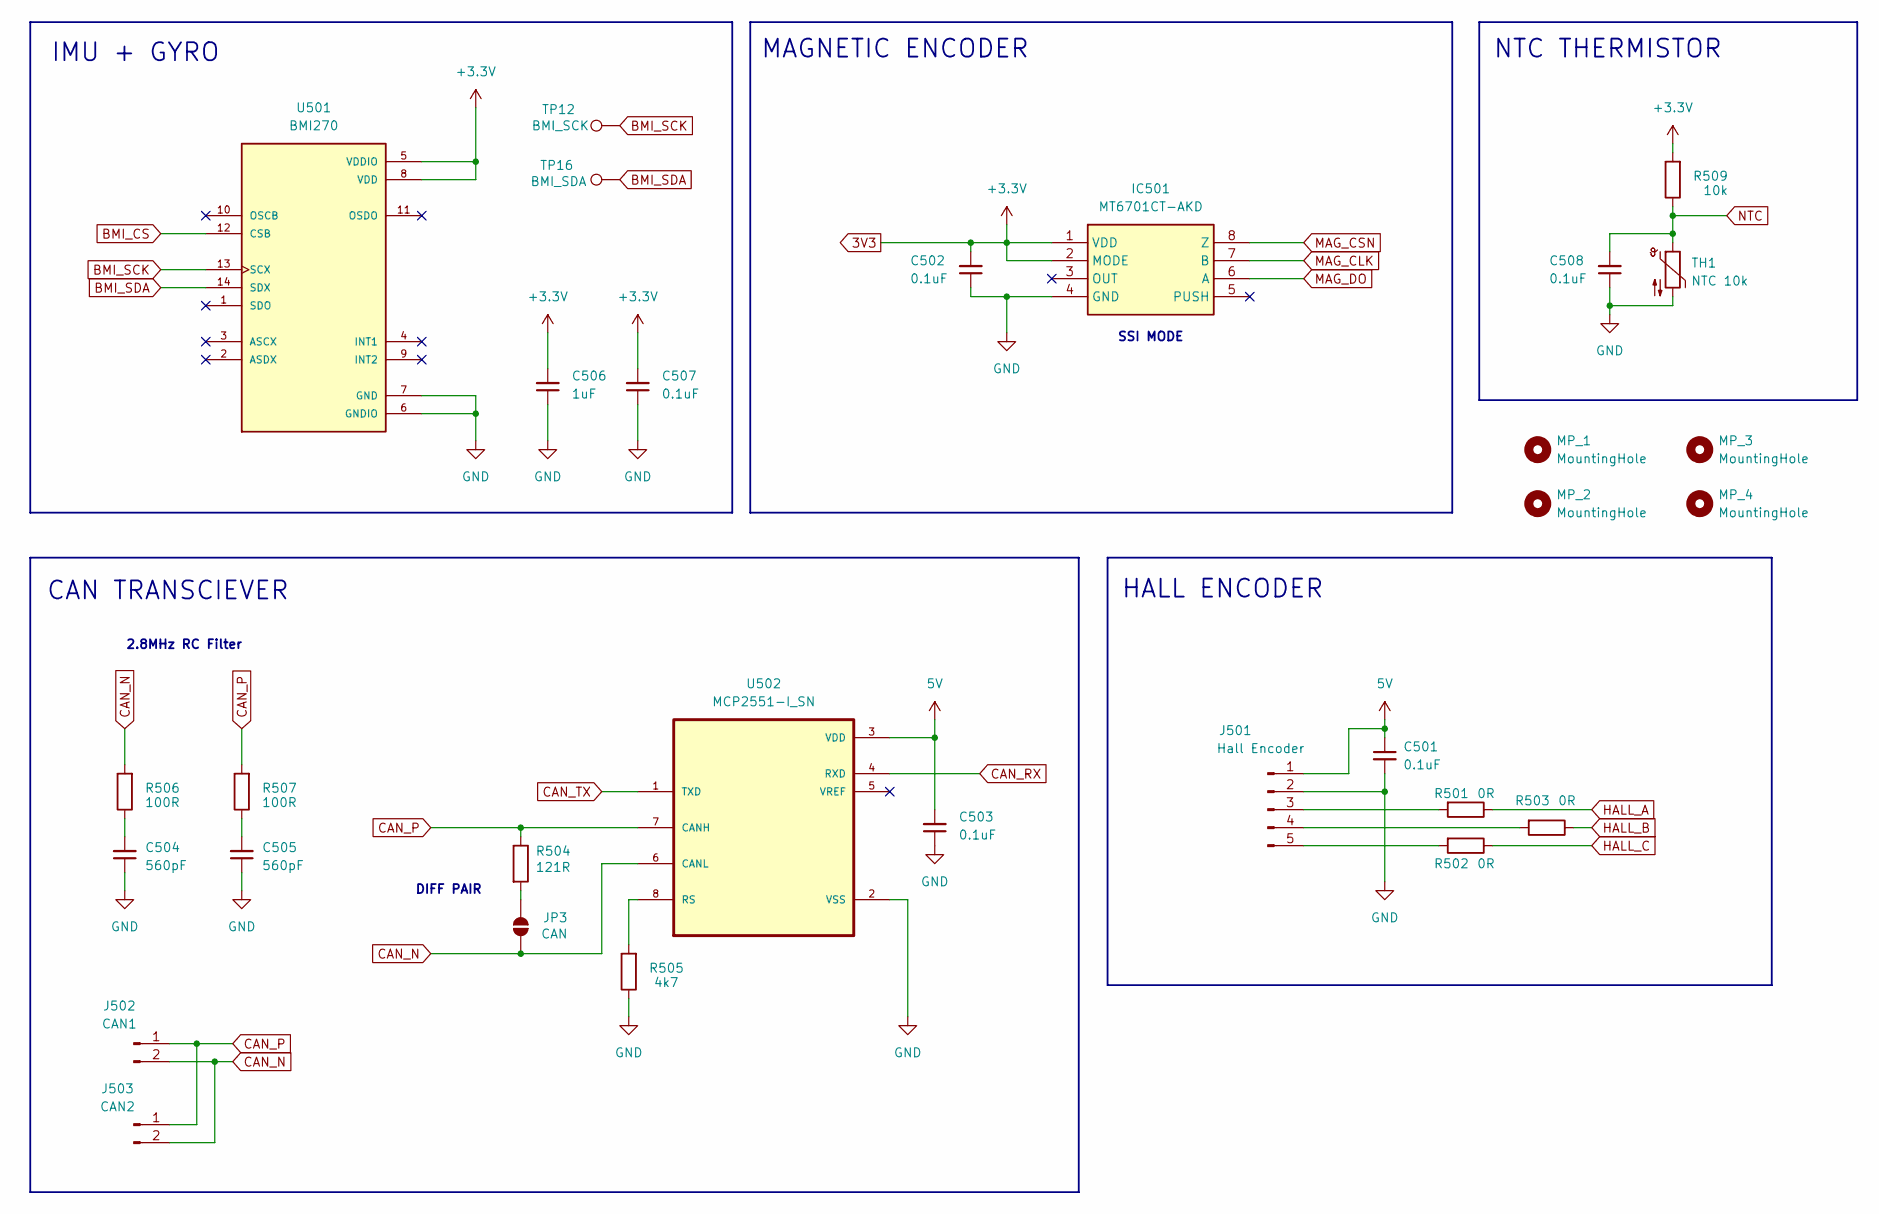
[picture p141: schematic SENSORS.kicad_sch]

Parts:
C501, C502, C503, C507, C508: 0.1uF; C_0402_1005Metric
C504, C505: 560pF; R_0402_1005Metric
C506: 1uF; C_0402_1005Metric
IC501: MT6701CT-AKD; SOIC127P600X175-8N; Manufacturer_Part_Number MT6701CT-STD-R
J501: Hall Encoder; JST_PH_S5B-PH-K_1x05_P2.00mm_Horizontal
J502: CAN1; JST_PH_S2B-PH-K_1x02_P2.00mm_Horizontal
J503: CAN2; JST_PH_S2B-PH-K_1x02_P2.00mm_Horizontal
JP3: CAN; SolderJumper-2_P1.3mm_Open_Pad1.0x1.5mm
MP_1, MP_2, MP_3, MP_4: MountingHole; MountingHole_3.2mm_M3
R501, R502, R503: 0R; R_0402_1005Metric
R504: 121R; R_0603_1608Metric
R505: 4k7; R_0402_1005Metric
R506, R507: 100R; R_0603_1608Metric
R509: 10k; R_0402_1005Metric
TH1: NTC 10k; R_0603_1608Metric
TP12: BMI_SCK; TestPoint_Pad_D1.0mm
TP16: BMI_SDA; TestPoint_Pad_D1.0mm
U501: BMI270; XDCR_BMI270
U502: MCP2551-I_SN; SOIC127P599X175-8N

Connections:
3V3: C502.2, C506.2, C507.2, IC501.1 (VDD), IC501.2 (MODE), R509.2, U501.5 (VDDIO), U501.8 (VDD); also elsewhere on the board
5V: C501.1, C503.2, J501.1, U502.3 (VDD); also elsewhere on the board
AGND: C501.2, C502.1, C503.1, C504.1, C505.1, C506.1, C507.1, C508.1, IC501.4 (GND), J501.2, R505.1, TH1.2, U501.6 (GNDIO), U501.7 (GND), U502.2 (VSS); also elsewhere on the board
BMI_CS: U501.12 (CSB); also elsewhere on the board
BMI_SCK: TP12.1, U501.13 (SCX); also elsewhere on the board
BMI_SDA: TP16.1, U501.14 (SDX); also elsewhere on the board
CAN_N: J502.2, J503.2, JP3.1 (A), R506.2, U502.6 (CANL)
CAN_P: J502.1, J503.1, R504.1, R507.2, U502.7 (CANH)
CAN_RX: U502.4 (RXD); also elsewhere on the board
CAN_TX: U502.1 (TXD); also elsewhere on the board
HALL_A: R501.1; also elsewhere on the board
HALL_B: R503.1; also elsewhere on the board
HALL_C: R502.1; also elsewhere on the board
MAG_CLK: IC501.7 (B); also elsewhere on the board
MAG_CSN: IC501.8 (Z); also elsewhere on the board
MAG_DO: IC501.6 (A); also elsewhere on the board
NTC: C508.2, R509.1, TH1.1; also elsewhere on the board
unnamed: C504.2, R506.1
unnamed: C505.2, R507.1
unnamed: J501.3, R501.2
unnamed: J501.4, R503.2
unnamed: J501.5, R502.2
unnamed: JP3.2 (B), R504.2
unnamed: R505.2, U502.8 (RS)

Notes on the sheet:
IMU + GYRO
CAN TRANSCIEVER
2.8MHz RC Filter
DIFF PAIR
MAGNETIC ENCODER
HALL ENCODER
SSI MODE
NTC THERMISTOR

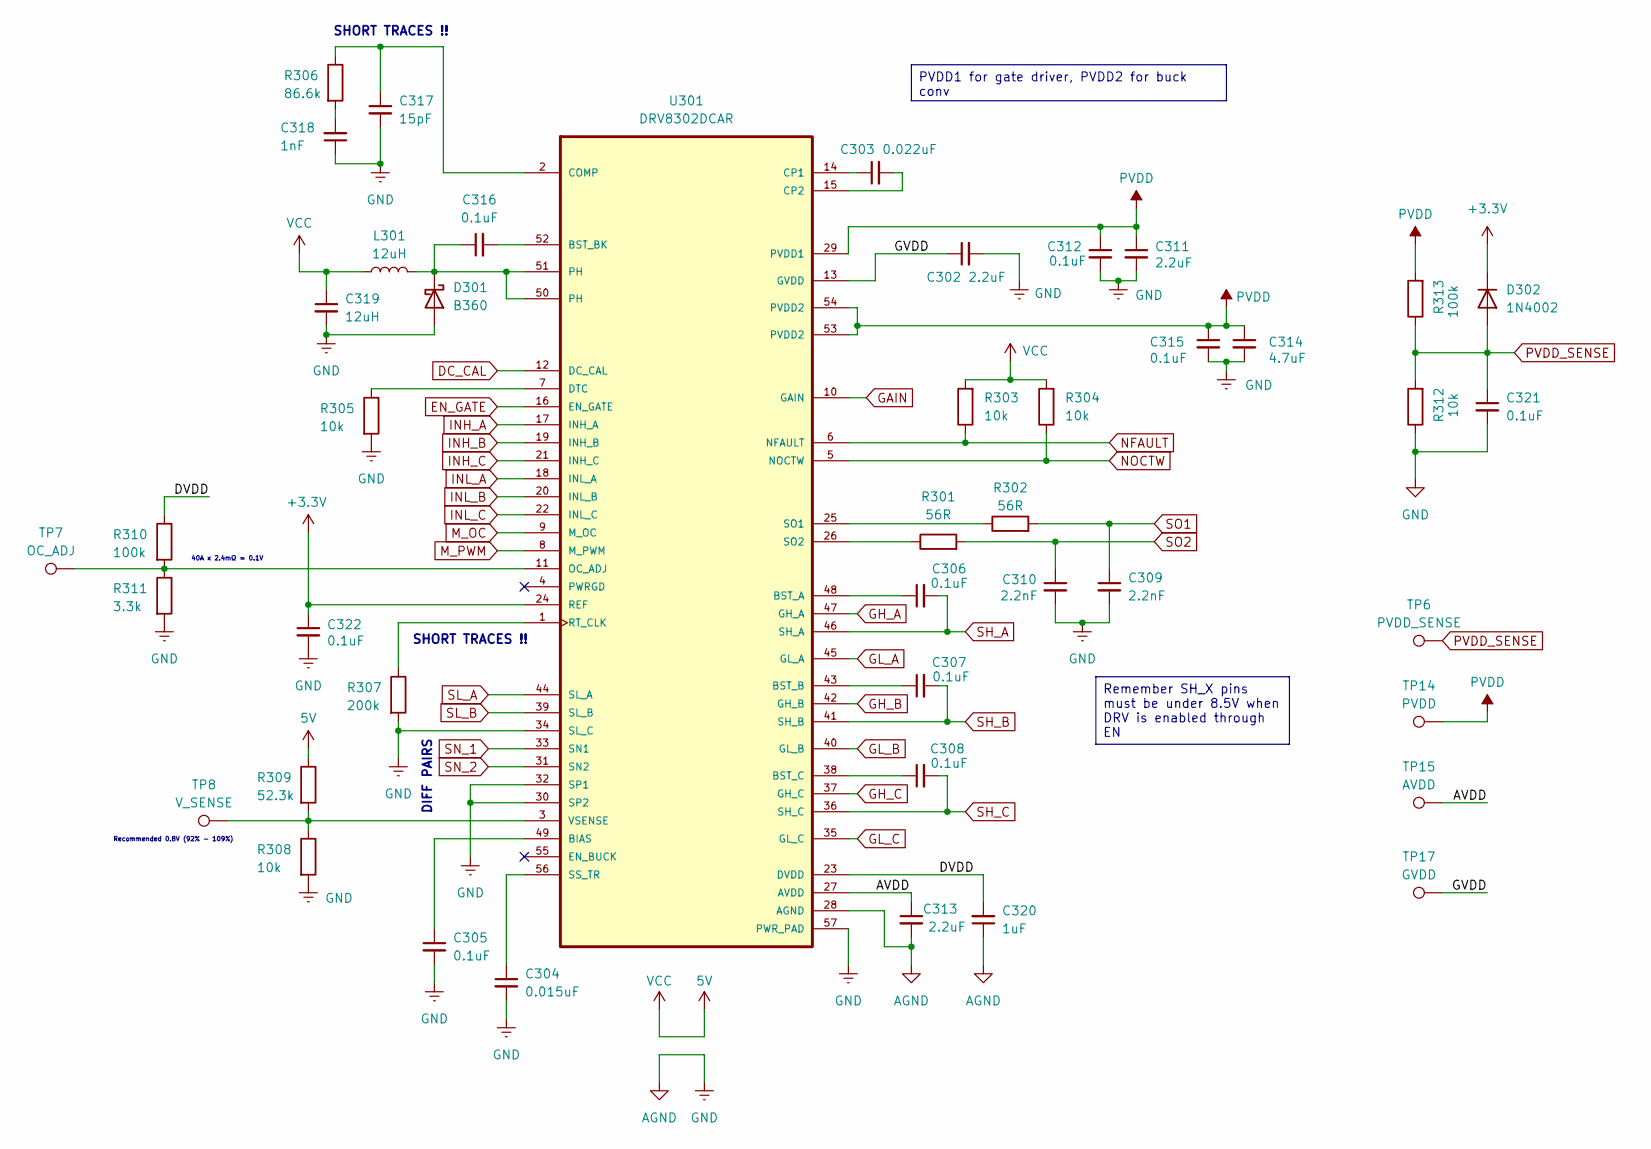
[picture p142: schematic GATE DRIVER [3].kicad_sch, GATE DRIVER]

Parts:
C302: 2.2uF; C_0603_1608Metric
C303: 0.022uF; C_0402_1005Metric
C304: 0.015uF; C_0402_1005Metric
C305, C322: 0.1uF; C_0402_1005Metric
C306, C307, C308, C321: 0.1uF; C_0603_1608Metric
C309, C310: 2.2nF; C_0402_1005Metric
C311, C313: 2.2uF; C_0805_2012Metric
C312, C315, C316: 0.1uF; C_0805_2012Metric
C314: 4.7uF; C_0805_2012Metric
C317: 15pF; C_0603_1608Metric
C318: 1nF; C_0402_1005Metric
C319: 12uH; C_0805_2012Metric
C320: 1uF; C_0603_1608Metric
D301: B360; B3030A
D302: 1N4002; D_SOD-123
L301: 12uH; SM7850
R301, R302: 56R; R_0402_1005Metric
R303, R304, R305: 10k; R_0402_1005Metric
R306: 86.6k; R_0402_1005Metric
R307: 200k; R_0402_1005Metric
R308, R312: 10k; R_0603_1608Metric
R309: 52.3k; R_0603_1608Metric
R310: 100k; R_0402_1005Metric
R311: 3.3k; R_0402_1005Metric
R313: 100k; R_0603_1608Metric
TP6: PVDD_SENSE; TestPoint_Pad_D1.0mm
TP7: OC_ADJ; TestPoint_Pad_D1mm
TP8: V_SENSE; TestPoint_Pad_D1.0mm
TP14: PVDD; TestPoint_Pad_D1.0mm
TP15: AVDD; TestPoint_Pad_D1.0mm
TP17: GVDD; TestPoint_Pad_D1.0mm
U301: DRV8302DCAR; DRV8302

Connections:
3V3: C322.1, D302.1 (K), U301.24 (REF); also elsewhere on the board
5V: C319.1, L301.1, R303.2, R304.2, R309.1; also elsewhere on the board
/GATE DRIVER/AVDD: C313.1, TP15.1, U301.27 (AVDD); also elsewhere on the board
/GATE DRIVER/DVDD: C320.2, R310.1, U301.23 (DVDD)
/GATE DRIVER/GVDD: C302.1, TP17.1, U301.13 (GVDD)
AGND: C302.2, C304.2, C305.2, C309.2, C310.2, C311.2, C312.2, C313.2, C314.2, C315.2, C317.2, C318.1, C319.2, C320.1, C321.2, C322.2, D301.2 (A), R305.2, R307.2, R308.2, R311.2, R312.1, U301.28 (AGND), U301.30 (SP2), U301.32 (SP1), U301.34 (SL_C), U301.57 (PWR_PAD); also elsewhere on the board
DC_CAL: U301.12 (DC_CAL); also elsewhere on the board
EN_GATE: U301.16 (EN_GATE); also elsewhere on the board
GAIN: U301.10 (GAIN); also elsewhere on the board
GH_A: U301.47 (GH_A); also elsewhere on the board
GH_B: U301.42 (GH_B); also elsewhere on the board
GH_C: U301.37 (GH_C); also elsewhere on the board
GL_A: U301.45 (GL_A); also elsewhere on the board
GL_B: U301.40 (GL_B); also elsewhere on the board
GL_C: U301.35 (GL_C); also elsewhere on the board
INH_A: U301.17 (INH_A); also elsewhere on the board
INH_B: U301.19 (INH_B); also elsewhere on the board
INH_C: U301.21 (INH_C); also elsewhere on the board
INL_A: U301.18 (INL_A); also elsewhere on the board
INL_B: U301.20 (INL_B); also elsewhere on the board
INL_C: U301.22 (INL_C); also elsewhere on the board
M_OC: U301.9 (M_OC); also elsewhere on the board
M_PWM: U301.8 (M_PWM); also elsewhere on the board
NFAULT: R303.1, U301.6 (NFAULT); also elsewhere on the board
NOCTW: R304.1, U301.5 (NOCTW); also elsewhere on the board
unnamed: C318.2, R306.2
unnamed: C316.1, D301.1 (K), L301.2, U301.50 (PH), U301.51 (PH)
unnamed: C305.1, U301.49 (BIAS)
unnamed: C306.1, U301.48 (BST_A)
unnamed: C307.1, U301.43 (BST_B)
unnamed: C316.2, U301.52 (BST_BK)
unnamed: C308.1, U301.38 (BST_C)
unnamed: C317.1, R306.1, U301.2 (COMP)
unnamed: C303.1, U301.14 (CP1)
unnamed: C303.2, U301.15 (CP2)
unnamed: R305.1, U301.7 (DTC)
unnamed: R310.2, R311.1, TP7.1, U301.11 (OC_ADJ)
unnamed: R307.1, U301.1 (RT_CLK)
unnamed: R302.1, U301.25 (SO1)
unnamed: R301.1, U301.26 (SO2)
unnamed: C304.1, U301.56 (SS_TR)
unnamed: R308.1, R309.2, TP8.1, U301.3 (VSENSE)
PVDD: C311.1, C312.1, C314.1, C315.1, R313.2, TP14.1, U301.29 (PVDD1), U301.53 (PVDD2), U301.54 (PVDD2); also elsewhere on the board
PVDD_SENSE: C321.1, D302.2 (A), R312.2, R313.1, TP6.1; also elsewhere on the board
SH_A: C306.2, U301.46 (SH_A); also elsewhere on the board
SH_B: C307.2, U301.41 (SH_B); also elsewhere on the board
SH_C: C308.2, U301.36 (SH_C); also elsewhere on the board
SL_A: U301.33 (SN1), U301.44 (SL_A); also elsewhere on the board
SL_B: U301.31 (SN2), U301.39 (SL_B); also elsewhere on the board
SO1: C309.1, R302.2; also elsewhere on the board
SO2: C310.1, R301.2; also elsewhere on the board

Notes on the sheet:
SHORT TRACES !!
DIFF PAIRS
Recommended 0.8V (92% - 109%)
40A x 2.4mΩ = 0.1V
PVDD1 for gate driver, PVDD2 for buck conv
Remember SH_X pins must be under 8.5V when DRV is enabled through EN

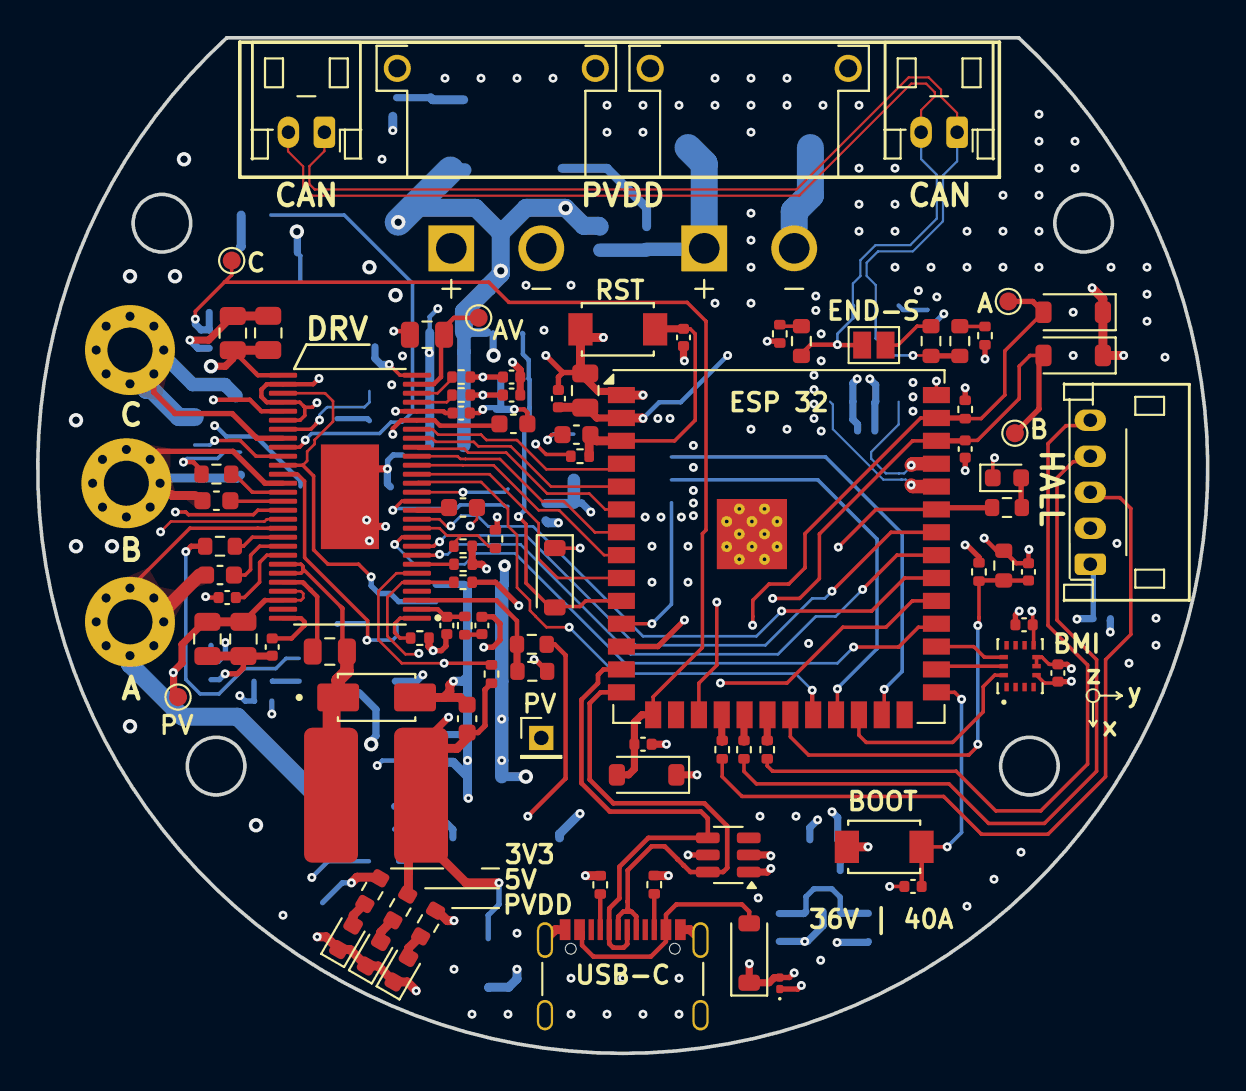
[picture p143: board ESP32_Motor_Controller.kicad_pcb from above]

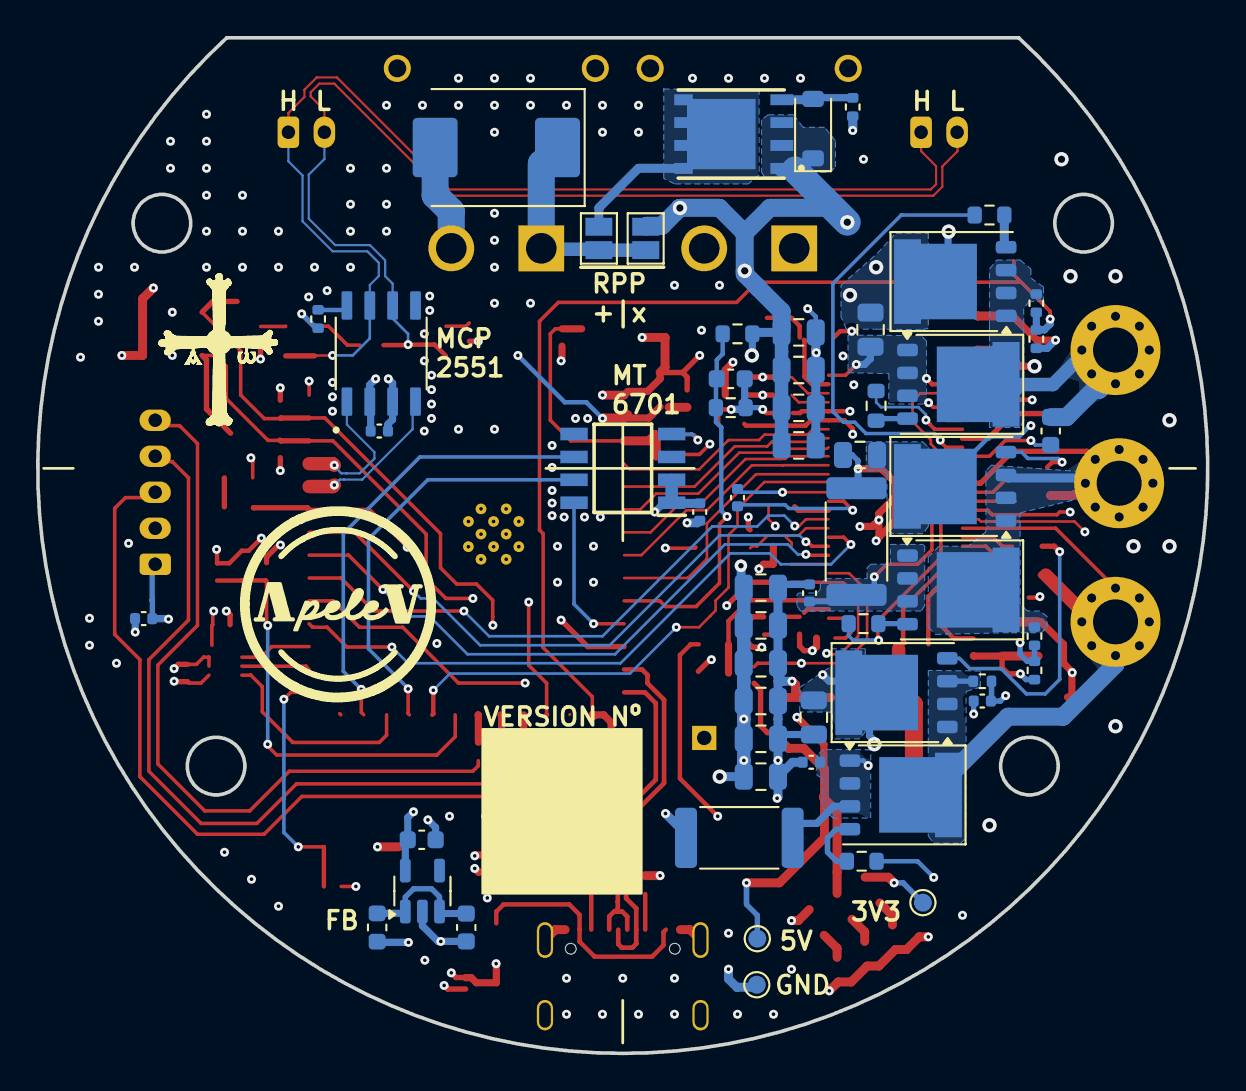
[picture p144: board ESP32_Motor_Controller.kicad_pcb from below]

Board: 4 copper layers, 65.0 x 56.4 mm, 154 parts (60 on the bottom side), 96 nets.

Other parts of the board:
A: A_SENSE; TestPoint_Pad_D1.0mm
AV: AVDD; TestPoint_Pad_D1.0mm
B: B_SENSE; TestPoint_Pad_D1.0mm
C: C_SENSE; TestPoint_Pad_D1.0mm
ESP 32: ESP32-S3-WROOM-1; ESP32-S3-WROOM-1U
FB: -k; L_0603_1608Metric
GND: GND; TestPoint_Pad_D1.0mm
PV: PVDD; TestPoint_Pad_D1.0mm
USB-C: USB_C 3.1; USB_C_Receptacle_Palconn_UTC16-G

Their connections:
3V3: ESP 32.2 (3V3); also elsewhere on the board
5V: FB.1; also elsewhere on the board
/CONTROLLER/BOOT: ESP 32.27 (GPIO0/BOOT); also elsewhere on the board
/CONTROLLER/EN: ESP 32.3 (EN); also elsewhere on the board
/GATE DRIVER/AVDD: AV.1; also elsewhere on the board
AGND: ESP 32.1 (GND), ESP 32.40 (GND), ESP 32.41 (GND), GND.1, USB-C.A1 (GND), USB-C.A12 (GND), USB-C.B1 (GND), USB-C.B12 (GND), USB-C.S1 (SHIELD); also elsewhere on the board
A_SENSE: A.1, ESP 32.39 (GPIO1/TOUCH1/ADC1_CH0); also elsewhere on the board
BMI_CS: ESP 32.29 (SPIIO7/GPIO36/FSPICLK/SUBSPICLK); also elsewhere on the board
BMI_SCK: ESP 32.28 (SPIIO6/GPIO35/FSPID/SUBSPID); also elsewhere on the board
BMI_SDA: ESP 32.24 (GPIO47/SPICLK_P/SUBSPICLK_P_DIFF); also elsewhere on the board
B_SENSE: B.1, ESP 32.38 (GPIO2/TOUCH2/ADC1_CH1); also elsewhere on the board
CAN_RX: ESP 32.36 (U0RXD/GPIO44/CLK_OUT2); also elsewhere on the board
CAN_TX: ESP 32.37 (U0TXD/GPIO43/CLK_OUT1); also elsewhere on the board
C_SENSE: C.1, ESP 32.15 (GPIO3/TOUCH3/ADC1_CH2); also elsewhere on the board
DC_CAL: ESP 32.32 (MTCK/GPIO39/CLK_OUT3/SUBSPICS1); also elsewhere on the board
EN_GATE: ESP 32.22 (GPIO14/TOUCH14/ADC2_CH3/FSPIWP/FSPIDQS/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); also elsewhere on the board
GAIN: ESP 32.30 (SPIDQS/GPIO37/FSPIQ/SUBSPIQ); also elsewhere on the board
HALL_A: ESP 32.18 (GPIO10/TOUCH10/ADC1_CH9/FSPICS0/FSPIIO4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); also elsewhere on the board
HALL_B: ESP 32.19 (GPIO11/TOUCH11/ADC2_CH0/FSPID/FSPIIO5/S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); also elsewhere on the board
HALL_C: ESP 32.20 (GPIO12/TOUCH12/ADC2_CH1/FSPICLK/FSPIIO6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); also elsewhere on the board
INH_A: ESP 32.9 (GPIO16/U0CTS/ADC2_CH5/XTAL_32K_N); also elsewhere on the board
INH_B: ESP 32.7 (GPIO7/TOUCH7/ADC1_CH6); also elsewhere on the board
INH_C: ESP 32.5 (GPIO5/TOUCH5/ADC1_CH4); also elsewhere on the board
INL_A: ESP 32.8 (GPIO15/U0RTS/ADC2_CH4/XTAL_32K_P); also elsewhere on the board
INL_B: ESP 32.6 (GPIO6/TOUCH6/ADC1_CH5); also elsewhere on the board
INL_C: ESP 32.4 (GPIO4/TOUCH4/ADC1_CH3); also elsewhere on the board
MAG_CLK: ESP 32.23 (GPIO21); also elsewhere on the board
MAG_CSN: ESP 32.11 (GPIO18/U1RXD/ADC2_CH7/CLK_OUT3); also elsewhere on the board
MAG_DO: ESP 32.25 (GPIO48/SPICLK_N/SUBSPICLK_N_DIFF); also elsewhere on the board
M_OC: ESP 32.34 (MTDI/GPIO41/CLK_OUT1); also elsewhere on the board
M_PWM: ESP 32.33 (MTDO/GPIO40/CLK_OUT2); also elsewhere on the board
NFAULT: ESP 32.35 (MTMS/GPIO42); also elsewhere on the board
NOCTW: ESP 32.31 (GPIO38/FSPIWP/SUBSPIWP); also elsewhere on the board
NTC: ESP 32.21 (GPIO13/TOUCH13/ADC2_CH2/FSPIQ/FSPIIO7/S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); also elsewhere on the board
unnamed 50: USB-C.A4 (VBUS), USB-C.A9 (VBUS), USB-C.B4 (VBUS), USB-C.B9 (VBUS); also elsewhere on the board
unnamed 66: FB.2; also elsewhere on the board
unnamed 83: USB-C.A5 (CC1); also elsewhere on the board
unnamed 84: USB-C.B5 (CC2); also elsewhere on the board
PVDD: PV.1; also elsewhere on the board
PVDD_SENSE: ESP 32.10 (GPIO17/U1TXD/ADC2_CH6); also elsewhere on the board
SO1: ESP 32.12 (GPIO8/TOUCH8/ADC1_CH7/SUBSPICS1); also elsewhere on the board
SO2: ESP 32.17 (GPIO9/TOUCH9/ADC1_CH8/FSPIHD/SUBSPIHD); also elsewhere on the board
USB_DN: ESP 32.13 (GPIO19/U1RTS/ADC2_CH8/CLK_OUT2/USB_D-), USB-C.A7 (D-), USB-C.B7 (D-); also elsewhere on the board
USB_DP: ESP 32.14 (GPIO20/U1CTS/ADC2_CH9/CLK_OUT1/USB_D+), USB-C.A6 (D+), USB-C.B6 (D+); also elsewhere on the board
