Angelpele/Integrated_FOC_BLDC_Actuator/Firmware/main/MCP2551.cpp

//===================================================================================================//
//                                            MCP2551 CAN                                            //
//                                            Transceiver                                            //
//===================================================================================================//

#include "MCP2551.h"

template bool CAN::sendData<CANPacket>(const CANPacket& data, uint8_t ID);
template bool CAN::sendData<MasterPacket>(const MasterPacket& data, uint8_t ID);

template bool CAN::receiveData<CANPacket>(CANPacket* packet, uint8_t expected_id);
template bool CAN::receiveData<MasterPacket>(MasterPacket* packet, uint8_t expected_id);

int CAN::init()
{
    gpio_set_direction(CAN_RX, GPIO_MODE_INPUT);
    gpio_set_direction(CAN_TX, GPIO_MODE_OUTPUT); 
        
    twai_general_config_t g = TWAI_GENERAL_CONFIG_DEFAULT(CAN_TX, CAN_RX, TWAI_MODE_NORMAL);
    twai_timing_config_t  t = TWAI_TIMING_CONFIG_1MBITS();
    twai_filter_config_t  f = TWAI_FILTER_CONFIG_ACCEPT_ALL();      // Change filter to accept specific IDs

    if (twai_driver_install(&g, &t, &f) != ESP_OK) {
        printf("CAN INIT: Failed to install TWAI driver\n");
        return -1;
    }
    if (twai_start() != ESP_OK) {
        printf("CAN INIT: Failed to start TWAI driver\n");
        return -1;
    }
    return 0;
}

int CAN::test()
{
    TelemetryPacket test = {};
    test.ID   = MOTOR_ID;
    test.pvdd = 10.0f;   
    test.rpm  = 1234.0f;

    // Send dummy packet
    if (!sendData(&test, MOTOR_ID)) {
        printf("CAN TEST: TX failed\n");
        return -1;
    }
    return 0;
}

template <typename T>
bool CAN::sendData(const T& data, uint8_t ID)
{
    const uint8_t* raw = (const uint8_t*)&data;
    size_t total = sizeof(T);
    uint8_t num_chunks = (total + CHUNK_PAYLOAD - 1) / CHUNK_PAYLOAD;
    if (num_chunks > 15) return false; // Too large to send

    for (uint8_t i = 0; i < num_chunks; i++) {
        twai_message_t msg = {};
        msg.identifier       = ID;
        msg.extd             = 0;
        msg.rtr              = 0;
        msg.dlc_non_comp     = 0;
        msg.data_length_code = 8;

        size_t offset    = (size_t)i * CHUNK_PAYLOAD;
        size_t remaining = total - offset;
        size_t chunk_len = (remaining >= CHUNK_PAYLOAD) ? CHUNK_PAYLOAD : remaining;

        msg.data[0] = ((num_chunks & 0x0F) << 4) | (i & 0x0F);
        memset(&msg.data[1], 0, CHUNK_PAYLOAD);
        memcpy(&msg.data[1], raw + offset, chunk_len);

        if (twai_transmit(&msg, pdMS_TO_TICKS(100)) != ESP_OK) {return false;}
        vTaskDelay(pdMS_TO_TICKS(TX_GAP_MS));
    }
    return true;
}

// Clean up and reset state for new packet reception
void CAN::reset_rx_state() {
    memset(rx_buf, 0, sizeof(rx_buf));
    chunks_received = 0;
    expected_chunks = 0;
    chunks_mask     = 0;  
}


bool CAN::process_frame(const twai_message_t* msg)
{
    uint8_t seq       = msg->data[0];
    uint8_t total     = (seq >> 4) & 0x0F;
    uint8_t chunk_idx = seq & 0x0F;

    // Reset received data if timeout since last chunk
    if (chunks_received > 0 && ((esp_timer_get_time() / 1000) - last_chunk_ms) > RX_TIMEOUT_MS)
        reset_rx_state();

    // chunk 0 always starts a new packet
    if (chunk_idx == 0) {
        reset_rx_state();
        expected_chunks = total;
    } else if (expected_chunks == 0) {
        return false; // missed chunk 0, wait for next burst
    }

    // Discard if sequence is inconsistent
    if (total != expected_chunks || chunk_idx >= total)  { reset_rx_state(); return false; }
    if (chunks_mask & (1 << chunk_idx))                    return false;

    // Copy payload into buffer
    size_t offset    = (size_t)chunk_idx * CHUNK_PAYLOAD;
    size_t copy_len  = CHUNK_PAYLOAD;
    if (offset + copy_len > MAX_CAN_PACKET_SIZE) { reset_rx_state(); return false; }

    memcpy(rx_buf + offset, &msg->data[1], copy_len);

    chunks_mask |= (1 << chunk_idx);
    chunks_received++;
    last_chunk_ms = esp_timer_get_time() / 1000;  

    return (chunks_received == expected_chunks);    // Return true if packet is complete
}

template <typename R>
bool CAN::receiveData(R* packet, uint8_t expected_id) {
    twai_message_t msg;
    while (true) {
        // Block indefinitely until a frame arrives — never misses a frame
        if (twai_receive(&msg, portMAX_DELAY) == ESP_OK) {
            if (msg.identifier != expected_id) {
                continue; // Ignore frames with unexpected ID
            }
            if (process_frame(&msg)) {
                memcpy(packet, rx_buf, sizeof(R));
                reset_rx_state();
                return true;
            }
        }
    }
}
