Angelpele/Integrated_FOC_BLDC_Actuator/(commit log)

2025-11-03 Finished Schematics
2025-11-13 PCB Layout Update
2026-03-08 PCB V2, CAD V3 & Code
2026-03-20 Definitive CAD
2026-04-02 Code update
    Motor moving
2026-04-03 Updated Code - Fast spin, No shake
    Closed loop with magnet
2026-04-15 Create Front PCB soldered crop.jpg
2026-04-15 Update README with improved SPWM stage details
    Clarified description of the Closed Loop SPWM stage in the README.
2026-05-05 Buck Components Update
2026-05-08 CAN_Bus
    MCP2551 is transmitting packets
2026-05-12 Update FOC PID tunning
2026-06-21 Reducer PID Controller Calibrated
2026-07-25 Working HALL Sensor
2026-08-29 BOM Update
2026-09-26 Update FOC Hover
    Right Constants for torque mode
2026-09-29 Completed PID Wheel Hoverboard
